mkramar/dizzyrobot/3D/3D - Motor 6.1 - presss fit/05.png

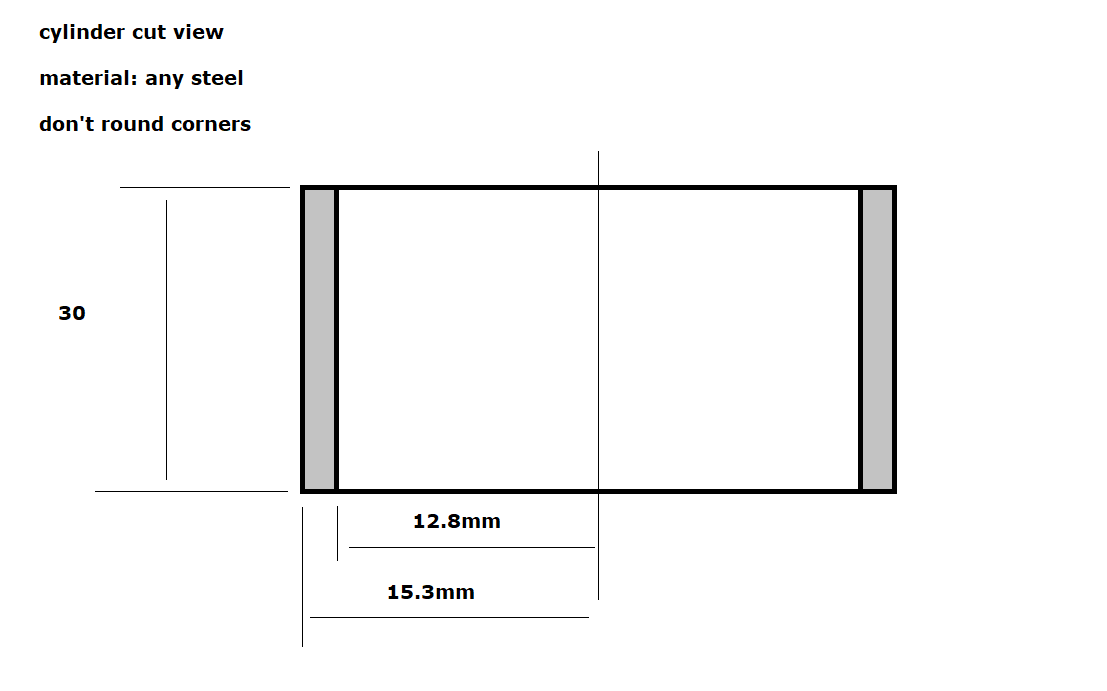
3D/3D - Motor 6.1 - presss fit/05.png
