mkramar/dizzyrobot/3D/3D - Press Fit/6-01.png

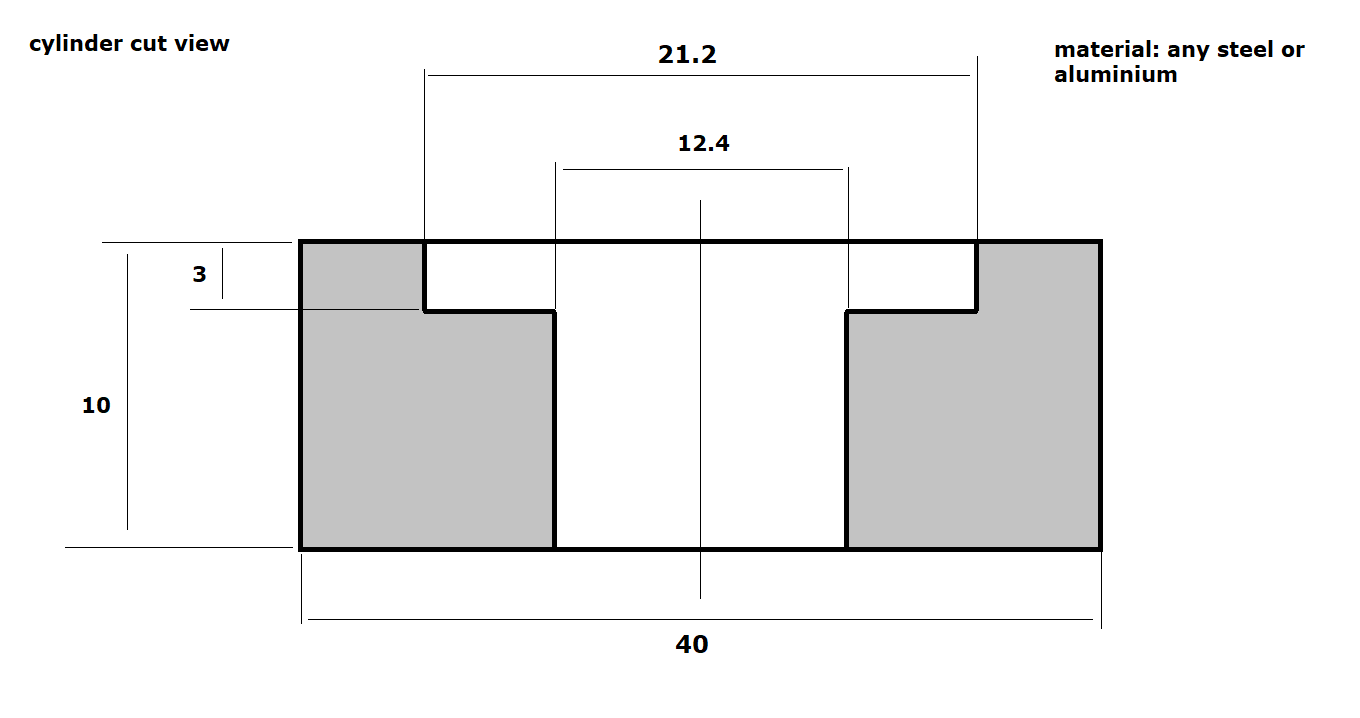
3D/3D - Press Fit/6-01.png
