mkramar/dizzyrobot/3D/3D - Press Fit/8-03.png

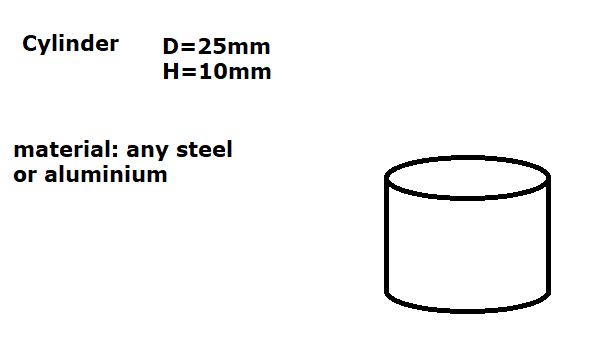
3D/3D - Press Fit/8-03.png
