mkramar/dizzyrobot/3D/3D - Press Fit/8-04.png

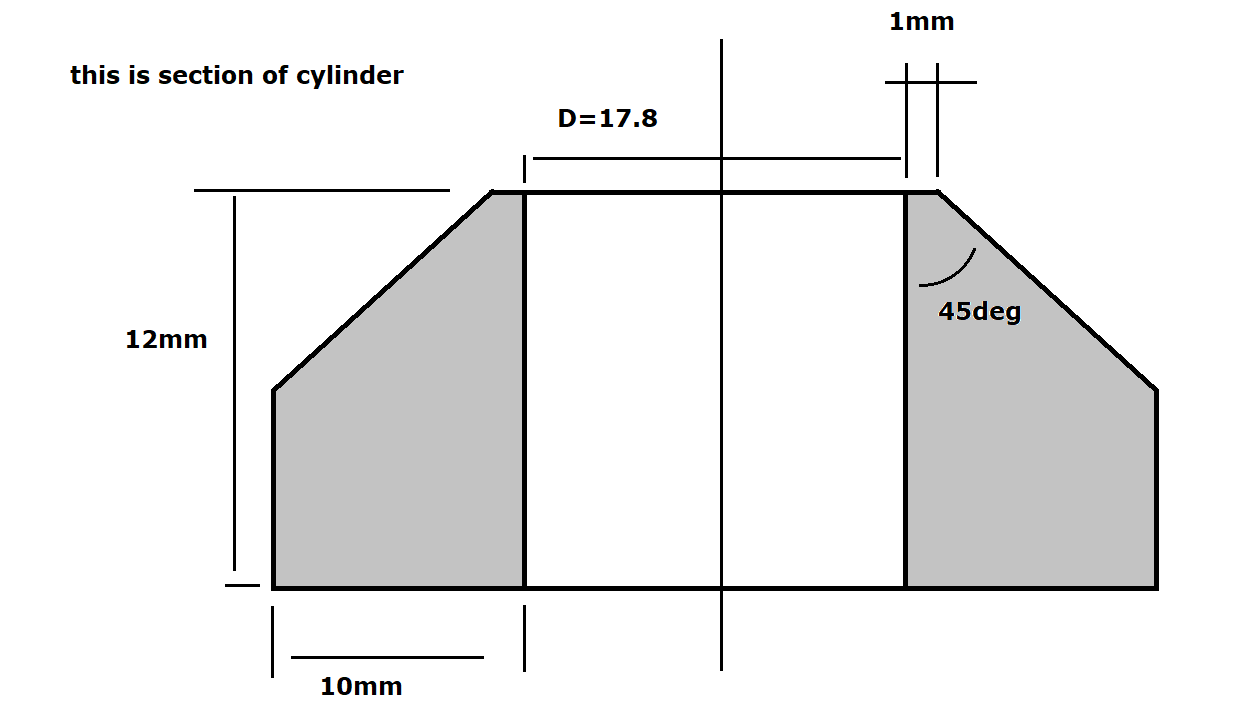
3D/3D - Press Fit/8-04.png
