mkramar/dizzyrobot/Schamatic/BOM.xlsx

Sheet: Motor
Description | Part | References | Value | Voltage | Footprint | Quantity Per PCB | Avail
 | C_Small | C10 | 0.01uF | 50V | C_0603 | 1 | 11 | 11
 | C_Small | C1 C6 C7 C12 C14 | 0.1uF | 6.3V | C_0603 | 5 | 5 | 1
 | C_Small | C2 C4 C5 C8 C9 | 1uF | 25V | C_0603 | 5 | 80 | 16
 | C_Small | C3 | 2.2uF | 100V | C_1206 | 2 | 2 | 1
 | C_Small | C11 | 4.7uF |  | C_1206 | 1 | 0 | 0
Diode 100V | D_Small | D3 D4 D5 D6 D8 | D |  | D_SOD-323F | 5 | 12 | 2.4
 | LED_Small | D1 D2 D7 | LED_Small |  | LED_0603 | 3 | 0 | 0
SWD | CONN_02X05 | J1 | CONN_02X05 |  | Pin_Header_Straight_2x05_Pitch1.27mm_SMD | 1 | 3 | 3
 | CONN_01X02 | J2 J3 | RS485 |  | Pin_Header_Straight_1x02_Pitch2.54mm | 2 |  | 0
 | L_Small | L2 | 220uH |  | L_1210 | 1 | 3 | 3
 | R_Small | R11 R13 | 10K | 1% | C_0603 | 2 | 17 | 8.5
 | R_Small | R14 | 1Ohm |  | C_0603 | 1 | 50 | 50
 | R_Small | R10 | 237K |  | R_0603 | 1 | 0 | 0
 | R_Small | R12 | 30k 1% |  | C_0603 | 1 | 16 | 16
 | R_Small | R1 R2 | 390 Ohm |  | R_0603 | 2 | 50 | 25
 | R_Small | R15 | 600 Ohm |  | R_0603 | 1 | 50 | 50
Button | B3U-1000P | SW1 SW2 | B3U-1000P |  | R_1206 | 2 | 0 | 0
Angle sensor | MA700 | U6 | MA700 |  |  | 1 | 4 | 4
half-bridge |  |  | IRSM005 |  |  | 3 | 0 | 0
100V buck | LM5019 | U4 | LM5019 |  | DFN-8-1EP_4x4mm_Pitch0.8mm | 1 | 0 | 0
RS485 | LTC2876 | U2 | LTC2876 |  | LTC2876 | 1 | 1 | 1
Microcontroller | STM32F031G6U6 | U5 | STM32F031K6U6 |  | UFQFPN32-small-pad | 1 | 1 | 1
3.3V linear regulator | TPS73433DRV | U1 | TPS73433DRV |  | DFN-6-1EP_2x2mm_Pitch0.65mm | 1 | 2 | 2
12V linear regulator | MCP1703A-1502/MB | U3 | ZXTR2012Z |  | SOT-89-3 | 1 | 2 | 2
 | Resonator | Y1 | 8MhZ |  | Oscillator | 1 | 8 | 8

Sheet: Mainboard
Description | Part | References | Value | Voltage | Footprint | Quantity Per PCB | Avail
 | C_Small | C7 C8 | 0.01uF | 50V | C_0603 | 2 |  | 0
Boost RC | C_Small | C6 | 0.022uF | 25V | C_0603 | 1 | 5 | 5
 | C_Small | C15 | 0.1uF | 25V | C_0805 | 1 | 8 | 8
 | C_Small | C19 C20 C21 C23 C24 C25 C26 | 0.1uF | 6.3V | C_0603 | 7 |  | 0
Bushbutton timer | C_Small | C27 | 0.33uF | 25V | C_0603 | 1 | 0 | 0
 | C | C4 C14 | 1uF | 25V | C_0603 | 2 |  | 0
 | C_Small | C12 C13 C28 C29 | 100uF | 6.3V | C_1210 | 4 | 7 | 1.75
 | C | C1 | 2.2uF | 25V | C_0603 | 1 | 0 | 0
 | C_Small | C2 C3 C9 C10 | 20uF |  | C_1210 | 4 | 6 | 1.5
 | C | C17 C18 | 3.3uF | 100V | C_1812 | 2 | 0 | 0
 | C_Small | C22 | 4.7uF | 25V | C_1812 | 1 | 0 | 0
 | D_Small | D8 | D_Small | 200V | D_SMA | 1 | 3 | 3
 | D_Small | D1 D2 D3 D4 D8 | D_Small | 50V | D_SMA | 4 | 10 | 2.5
 | D_Small | D5 | D_Small |  | D_SOD-323 | 1 |  | 0
 | LED_Small | D6 D7 | LED_Small |  | LED_0603 | 2 |  | 0
RS485 connector | CONN_01X02 | J1 J2 | CONN_01X02 |  | Pin_Header_Straight_1x02_Pitch2.54mm | 2 | 8 | 4
voltage connector |  | J8 J9 |  |  |  | 2 |  | 0
 | CONN_01X02 | J3 | CONN_01X02 |  | XT60 | 1 |  | 0
 | CONN_01X02 | J4 J5 | CONN_01X02 |  | xt30 | 2 |  | 0
Pushbutton connector | CONN_01X04 | J10 | CONN_01X04 |  | Pin_Header_Straight_1x04_Pitch2.54mm | 1 | 1 | 1
SWD | CONN_02X05 | J6 | CONN_02X05 |  | Pin_Header_Straight_2x05_Pitch1.27mm_SMD | 1 |  | 0
Rpi connector | CONN_02X20 | J7 | CONN_02X20 |  | Pin_Header_Straight_2x20_Pitch2.54mm | 1 | 1 | 1
 | L_Small | L1 | 15uH |  | L_10.4x10.4_H4.8 | 1 | 1 | 1
 | L_Small | L2 | 22uH |  | L_10.4x10.4_H4.8 | 1 |  | 0
 | L_Core_Ferrite | L3 | L_Core_Ferrite |  |  | 1 | 1 | 1
MOSFET 100V | PSMN014-40YS | Q1 Q2 Q3 Q4 | PSMN014-40YS |  | PSMN3R3-40YS | 4 | 15 | 3.75
Current sense resistor | R_Small | R7 | 1.5mOhm |  | R_2512 | 1 | 2 | 2
 | R_Small | R2 R3 | 10Ohm |  | R_0603 | 2 | 50 | 25
 | R_Small | R4 R15 R16 R21 | 10k |  | R_0603 | 4 |  | 0
Boost | R_Small | R6 | 18K |  | R_0603 | 1 | 12 | 12
 | R_Small | R11 R13 | 1k 1% |  | R_0603 | 2 | 90 | 45
 | R_Small | R1 | 3.3Ohm |  | R_0603 | 1 | 0 | 0
 | R_Small | R9 | 30k |  | R_0603 | 1 |  | 0
 | R_Small | R5 R19 R20 | 390Ohm |  | R_0603 | 3 |  | 0
I-ADC | R_Small | R17 | 4k | 1% | R_0603 | 1 | 7 | 7
V-ADC | R_Small | R14 | 62k | 1% | R_0603 | 1 | 7 | 7
 | R_Small | R8 | 68K |  | R_0603 | 1 | 7 | 7
I-ADC | R_Small | R18 | 6k | 1% | R_0603 | 1 | 15 | 15
 | R_Small | R10 | 75k (67, 58) |  | R_0603 | 1 | 7 | 7
Current sensor | ACS781 | U6 | ACS781 |  | ACS781 | 1 | 0 | 0
3.3V buck | LM2678 | U1 | LM2678-3.3V |  | 14-VSON | 1 | 1 | 1
 | LM2678 | U2 | LM2678-5V |  | 14-VSON | 1 |  | 0
100V boost | LM5121 | U4 | LM5121 |  | HTSSOP-20-1EP_4.4x6.5mm_Pitch0.65mm_ThermalPad | 1 | 2 | 2
Accelerometer | LSM6DS33 | U7 | LSM6DS33 |  | LGA16R50P3X5_300X300X100 | 1 | 2 | 2
 | LTC2876 | U9 | LTC2876 |  | LTC2876 | 1 |  | 0
Bushbutton | LTC2954 | U10 | LTC2954 |  | 8-DFN-DDB | 1 | 1 | 1
 | STM32F031G6U6 | U8 | STM32F031G6U6 |  | UFQFPN32-small-pad | 1 |  | 0
Three pin ceramic resonator | Resonator_Small | Y1 | Resonator_Small |  | Oscillator | 1 |  | 0
