mkramar/dizzyrobot/Electronics/Motor/Bom.xlsx

Part | References | Value | Voltage | Footprint | Per PCB | In Stock | Can Make | Order
Cap | C7 C8 | 0.1uF | 6.3V | 0603 | 2 | 60 | 30 | 0
Cap | C1 | 100uF | 4V | 0805 | 1 | 10 | 10 | 10
Cap | C3 C9 | 2uF | 50V | 1206 | 2 | 24 | 12 | 16
Cap | C4 C5 C6 | 1uF | 25V | 0603 | 3 | 40 | 13.33333333 | 20
Cap | C2 | 22uF | 25V | 0805 | 1 | 12 | 12 | 8
Diode | D1 D4 | CD0603-B0340R | 100V | D_SOD-323F | 1 | 80 | 80 | 0
LED | D5 |  |  | 0805 | 1 | 0 | 0 | 20
BUTTON | ID1 |  |  | 1206 | 1 | 0 | 0 | 20
CONN_02X05 | J5 | JTAG |  |  | 1 | 5 | 5 | 15
CONN_01X02 | J2 J3 | RS485 |  |  | 2 | 7 | 3.5 | 33
L | L1 | 22uH |  | 1210 | 1 | 10 | 10 | 10
MOSFET | Q1 Q2 Q3 Q4 Q5 Q6 | PSMN3R3-40YS |  | PSMN3R3-40YS | 6 | 58 | 9.666666667 | 62
R | R3 R4 R5 R6 R7 R8 | 10 Ohm |  | 0603 | 6 | 70 | 11.66666667 | 50
R | R10 | 10k |  | 0604 | 1 | 70 | 70 | 0
R | R2 | 390 Ohm |  | 0605 | 1 | 25 | 25 | 0
LTC2876 | U2 | LTC2876 |  |  | 1 | 4 | 4 | 16
MA700 | U3 | MA700 |  |  | 2 | 6 | 3 | 34
STSPIN32F0 | U1 | STSPIN32F0 |  |  | 1 | 8 | 8 | 12
Resonator | Y1 | 8Mhz |  |  | 1 | 7 | 7 | 13
 |  |  |  | Req | 20
