mkramar/dizzyrobot/Electronics/Mainboard/Schematic/BOM.xlsx

Description | Part | References | Value |  | Footprint | Quantity Per PCB | Stock | Order
Buck boost capacitor | C | C7 C8 | 0.01uF | 25V | 0603 | 2 | 7
Delimiting capacitors | C | C6 C19 C20 C21 C23 C24 C25 C26 | 0.1uF | 25V | 0603 | 8 | 100
Off timeout capacitor | C | C27 | 0.33uF |  | 0603 | 1 | 8
Buck output | C | C13 C29 | 100uF | 16V | 1210 | 2 | 0 | 6
Buck output | C | C12 C28 | 100uF | 4V | 1210 | 2 | 3 | 5
Buck input | C |  | MAX | 50V | 1210 | 4 | 0 | 10+
Battery input/output | C | C22 | MAX | 50V | 1812 | 2 | 0 | 10+
Diode | D | D1 D2 D3 D4 D8 | D_Small |  | D_SMA | 6 | 1 | 15
LED | LED | D6 D7 | LED_Small |  | LED_0603 | 2 | 30
JTAG | 10-pin | J6 | CONN_02X05 |  | Pin_Header_Straight_2x05_Pitch1.27mm_SMD | 1 | 10
SPI/POWER | 20-pin | J7 | CONN_02X10 |  | Pin_Header_Straight_2x10_Pitch2.54mm_SMD | 1 | 2
3.3V inductor | L | L1 | 15uH |  | L_10.4x10.4_H4.8 | 1 | 1 | 1
12V inductor | L | L2 | 33uH |  | L_10.4x10.4_H4.8 | 1 | 1 | 1
P-MOSFET |  | Q2 |  | 100V 60A |  | 1 | 2 | 2 | - higher current
N-MOSFET |  | Q1 |  | 100V |  | 1 | 8
R | R | R4 R15 R16 R21 | 10k |  | 0603 | 4 | 6 | 10+
R | R | R13, R11 | 1k 1% |  | 0603 | 1 | 100
R | R | R6 | 30K |  | 0603 | 1 | 100
R | R | R5 R19 R20 | 390 Ohm |  | 0603 | 3 | 100
R | R | R17 | 4k | 1% | 0603 | 1 | 10
R | R | R14 | 30K 1% |  | 0603 | 1 | 100
R | R | R18 | 6k | 1% | 0603 | 1 | 12
Current sensor | ACS781 | U6 |  |  |  | 1 | 1 | 2
 | LM2678 | U2 | LM2678-12V |  | 14-VSON | 1 | 11
 | LM2678 | U1 | LM2678-3.3V |  | 14-VSON | 1 | 1 | 2
Gyro | LSM6DS33 | U7 |  |  |  | 1 | 1 | 2
RS485 | LTC2876 | U9 | LTC2876 |  | LTC2876 | 1 | 11
Push button controller | LTC2954 | U10 | LTC2954 |  | 8-DFN-DDB | 1 | 2 | 1
MCU | STM32F031G6U6 | U8 | STM32F031G6U6 |  | UFQFPN32-small-pad | 1 | 1 | 2
Ceramic resonator | Resonator_Small | Y1 | Resonator_Small |  | Oscillator | 1 | 1 | 2
12 Linear Regulator |  |  | ZXTR2012Z |  |  | 1 | 1 | 2
 | To Make: | 3
