mkramar/dizzyrobot/3D/3D - Motor 5/ECG S assembly.SLDASM

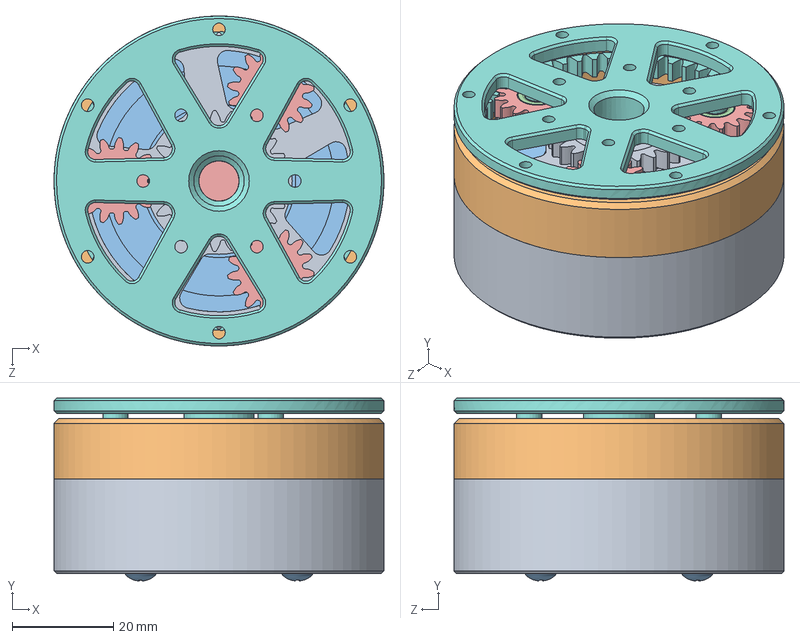
[picture p12: CAD file, 2018-11-04]
3D/3D - Motor 5/ECG S assembly.SLDASM
65.3 x 36.1 x 65.3 mm
Housing base
Housing top cover
Motor core S
Rotor magnet ring
M07900 slipring
PCB S
Magnetinc position ring
External rotor
Internal rotor
6701 - 12x18x4 mm x 3
92000A076_18-8 SS METRIC PAN HEAD PHIL MACHINE SCREW x 4
7804K126_STAINLESS STEEL BALL BEARING x 3
Planet gear M1 Z15 bore 8 x 3
M1408-0120 x 3
Positioning magnet x 14
Ring gear M1 Z56 OD62
Sun gear M1 Z25 bore 20 CD20.5
