mkramar/dizzyrobot/3D/3D - Motor 6.1/motor 6/Gearing assembly.SLDASM

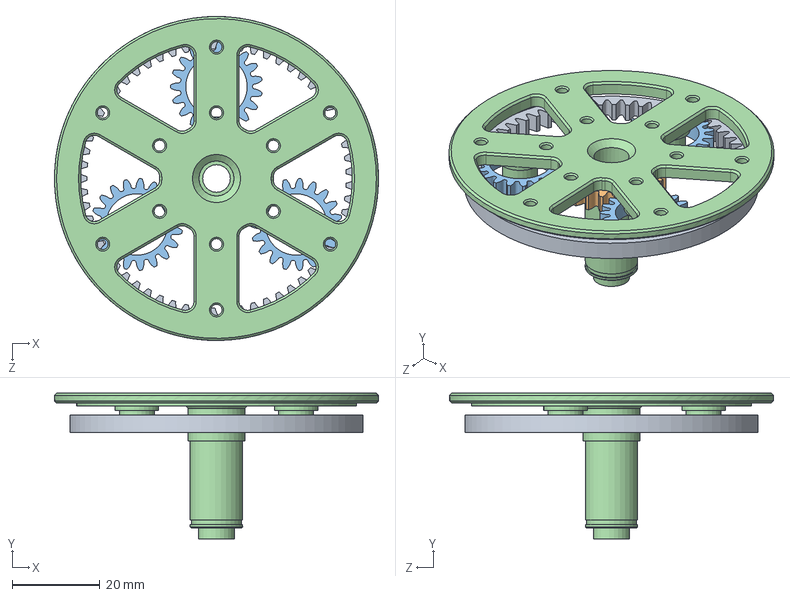
[picture p13: CAD file, 2019-03-31]
3D/3D - Motor 6.1/motor 6/Gearing assembly.SLDASM
74.0 x 33.3 x 74.0 mm
Ring gear Z61 M1
Sun gear Z23 H17 M1
Planet gear Z19 H13 M1 x 3
