mkramar/dizzyrobot/3D/3D - Motor 8/Drawings/Gearing.SLDASM

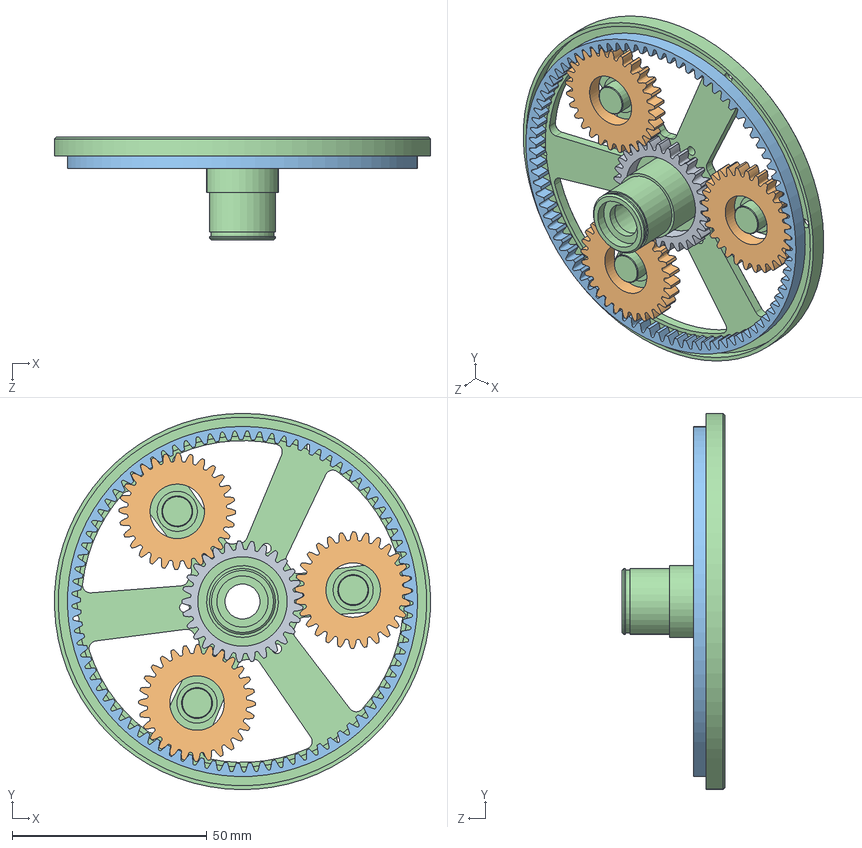
[picture p14: CAD file, 2018-12-22]
3D/3D - Motor 8/Drawings/Gearing.SLDASM
96.7 x 96.7 x 26.5 mm
Sun Gear M1 Z29 bore 23
Planet Gear M1 Z28 bore 14 x 3
Ring gear M1 Z85 OD90
