mkramar/dizzyrobot/3D/NEW MODEL/MODEL 6/ASSEMBLY/SMALL PART - MOTOR 6.SLDASM

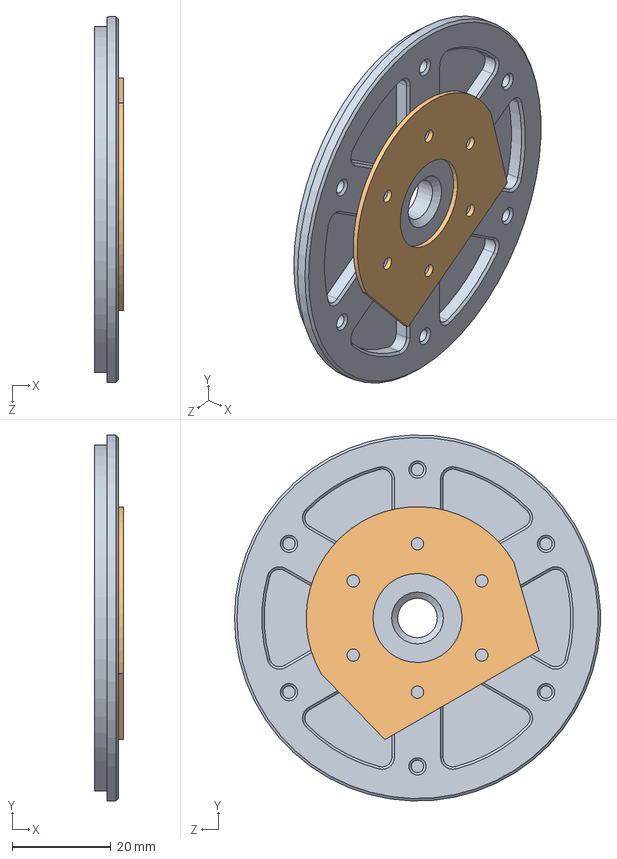
[picture p15: CAD file, 2020-03-14]
3D/NEW MODEL/MODEL 6/ASSEMBLY/SMALL PART - MOTOR 6.SLDASM
5.80 x 74.0 x 74.0 mm
PART 1 - MOTOR 6 - ROBOT DOG
SMALL CONTROLLER - ROBOT DOG
