mkramar/dizzyrobot/3D/NEW MODEL/MOTOR 8/ASSEMBLY/MOTOR 8 ASSEMBLY.SLDASM

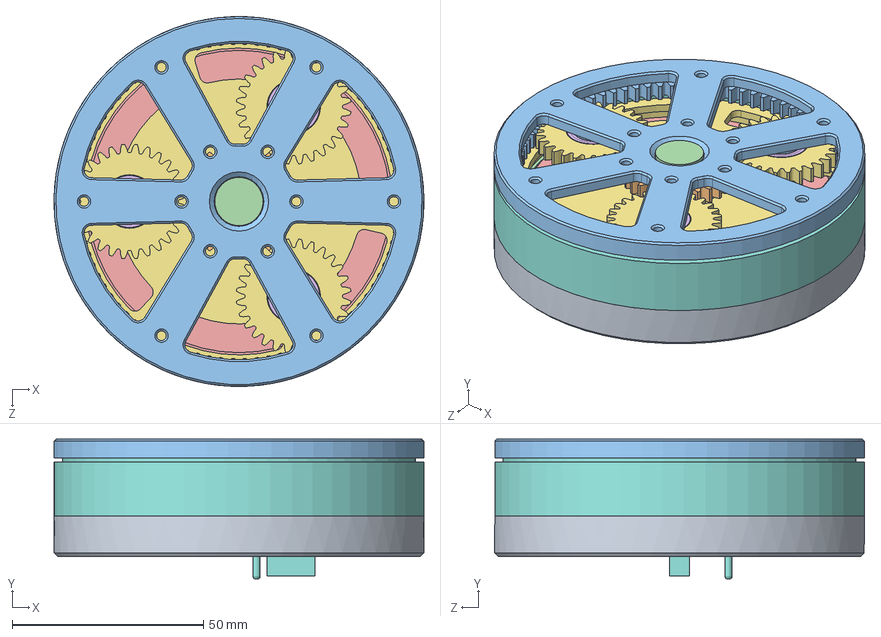
[picture p16: CAD file, 2020-03-14]
3D/NEW MODEL/MOTOR 8/ASSEMBLY/MOTOR 8 ASSEMBLY.SLDASM
96.7 x 36.5 x 96.7 mm
HOUSING BASE - MOTOR 8
6803 17x26x5 mm BEARING_5972K213 - MOTOR 8 x 2
CARRIER - MOTOR 8
SLIPRING - MOTOR 8
MAGNETING POSITION RING - MOTOR 8
6706 30x37x4 mm BEARING_5972K213 - MOTOR 8 x 2
ROTOR FRAME - MOTOR 8
HOUSING COVER - MOTOR 8
POSITIONING MAGNET . MOTOR 8 x 42
SUN GEAR M1 Z28 bore 23_GEAR TRAX - MOTOR 8
RING GEAR M1 Z84_GEAR TRAX - MOTOR 8
MAGNET RING - MOTOR 8
MOTOR CORE - MOTOR 8
148-2Z_7804K116 - MOTOR 8 x 3
PLANET GEAR M1 Z28 bore 14_GEAR TRAX - MOTOR 8 x 3
BIGGER CONTROLLER - ROBOT DOG
