mkramar/dizzyrobot/3D/ROBOT.SLDASM

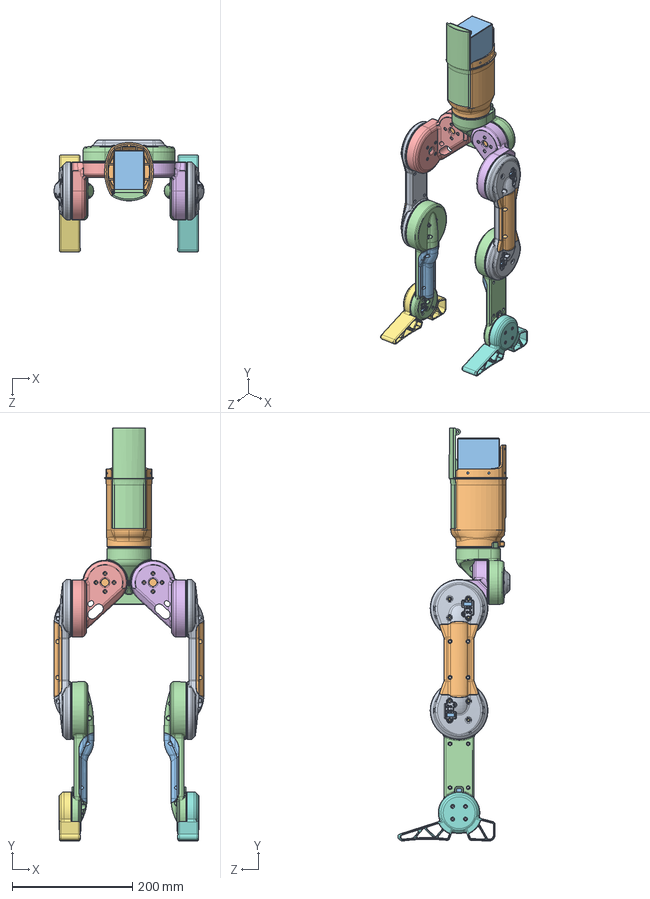
[picture p17: CAD file, 2018-05-21]
3D/ROBOT.SLDASM
249.4 x 687.0 x 187.1 mm
MOTOR 6 - BOTTOM x 3
MOTOR 6 - TOPPER x 3
BIGGER CONTROLLER x 9
ASS
ARTICULATION
MirrorARTICULATION
MOTOR 9 - BOTTOM x 4
MOTOR 9 - TOPPER x 4
THIGH x 2
COVER OF THE THIGH x 2
COVER OD THE SHIN x 2
SHIN x 2
MOTOR 5 - BOTTOM x 2
MOTOR 5 - TOPPER x 2
FOOT
MirrorFOOT
COVER OF THE ASS
TORSO
BATTERY
COVER OF THE BATTERY
