mkramar/dizzyrobot/3D/Wolf/V2/BIG PART MOTOR 8.SLDASM

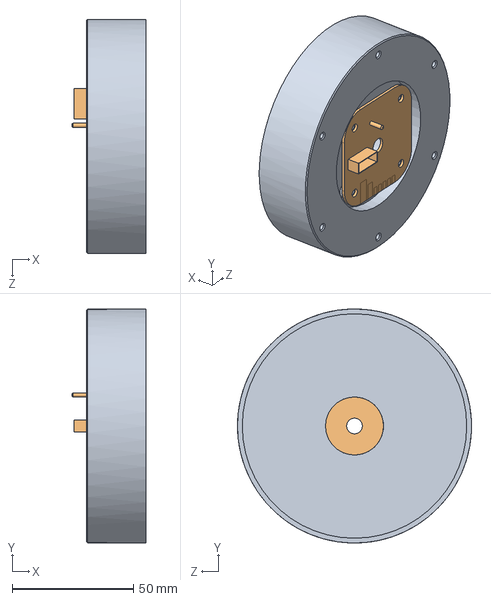
[picture p18: CAD file, 2019-07-20]
3D/Wolf/V2/BIG PART MOTOR 8.SLDASM
30.6 x 96.7 x 96.7 mm
PART 2 - MOTOR 8 - ROBOT DOG
BIGGER CONTROLLER - ROBOT DOG
