mkramar/dizzyrobot/3D/NEW MODEL/MODEL 6/ASSEMBLY/BIGGER MOTOR 6 ASSEMBLY.SLDASM

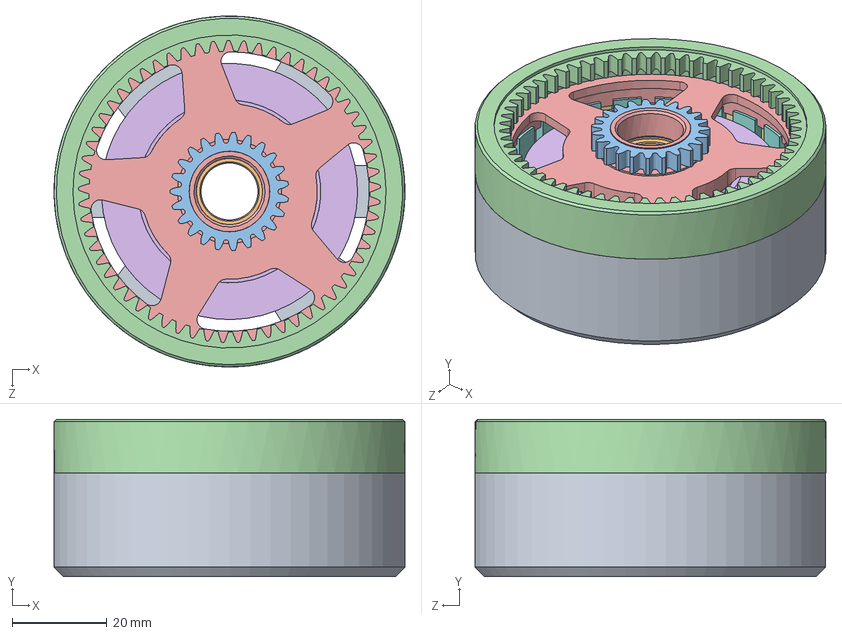
[picture p19: CAD file, 2020-03-14]
3D/NEW MODEL/MODEL 6/ASSEMBLY/BIGGER MOTOR 6 ASSEMBLY.SLDASM
74.0 x 33.2 x 74.0 mm
HOUSING BASE - MOTOR 6
6801 BEARING 12x21x5_5972K212 - MOTOR 6 x 3
12x1 mm SPACER RING - MOTOR 6 x 3
HOUSING COVER - MOTOR 6
ROTOR - MOTOR 6
STATOR - MOTOR 6
OUTER RING - MOTOR 6
ROTOR MAGNET 12x6x2 - MOTOR 6 x 22
POSITIONING MAGNET D4 - MOTOR 6 x 24
KLM-21 INTERNAL RETAINING RING FOR hID 21 mm
SUN GEAR Z23 H17 M1_GEAR TRAX - MOTOR 6
RING GEAR Z61 M1_GEAR TRAX - MOTOR 6
