mkramar/dizzyrobot/3D/NEW MODEL/MOTOR 8/ASSEMBLY/SMALL PART MOTOR 8.SLDASM

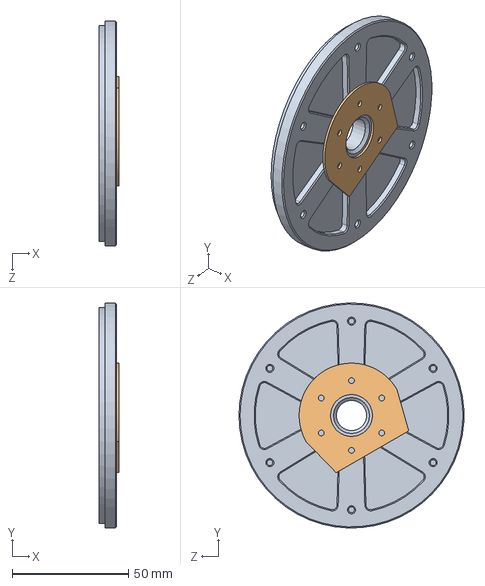
[picture p20: CAD file, 2020-03-14]
3D/NEW MODEL/MOTOR 8/ASSEMBLY/SMALL PART MOTOR 8.SLDASM
8.45 x 96.7 x 96.7 mm
PART 1 - MOTOR 8 - ROBOT DOG
SMALL CONTROLLER - ROBOT DOG
