mkramar/dizzyrobot/3D/Wolf/V2/PARTS/Controller assembly.SLDPRT

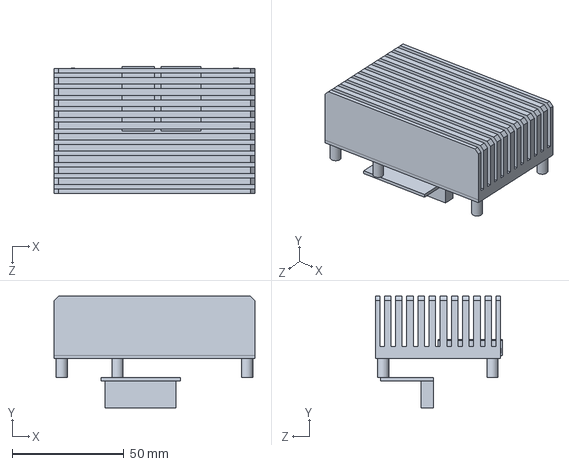
[picture p21: CAD file, 2019-07-20]
3D/Wolf/V2/PARTS/Controller assembly.SLDPRT
90.0 x 50.0 x 57.0 mm
