mkramar/dizzyrobot/3D/NEW MODEL/MODEL 6/ASSEMBLY/BIG PART - MOTOR 6.SLDASM

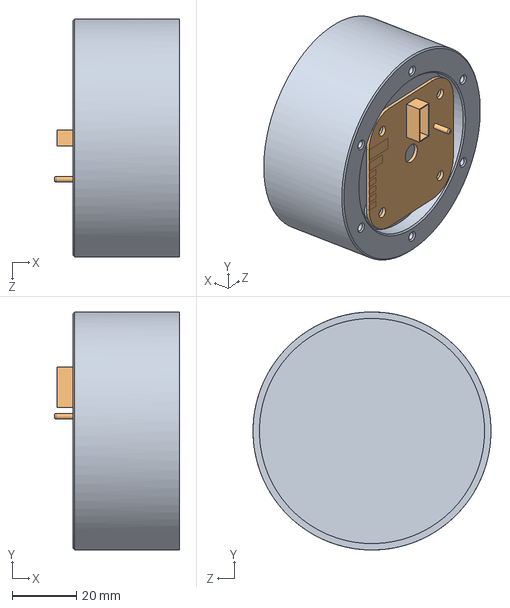
[picture p22: CAD file, 2020-03-14]
3D/NEW MODEL/MODEL 6/ASSEMBLY/BIG PART - MOTOR 6.SLDASM
39.0 x 74.0 x 74.0 mm
PART 2 - MOTOR 6 - ROBOT DOG
BIGGER CONTROLLER - ROBOT DOG
