mkramar/dizzyrobot/3D/NEW MODEL/MOTOR 8/ASSEMBLY/BIGGER MOTOR 8 ASSEMBLY.SLDASM

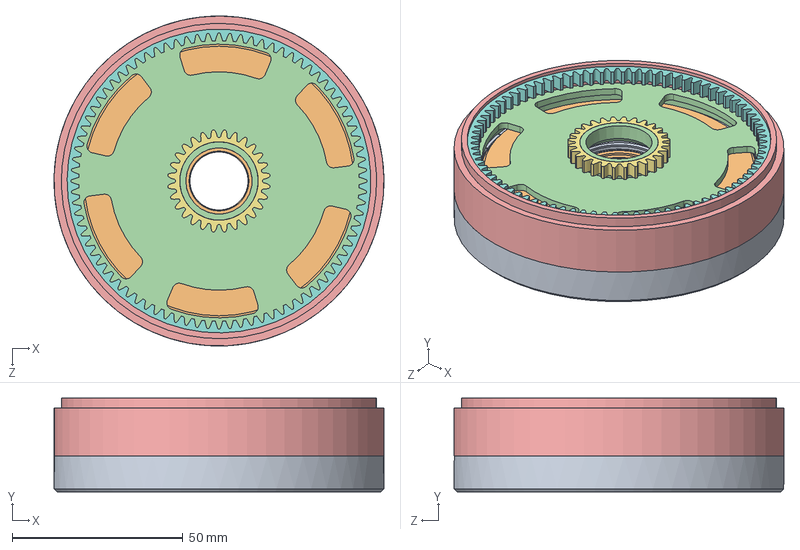
[picture p23: CAD file, 2020-03-14]
3D/NEW MODEL/MOTOR 8/ASSEMBLY/BIGGER MOTOR 8 ASSEMBLY.SLDASM
96.7 x 27.5 x 96.7 mm
HOUSING BASE - MOTOR 8
6803 17x26x5 mm BEARING_5972K213 - MOTOR 8 x 2
6706 30x37x4 mm BEARING_5972K213 - MOTOR 8 x 2
ROTOR FRAME - MOTOR 8
HOUSING COVER - MOTOR 8
POSITIONING MAGNET . MOTOR 8 x 42
SUN GEAR M1 Z28 bore 23_GEAR TRAX - MOTOR 8
RING GEAR M1 Z84_GEAR TRAX - MOTOR 8
MAGNET RING - MOTOR 8
MOTOR CORE - MOTOR 8
