mkramar/dizzyrobot/3D/3D - Motor 6/Motor 6.SLDASM

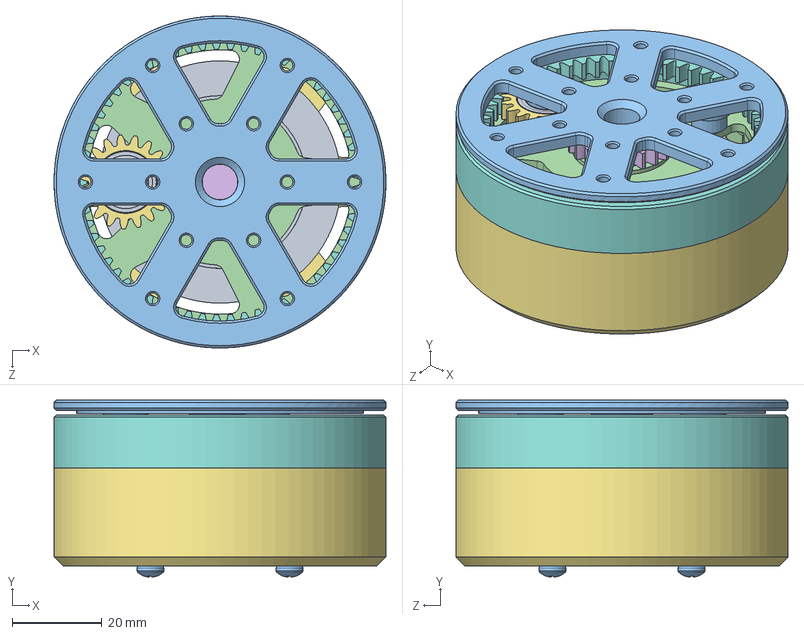
[picture p24: CAD file, 2018-12-22]
3D/3D - Motor 6/Motor 6.SLDASM
74.0 x 39.4 x 74.0 mm
Stator
Outer ring
Carrier
Rotor
PCB
M07900 slipring
Housing base
Housing cover
Positioning magnet D4 x 24
Magnetinc carrier position ring
M3 x 3 mm pan head phillips screw x 4
Rotor magnet 12x6x2 x 22
6801 bearing 12x21x5 x 3
Sun gear Z23 H17 M1
Planet gear Z19 H13 M1
Ring gear Z61 M1
148 8x14x4 mm bearing
12x1 mm spacer ring x 3
