mkramar/dizzyrobot/3D/NEW MODEL/MOTOR 8/ASSEMBLY/SMALL MOTOR 8 ASSEMBLY.SLDASM

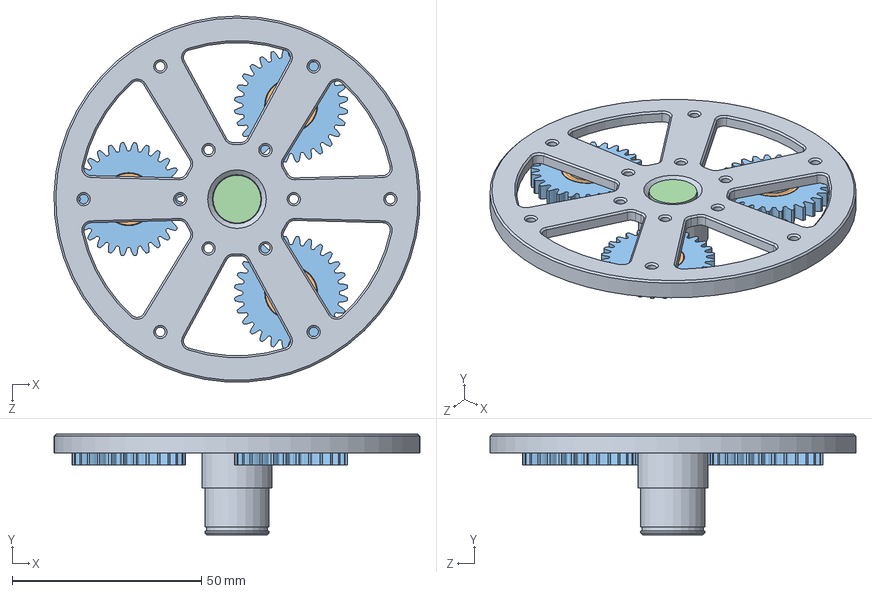
[picture p26: CAD file, 2020-03-14]
3D/NEW MODEL/MOTOR 8/ASSEMBLY/SMALL MOTOR 8 ASSEMBLY.SLDASM
96.7 x 26.5 x 96.6 mm
CARRIER - MOTOR 8
148-2Z_7804K116 - MOTOR 8 x 3
PLANET GEAR M1 Z28 bore 14_GEAR TRAX - MOTOR 8 x 3
SLIPRING - MOTOR 8
MAGNETING POSITION RING - MOTOR 8
