mkramar/dizzyrobot/Mold/Hip/Hip silicone mold assembly.SLDPRT

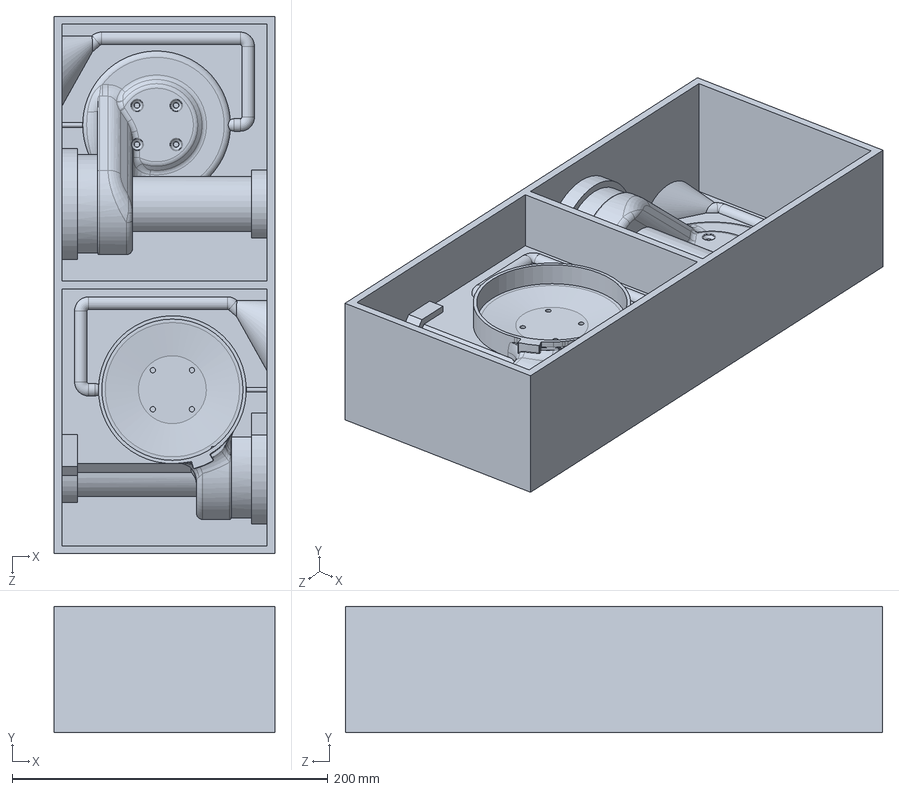
[picture p27: CAD file, 2018-03-08]
Mold/Hip/Hip silicone mold assembly.SLDPRT
140.0 x 80.0 x 340.4 mm
