mkramar/dizzyrobot/3D/3D - alternative/extra/6710 bearing 62x50x6 mm.SLDPRT

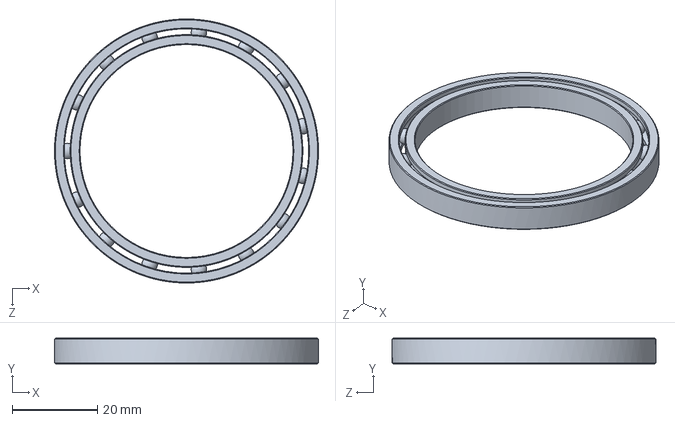
[picture p28: CAD file, 2018-10-16]
3D/3D - alternative/extra/6710 bearing 62x50x6 mm.SLDPRT
62.0 x 6.00 x 62.0 mm
