mkramar/dizzyrobot/3D/3D - alternative/Gearing/Ring gear M1 Z55.SLDPRT

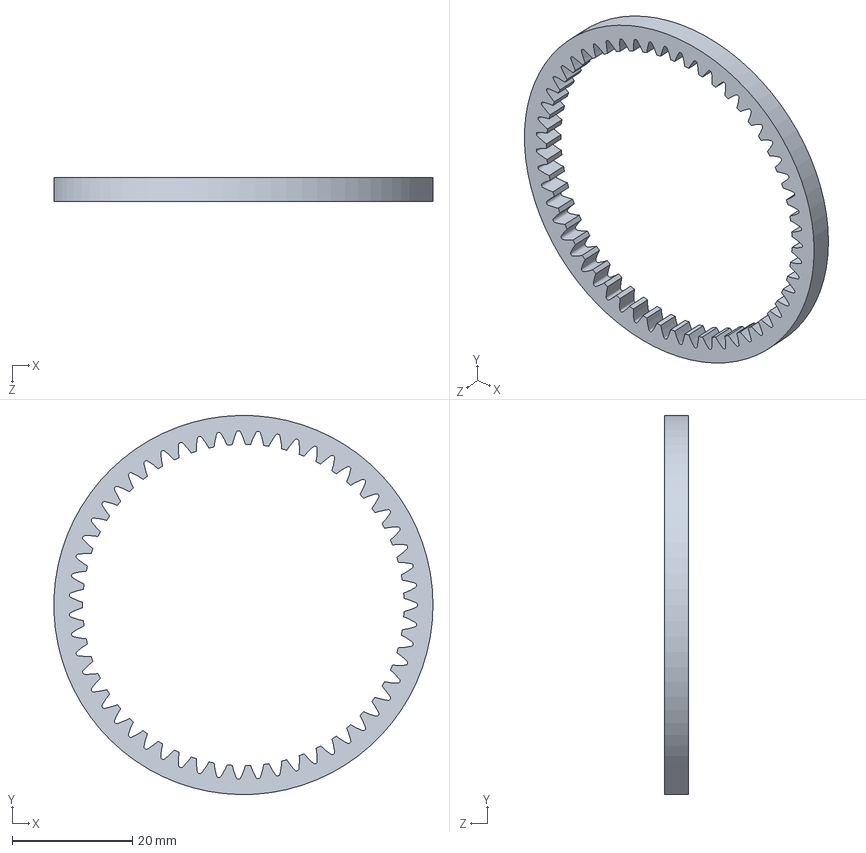
[picture p29: CAD file, 2018-10-16]
3D/3D - alternative/Gearing/Ring gear M1 Z55.SLDPRT
63.0 x 63.0 x 4.00 mm
