mkramar/dizzyrobot/3D/3D - alternative/Housing base.SLDPRT

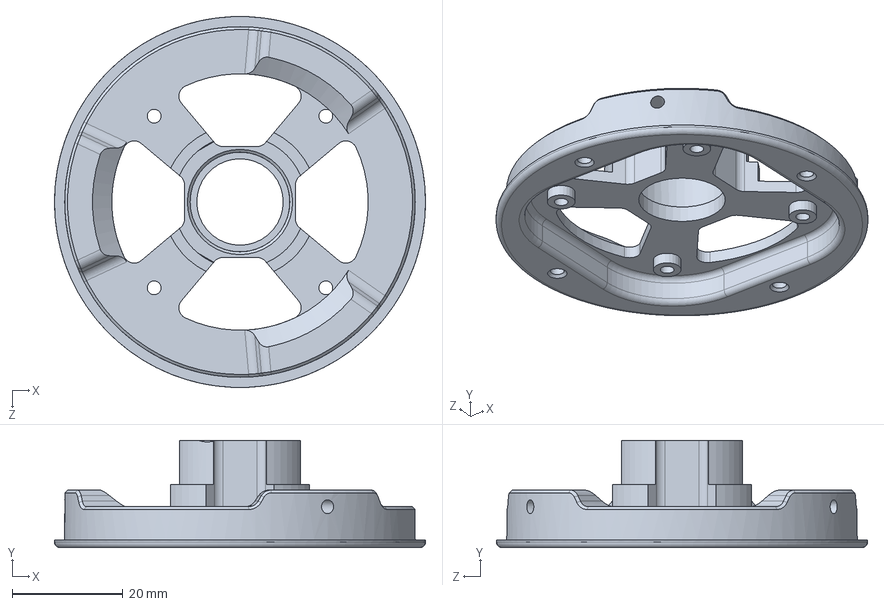
[picture p30: CAD file, 2018-10-16]
3D/3D - alternative/Housing base.SLDPRT
67.0 x 19.4 x 67.0 mm
