mkramar/dizzyrobot/3D/3D - Motor 5/extra/6701 - 12x18x4 mm.SLDPRT

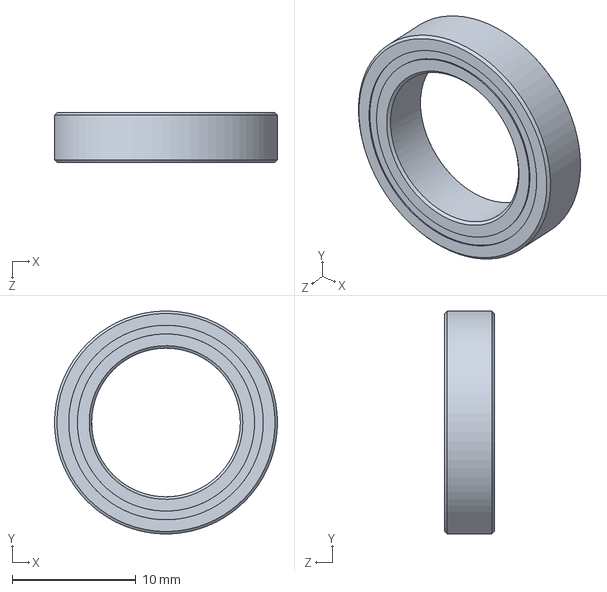
[picture p31: CAD file, 2018-10-10]
3D/3D - Motor 5/extra/6701 - 12x18x4 mm.SLDPRT
18.0 x 18.0 x 4.00 mm
