mkramar/dizzyrobot/3D/3D - Motor 5/Gearing/Ring gear M1 Z56 OD62.SLDPRT

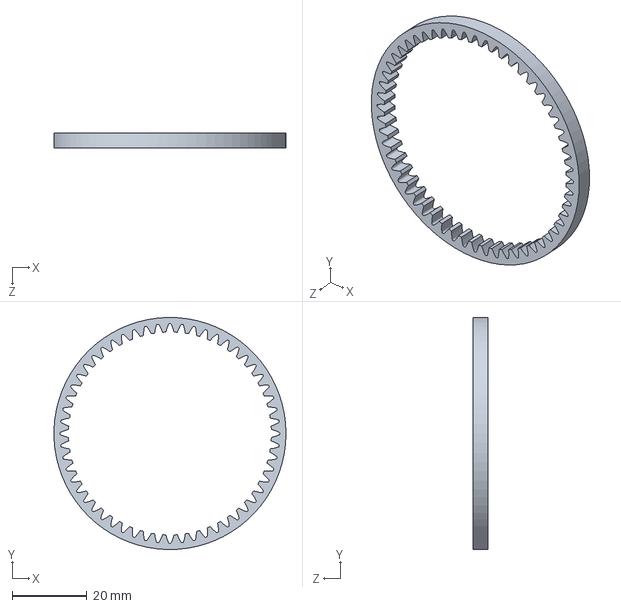
[picture p32: CAD file, 2018-12-15]
3D/3D - Motor 5/Gearing/Ring gear M1 Z56 OD62.SLDPRT
62.0 x 62.0 x 4.00 mm
