mkramar/dizzyrobot/3D/3D - Motor 6.1/Carrier.SLDPRT

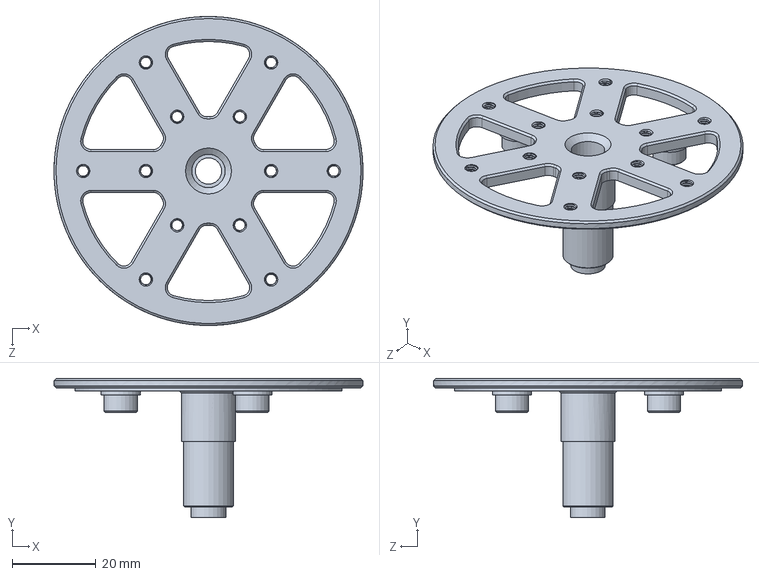
[picture p33: CAD file, 2019-03-31]
3D/3D - Motor 6.1/Carrier.SLDPRT
74.0 x 33.3 x 74.0 mm
