mkramar/dizzyrobot/3D/3D - Motor 6.1/Gearing/Planet gear Z19 H13 M1.SLDPRT

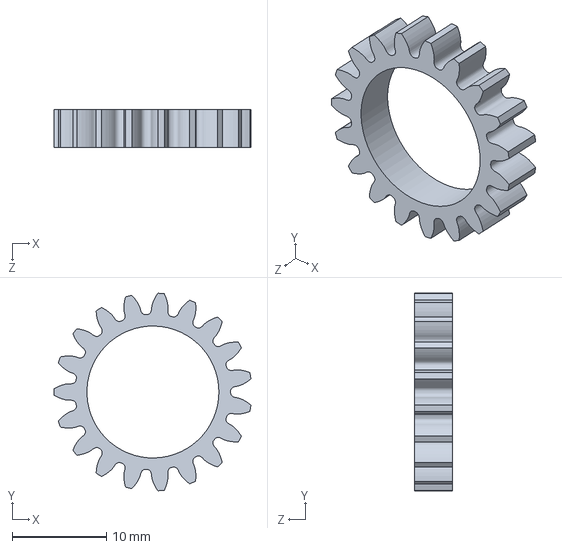
[picture p34: CAD file, 2019-02-16]
3D/3D - Motor 6.1/Gearing/Planet gear Z19 H13 M1.SLDPRT
20.9 x 21.0 x 4.00 mm
