mkramar/dizzyrobot/3D/3D - Motor 6/extra/6705 bearing 25x32x4.SLDPRT

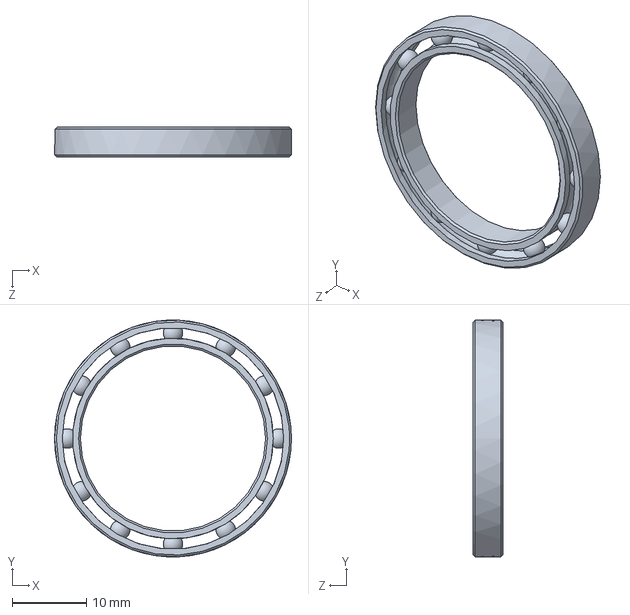
[picture p35: CAD file, 2019-02-16]
3D/3D - Motor 6/extra/6705 bearing 25x32x4.SLDPRT
32.0 x 32.0 x 4.00 mm
