mkramar/dizzyrobot/3D/3D - Motor 6/Gearing/Ring gear Z61 M1.SLDPRT

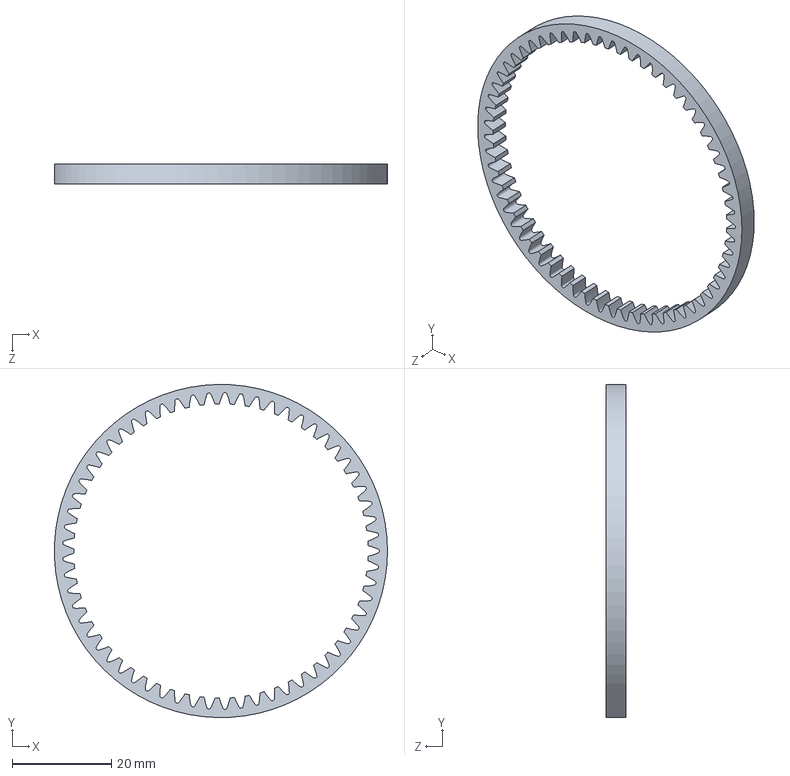
[picture p36: CAD file, 2018-12-15]
3D/3D - Motor 6/Gearing/Ring gear Z61 M1.SLDPRT
67.0 x 67.0 x 4.00 mm
