mkramar/dizzyrobot/3D/3D - Motor 6/Rotor tool.SLDPRT

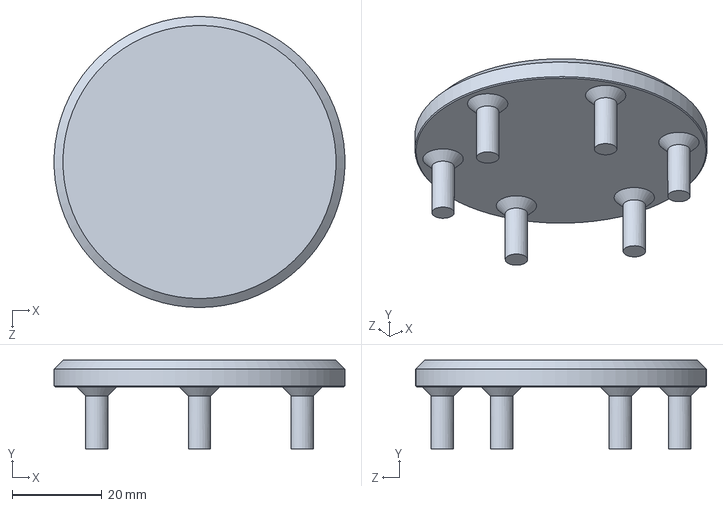
[picture p37: CAD file, 2019-03-31]
3D/3D - Motor 6/Rotor tool.SLDPRT
64.9 x 19.8 x 65.0 mm
