mkramar/dizzyrobot/3D/3D - Motor 8/Carrier.SLDPRT

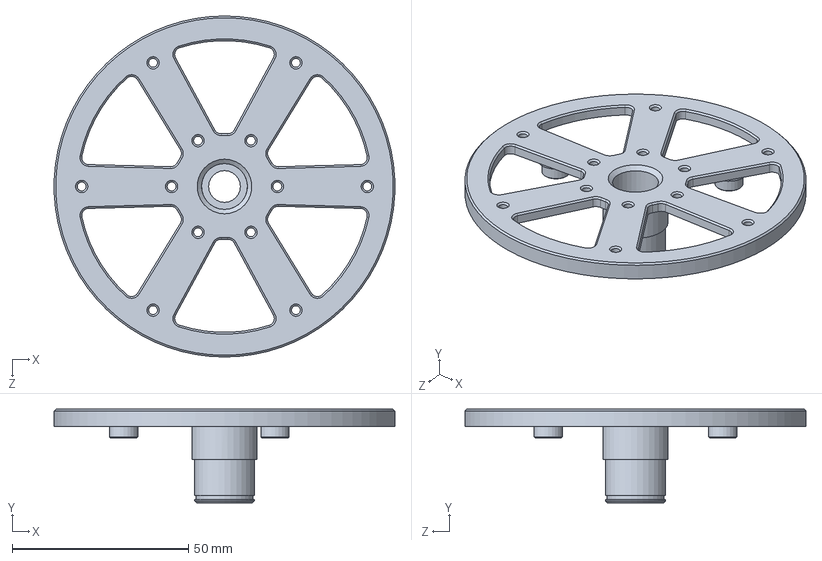
[picture p38: CAD file, 2018-12-22]
3D/3D - Motor 8/Carrier.SLDPRT
96.6 x 26.5 x 96.7 mm
