mkramar/dizzyrobot/3D/3D - Motor 8/extra/6706 30x37x4 mm bearing.SLDPRT

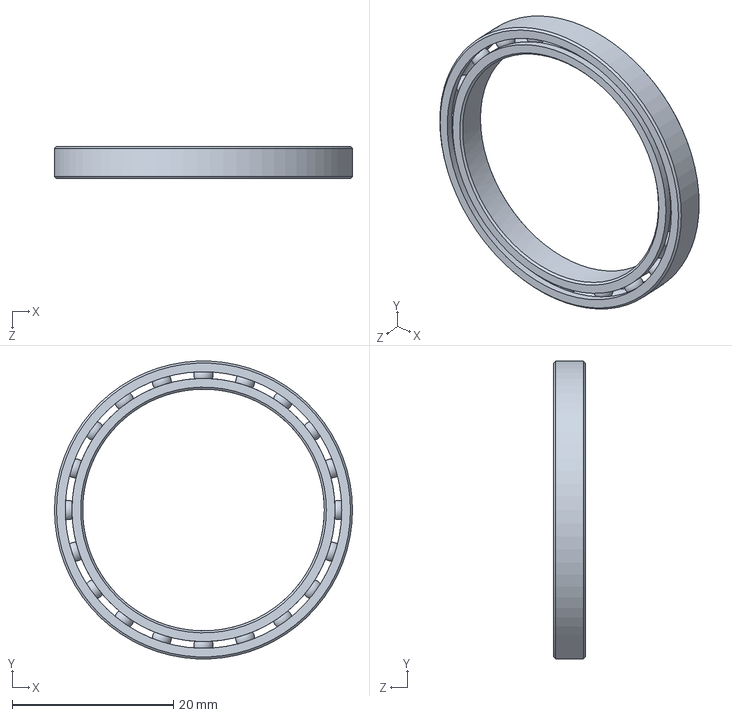
[picture p39: CAD file, 2018-12-09]
3D/3D - Motor 8/extra/6706 30x37x4 mm bearing.SLDPRT
37.0 x 37.0 x 4.00 mm
