mkramar/dizzyrobot/3D/3D - Motor 8/Gearing/Sun Gear M1 Z29 bore 23.SLDPRT

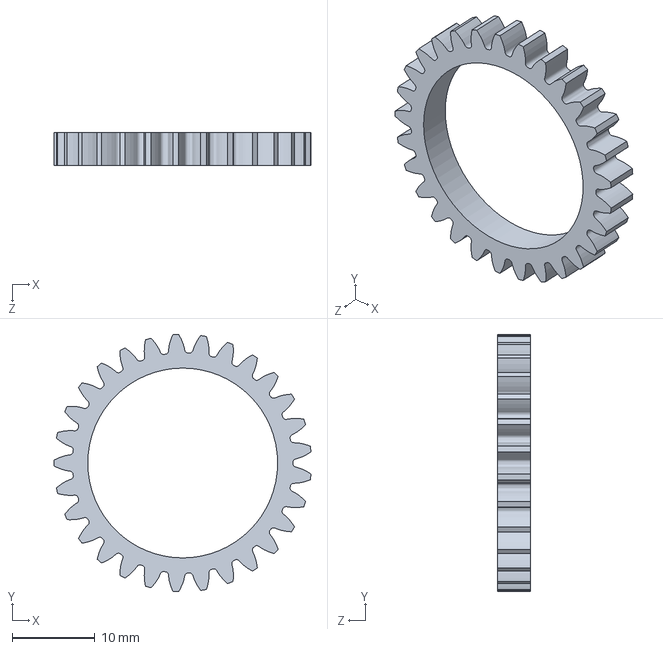
[picture p40: CAD file, 2018-12-15]
3D/3D - Motor 8/Gearing/Sun Gear M1 Z29 bore 23.SLDPRT
31.1 x 31.2 x 4.00 mm
