mkramar/dizzyrobot/3D/3D - Motor 8/motor 8/Housing base.SLDPRT

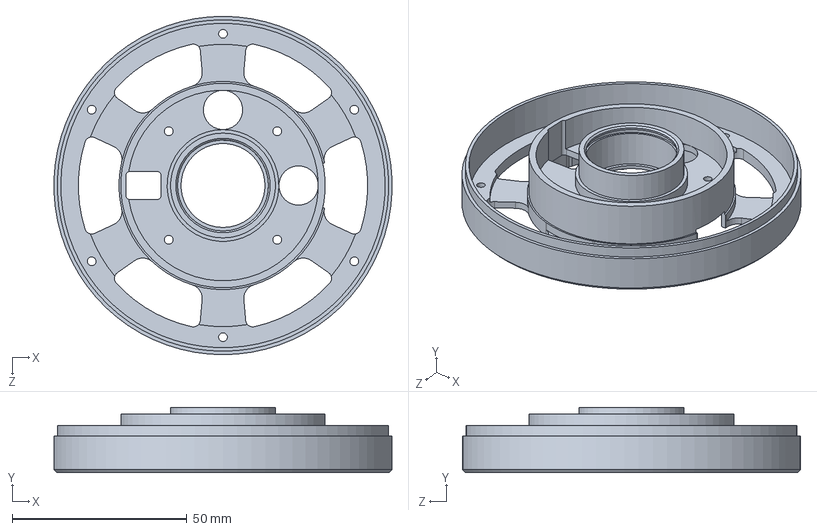
[picture p41: CAD file, 2018-12-22]
3D/3D - Motor 8/motor 8/Housing base.SLDPRT
96.6 x 18.6 x 96.7 mm
