mkramar/dizzyrobot/3D/NEW MODEL/ITEM/CONTROLLER BEHIND OF THE BATTERY - ROBOT DOG 38MM WITDH.SLDPRT

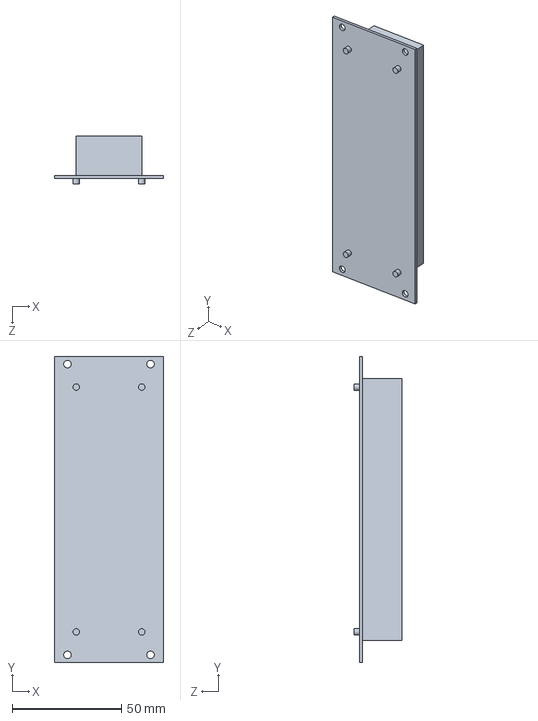
[picture p42: CAD file, 2020-03-14]
3D/NEW MODEL/ITEM/CONTROLLER BEHIND OF THE BATTERY - ROBOT DOG 38MM WITDH.SLDPRT
50.0 x 140.0 x 21.9 mm
