mkramar/dizzyrobot/3D/NEW MODEL/MODEL 6/PART/PART 2 - MOTOR 6 - ROBOT DOG.SLDPRT

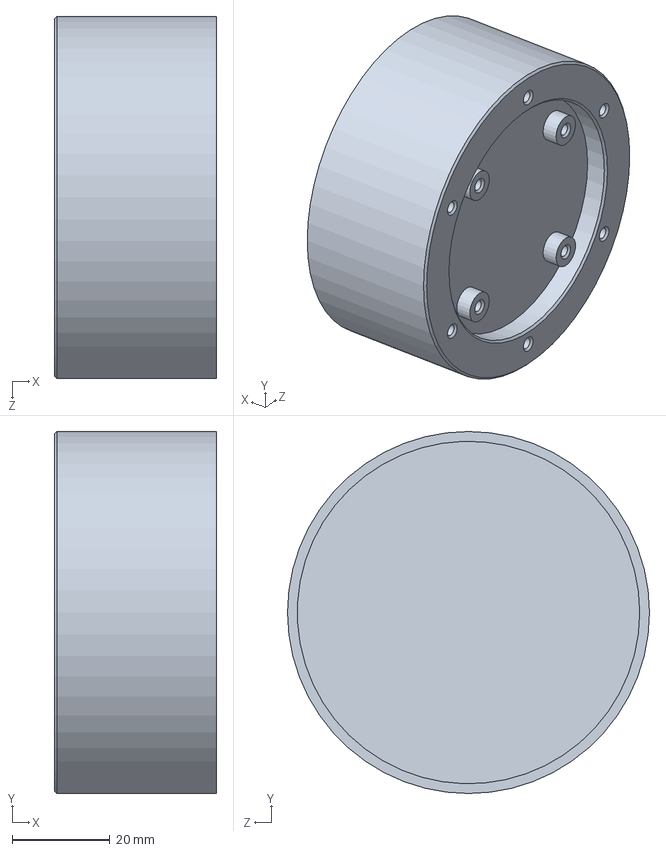
[picture p43: CAD file, 2020-03-14]
3D/NEW MODEL/MODEL 6/PART/PART 2 - MOTOR 6 - ROBOT DOG.SLDPRT
33.2 x 74.0 x 74.0 mm
