mkramar/dizzyrobot/3D/NEW MODEL/MOTOR 8/PARTS/PART 2 - MOTOR 8 - ROBOT DOG.SLDPRT

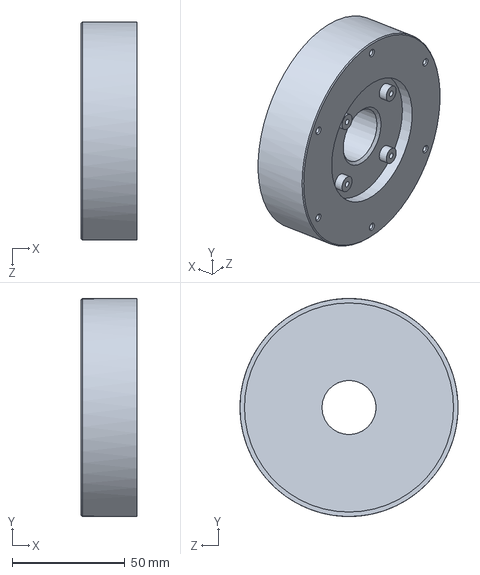
[picture p44: CAD file, 2020-03-14]
3D/NEW MODEL/MOTOR 8/PARTS/PART 2 - MOTOR 8 - ROBOT DOG.SLDPRT
24.6 x 96.7 x 96.7 mm
