mkramar/dizzyrobot/3D/NEW MODEL/MOTOR 8/SUN GEAR M1 Z28 bore 23_GEAR TRAX - MOTOR 8.SLDPRT

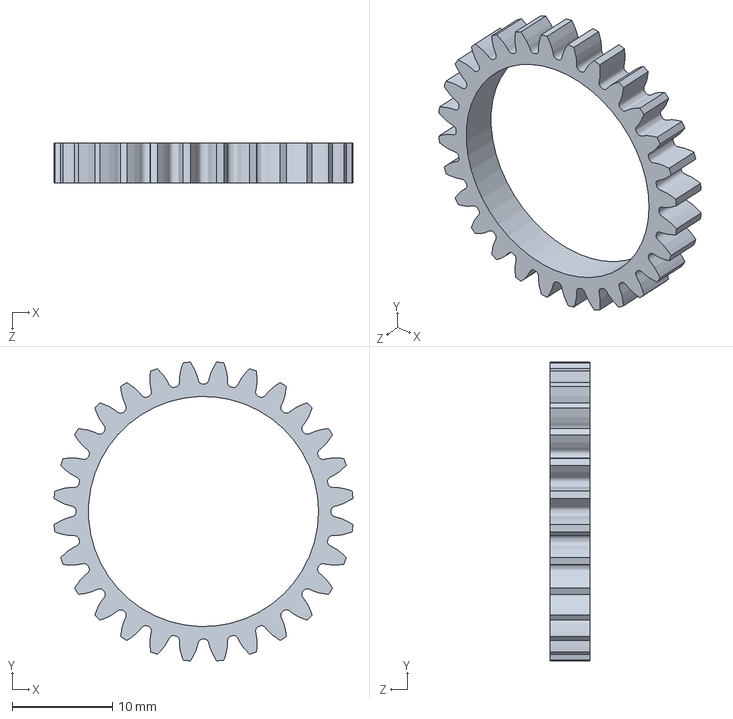
[picture p45: CAD file, 2020-03-14]
3D/NEW MODEL/MOTOR 8/SUN GEAR M1 Z28 bore 23_GEAR TRAX - MOTOR 8.SLDPRT
29.9 x 29.9 x 4.00 mm
