mkramar/dizzyrobot/3D/NEW MODEL/SHOULDER - ROBOT WOLF.SLDPRT

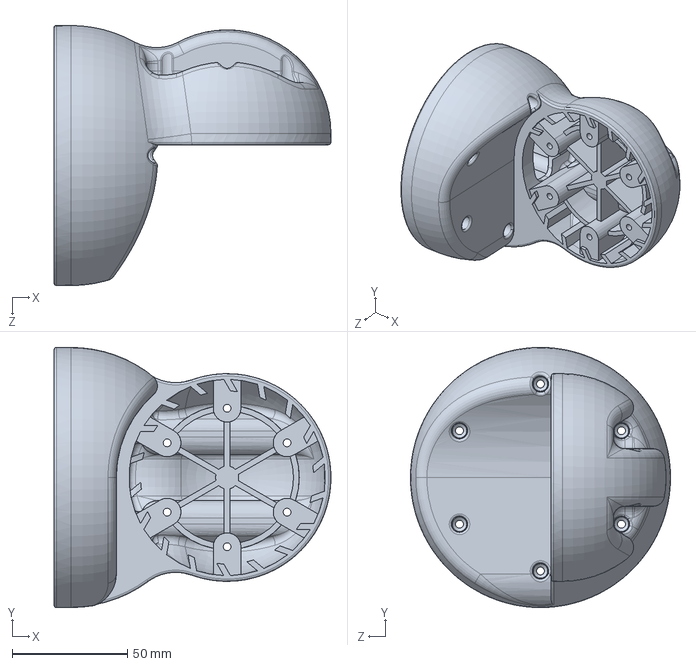
[picture p46: CAD file, 2020-03-14]
3D/NEW MODEL/SHOULDER - ROBOT WOLF.SLDPRT
120.0 x 112.7 x 112.7 mm
