mkramar/dizzyrobot/3D/Wolf/ROBOT DOG 10/PARTS/THIGN - ROBOT DOG.SLDPRT

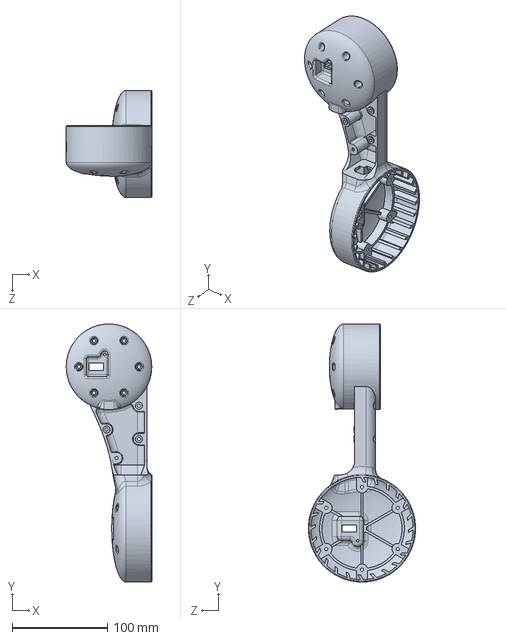
[picture p47: CAD file, 2019-05-31]
3D/Wolf/ROBOT DOG 10/PARTS/THIGN - ROBOT DOG.SLDPRT
90.0 x 271.3 x 112.7 mm
