mkramar/dizzyrobot/3D/Wolf/V2/ITEM/BATTERY - ROBOT DOG.SLDPRT

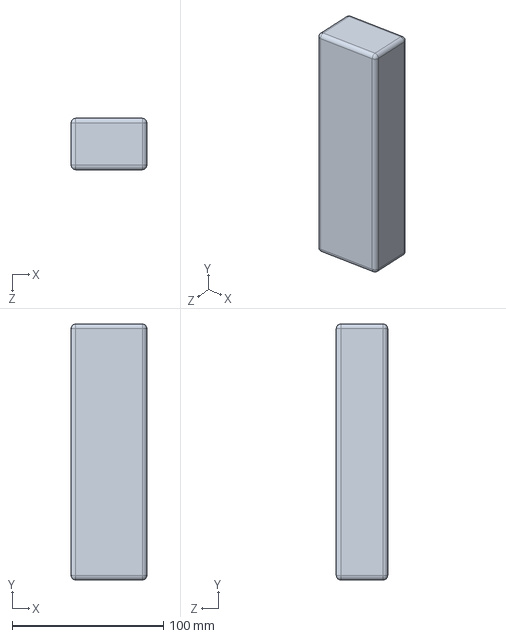
[picture p48: CAD file, 2019-07-20]
3D/Wolf/V2/ITEM/BATTERY - ROBOT DOG.SLDPRT
50.0 x 169.0 x 34.0 mm
