mkramar/dizzyrobot/3D/Wolf/V2/PART/PART 1 - MOTOR 6 - ROBOT DOG.SLDPRT

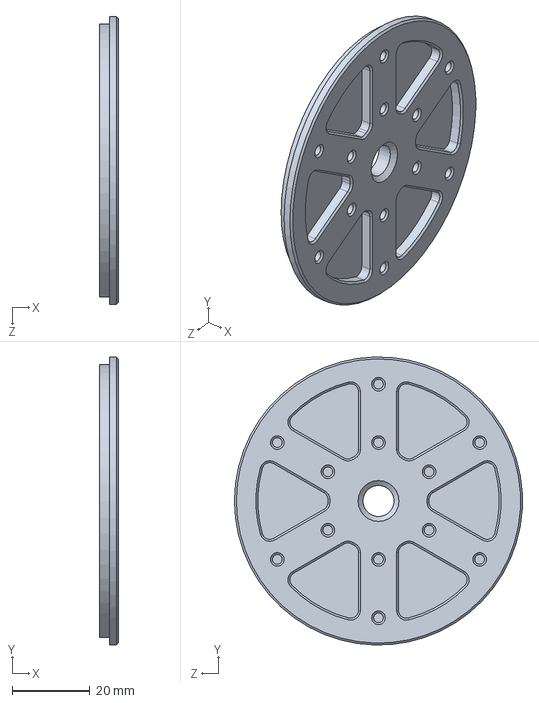
[picture p49: CAD file, 2019-07-13]
3D/Wolf/V2/PART/PART 1 - MOTOR 6 - ROBOT DOG.SLDPRT
4.80 x 74.0 x 74.0 mm
