mkramar/dizzyrobot/3D/Wolf/V2/PARTS/Connector 2.SLDPRT

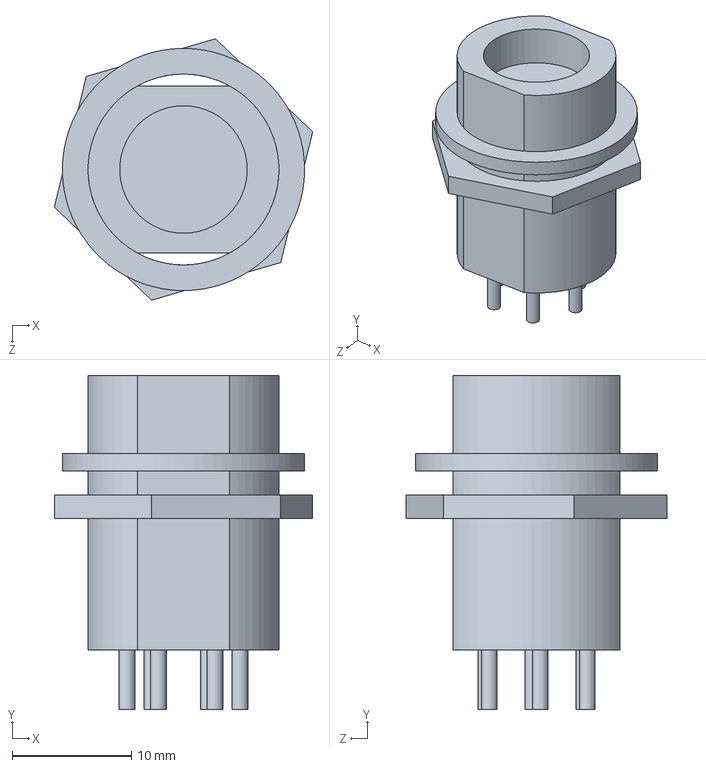
[picture p50: CAD file, 2019-07-20]
3D/Wolf/V2/PARTS/Connector 2.SLDPRT
21.7 x 28.0 x 21.9 mm
