mkramar/dizzyrobot/Mold/Hip/Mold bottom.sldprt

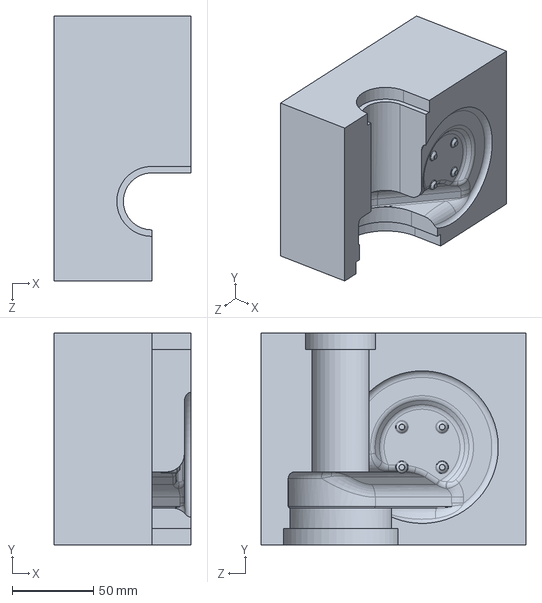
[picture p51: CAD file, 2018-03-08]
Mold/Hip/Mold bottom.sldprt
84.0 x 130.0 x 162.7 mm
