mkramar/dizzyrobot/Mold/motor cores/PLastic mold for silicone motor cores  part1.sldprt

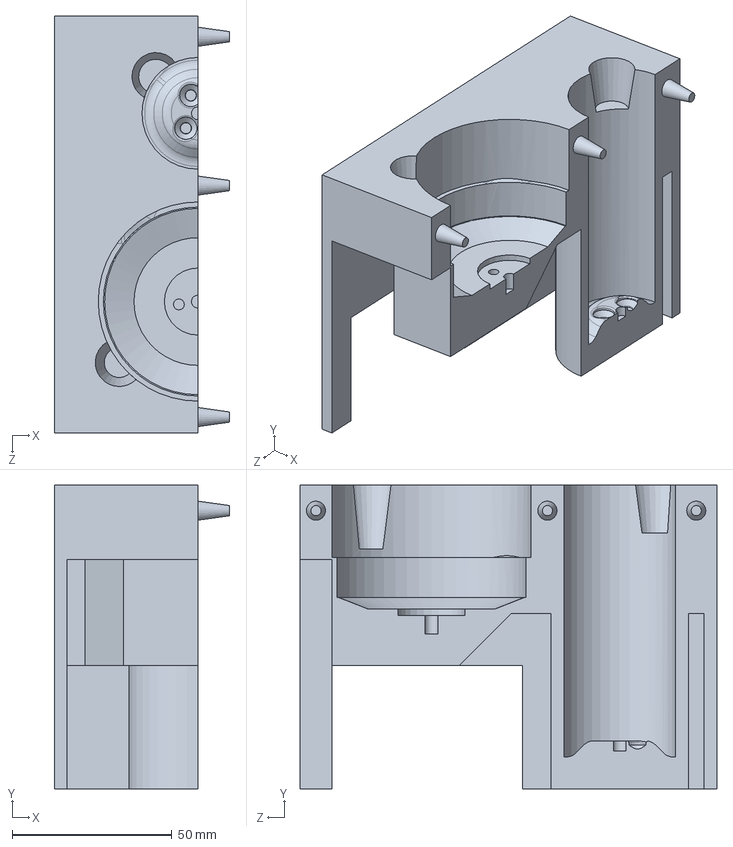
[picture p52: CAD file, 2018-03-08]
Mold/motor cores/PLastic mold for silicone motor cores part1.sldprt
55.0 x 95.2 x 130.7 mm
