mkramar/dizzyrobot/3D/3D - alternative/Gearing/Planet gear M1 Z15 bore 8.SLDPRT

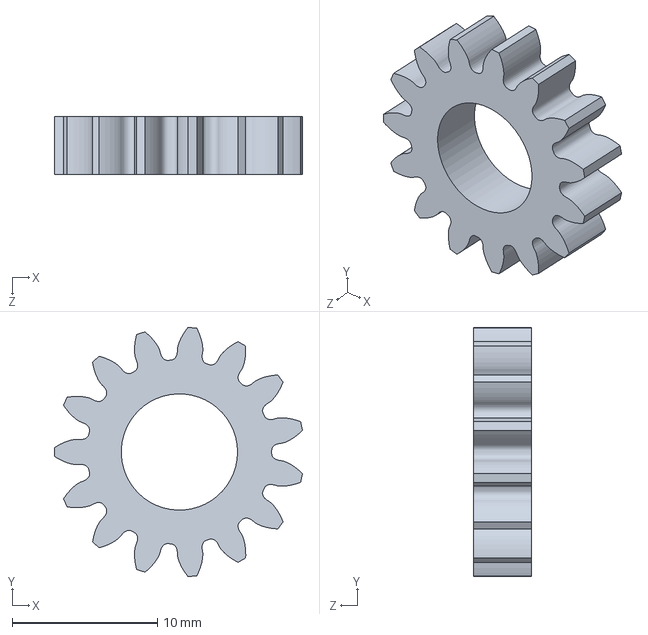
[picture p53: CAD file, 2018-10-10]
3D/3D - alternative/Gearing/Planet gear M1 Z15 bore 8.SLDPRT
17.1 x 17.2 x 4.00 mm
