mkramar/dizzyrobot/3D/3D - alternative/Internal rotor.SLDPRT

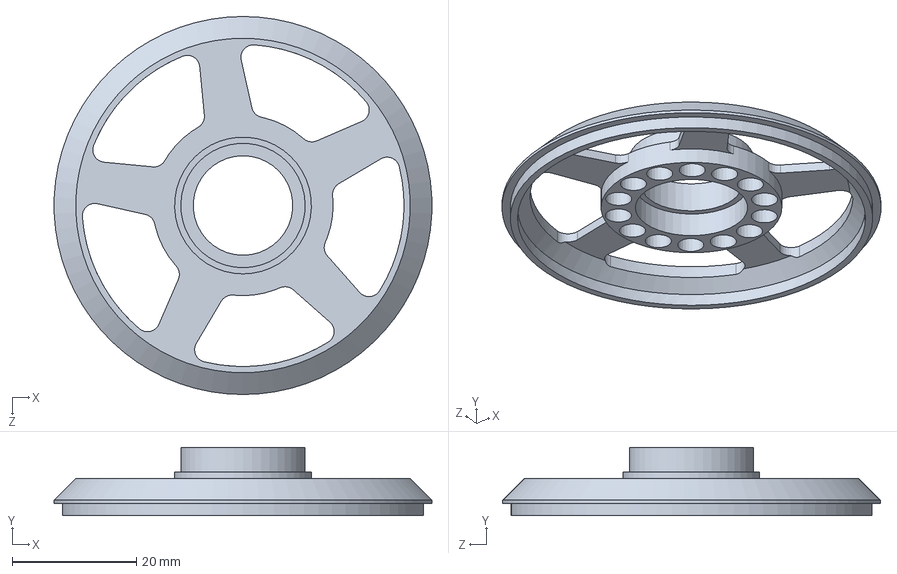
[picture p54: CAD file, 2018-10-16]
3D/3D - alternative/Internal rotor.SLDPRT
60.7 x 11.0 x 60.8 mm
