mkramar/dizzyrobot/3D/3D - Motor 5/External rotor.SLDPRT

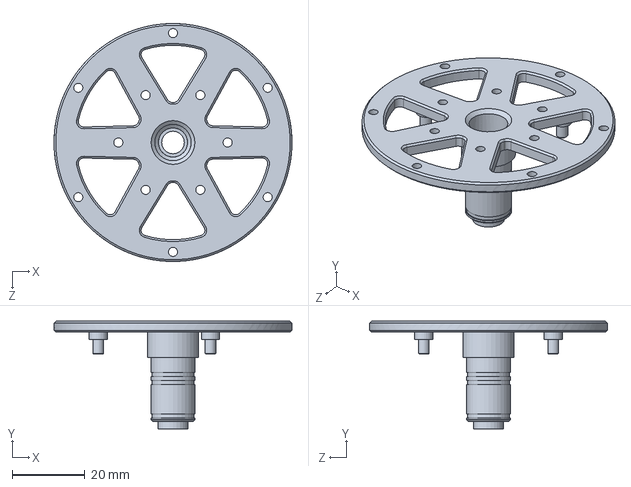
[picture p55: CAD file, 2018-11-04]
3D/3D - Motor 5/External rotor.SLDPRT
65.3 x 29.5 x 65.3 mm
