mkramar/dizzyrobot/3D/3D - Motor 5/Gearing/Sun gear M1 Z25 bore 20 CD20.5.SLDPRT

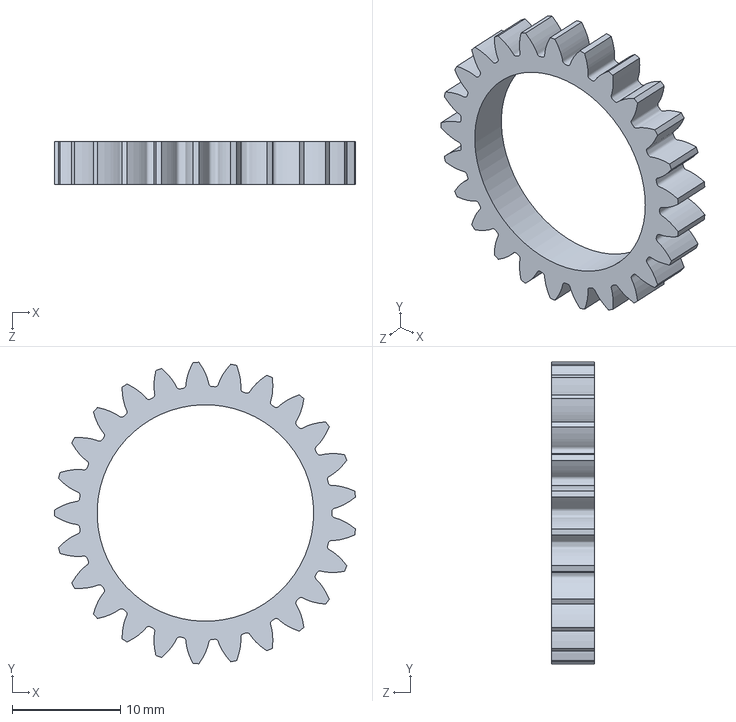
[picture p56: CAD file, 2018-12-15]
3D/3D - Motor 5/Gearing/Sun gear M1 Z25 bore 20 CD20.5.SLDPRT
27.8 x 27.9 x 4.00 mm
