mkramar/dizzyrobot/3D/3D - Motor 6.1/extra/148 8x14x4 mm bearing.SLDPRT

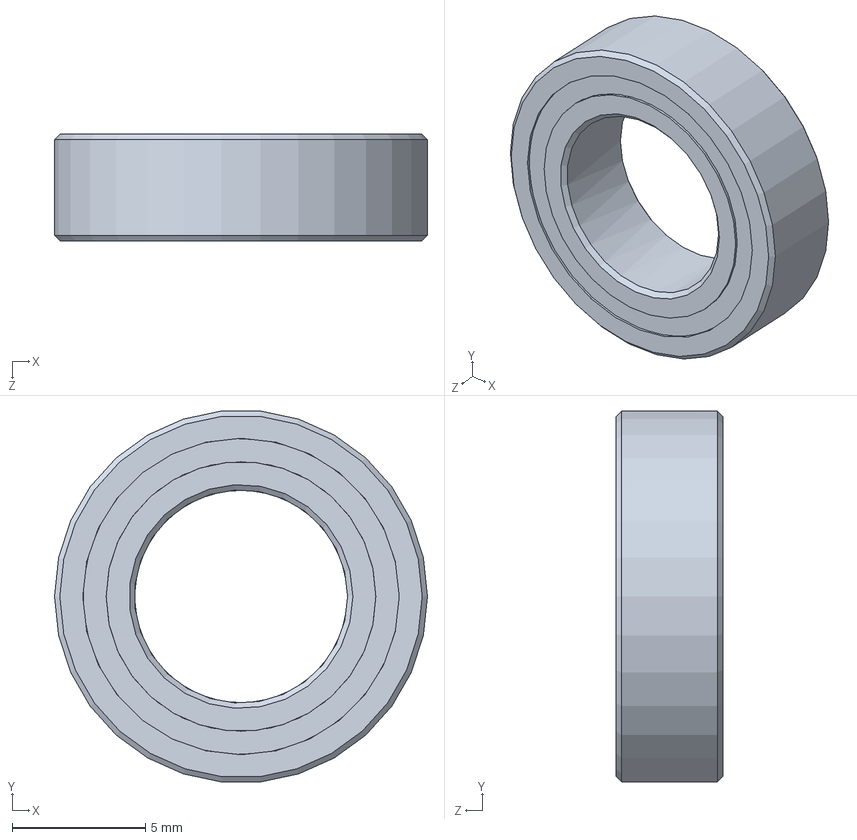
[picture p57: CAD file, 2019-02-16]
3D/3D - Motor 6.1/extra/148 8x14x4 mm bearing.SLDPRT
14.0 x 13.9 x 4.00 mm
