mkramar/dizzyrobot/3D/3D - Motor 6.1/Housing cover.SLDPRT

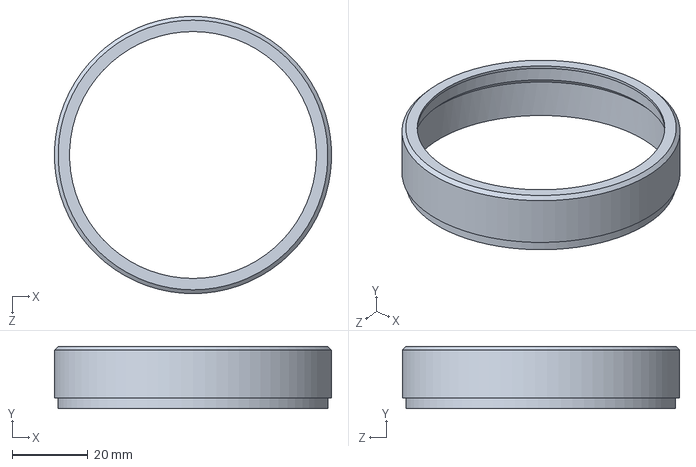
[picture p58: CAD file, 2019-03-31]
3D/3D - Motor 6.1/Housing cover.SLDPRT
72.9 x 16.4 x 73.0 mm
