mkramar/dizzyrobot/3D/3D - Motor 6/12x1 mm spacer ring.SLDPRT

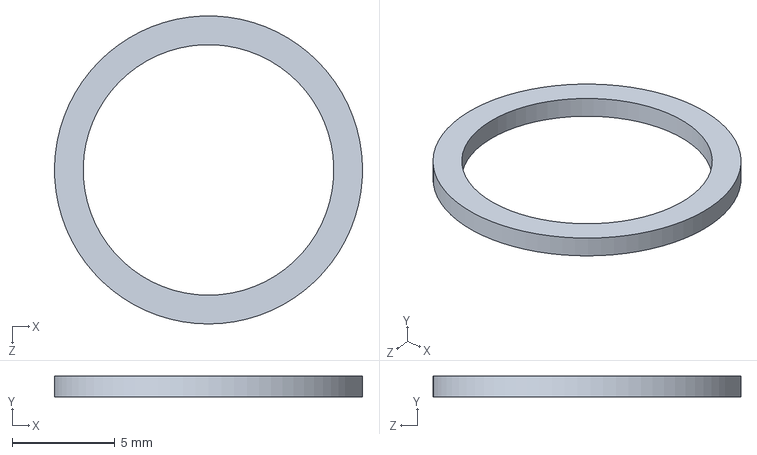
[picture p59: CAD file, 2018-12-25]
3D/3D - Motor 6/12x1 mm spacer ring.SLDPRT
15.0 x 1.00 x 15.0 mm
