mkramar/dizzyrobot/3D/3D - Motor 6/extra/6701 bearing 12x18x4.SLDPRT

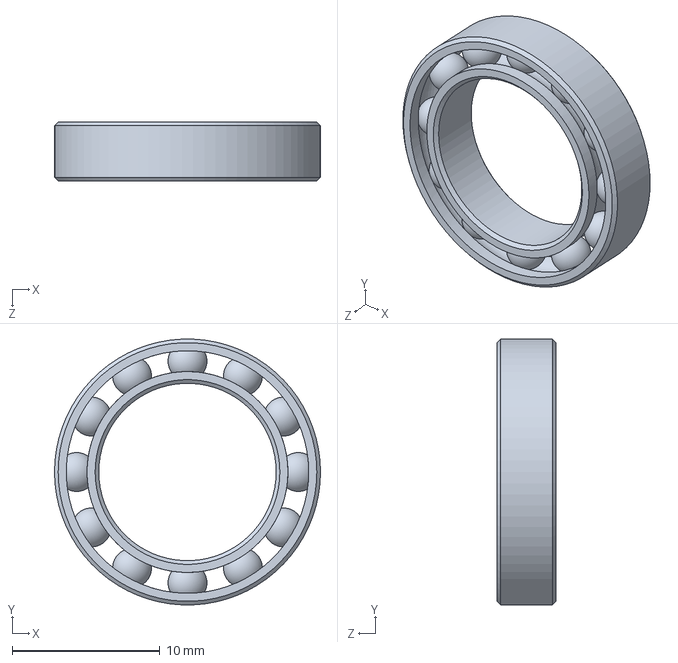
[picture p60: CAD file, 2019-02-16]
3D/3D - Motor 6/extra/6701 bearing 12x18x4.SLDPRT
18.0 x 18.0 x 4.00 mm
