mkramar/dizzyrobot/3D/3D - Motor 8/extra/6803 17x26x5 mm bearing.SLDPRT

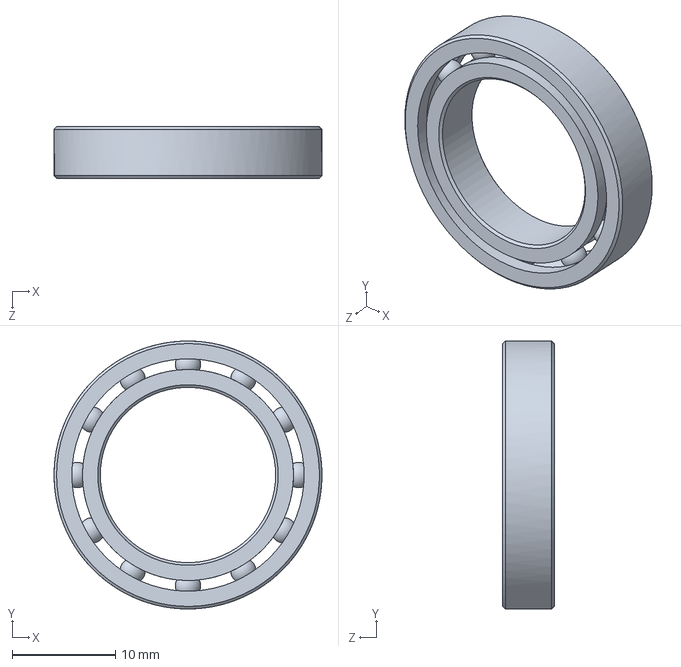
[picture p61: CAD file, 2018-12-09]
3D/3D - Motor 8/extra/6803 17x26x5 mm bearing.SLDPRT
26.0 x 26.0 x 5.00 mm
