mkramar/dizzyrobot/3D/3D - Motor 8/Gearing/Ring gear M1 Z85 OD90.SLDPRT

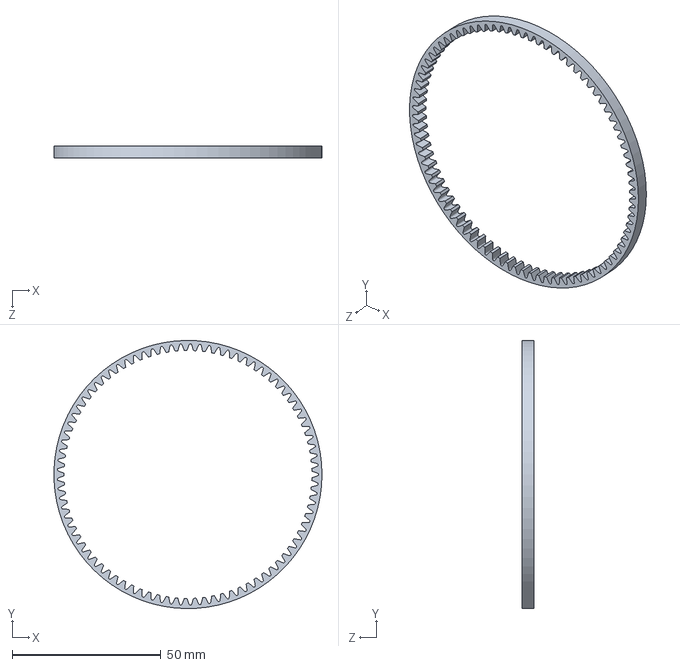
[picture p62: CAD file, 2018-12-15]
3D/3D - Motor 8/Gearing/Ring gear M1 Z85 OD90.SLDPRT
90.0 x 90.0 x 4.00 mm
