mkramar/dizzyrobot/3D/3D - Motor 8/motor 8/Rotor frame.SLDPRT

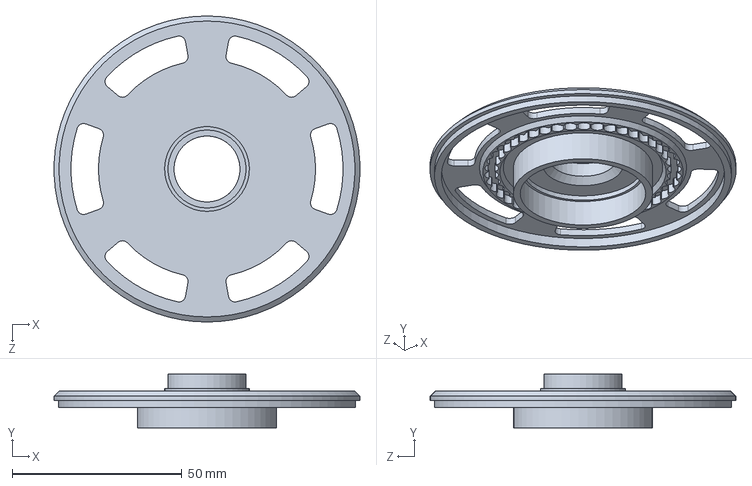
[picture p63: CAD file, 2018-12-22]
3D/3D - Motor 8/motor 8/Rotor frame.SLDPRT
90.1 x 15.9 x 90.2 mm
