mkramar/dizzyrobot/3D/NEW MODEL/MODEL 6/CARRIER - MOTOR 6.SLDPRT

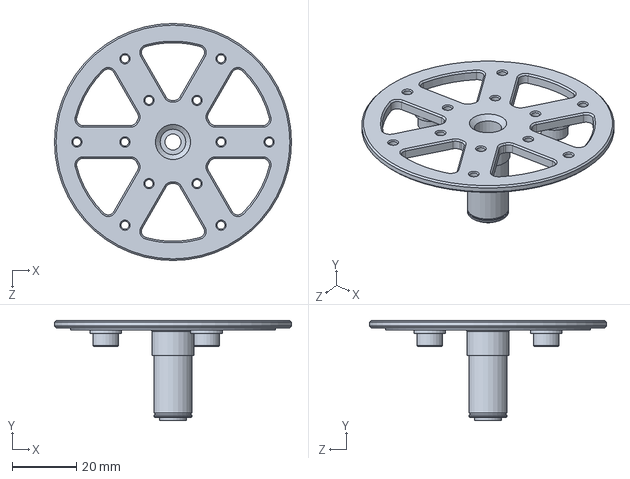
[picture p64: CAD file, 2019-02-25]
3D/NEW MODEL/MODEL 6/CARRIER - MOTOR 6.SLDPRT
74.0 x 31.3 x 74.0 mm
