mkramar/dizzyrobot/3D/NEW MODEL/MOTOR 8/HOUSING COVER - MOTOR 8.SLDPRT

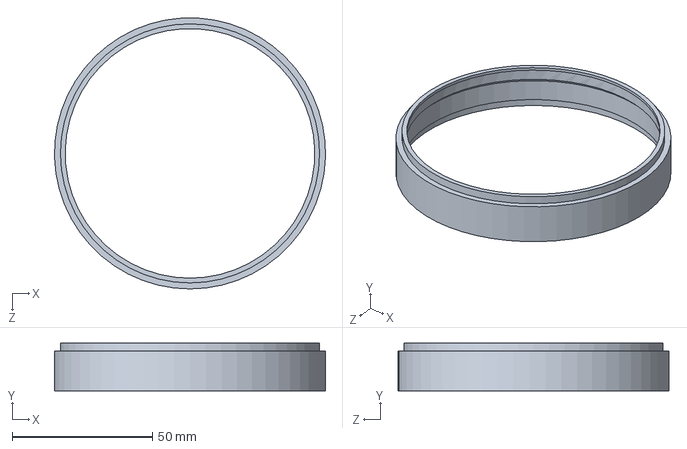
[picture p65: CAD file, 2020-03-14]
3D/NEW MODEL/MOTOR 8/HOUSING COVER - MOTOR 8.SLDPRT
96.7 x 17.0 x 96.6 mm
