mkramar/dizzyrobot/3D/NEW MODEL/MOTOR 8/PARTS/PART 1 - MOTOR 8 - ROBOT DOG.SLDPRT

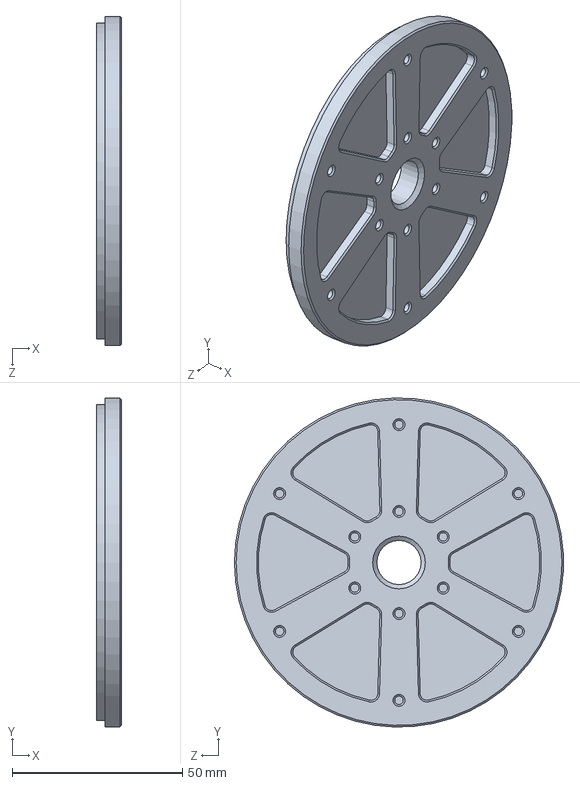
[picture p66: CAD file, 2020-03-14]
3D/NEW MODEL/MOTOR 8/PARTS/PART 1 - MOTOR 8 - ROBOT DOG.SLDPRT
7.45 x 96.7 x 96.7 mm
