mkramar/dizzyrobot/Mold/Hip/Box.sldprt

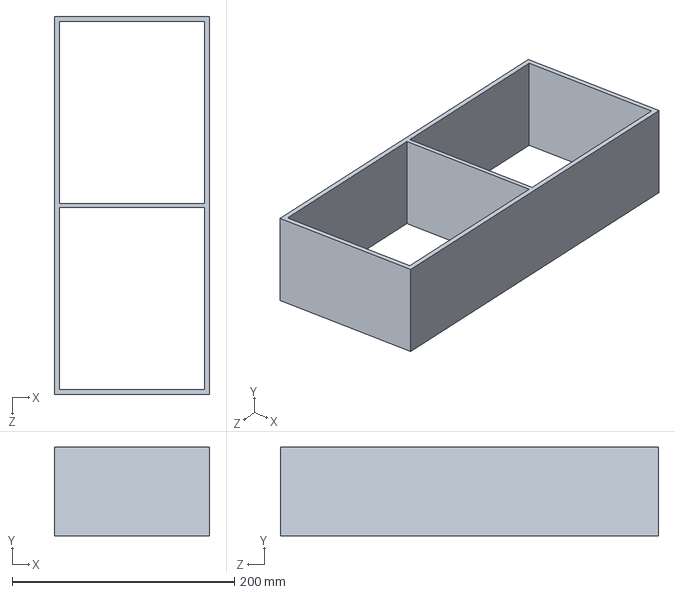
[picture p67: CAD file, 2018-03-08]
Mold/Hip/Box.sldprt
140.0 x 80.0 x 340.4 mm
