mkramar/dizzyrobot/Mold/motor cores/Motor cores silicone mold assemvly.SLDPRT

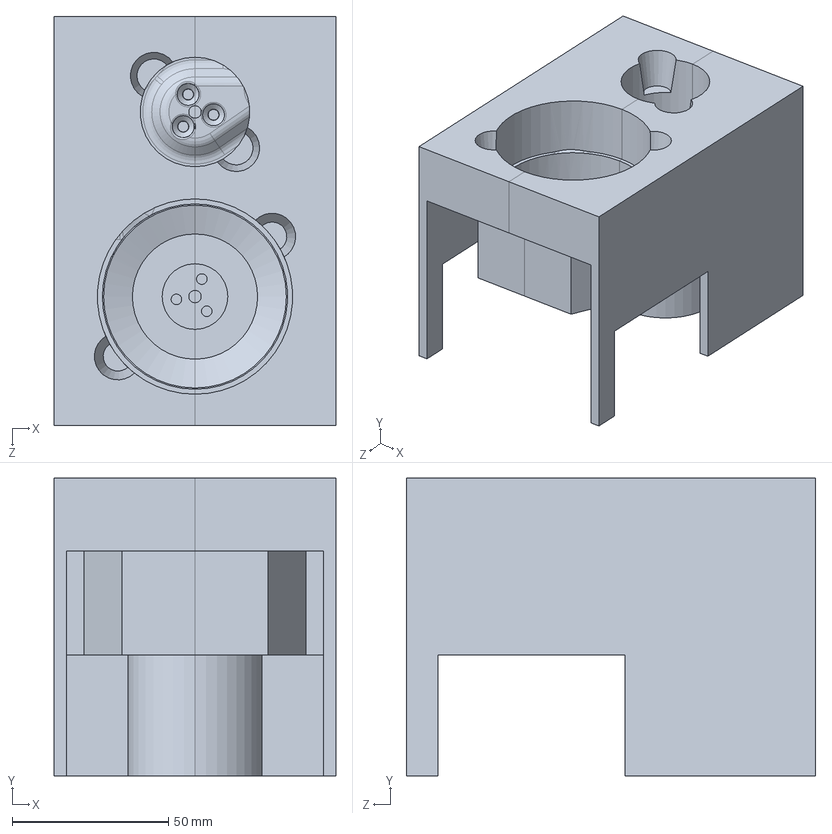
[picture p68: CAD file, 2018-03-08]
Mold/motor cores/Motor cores silicone mold assemvly.SLDPRT
90.0 x 95.2 x 130.7 mm
