mkramar/dizzyrobot/3D/3D - alternative/External rotor.SLDPRT

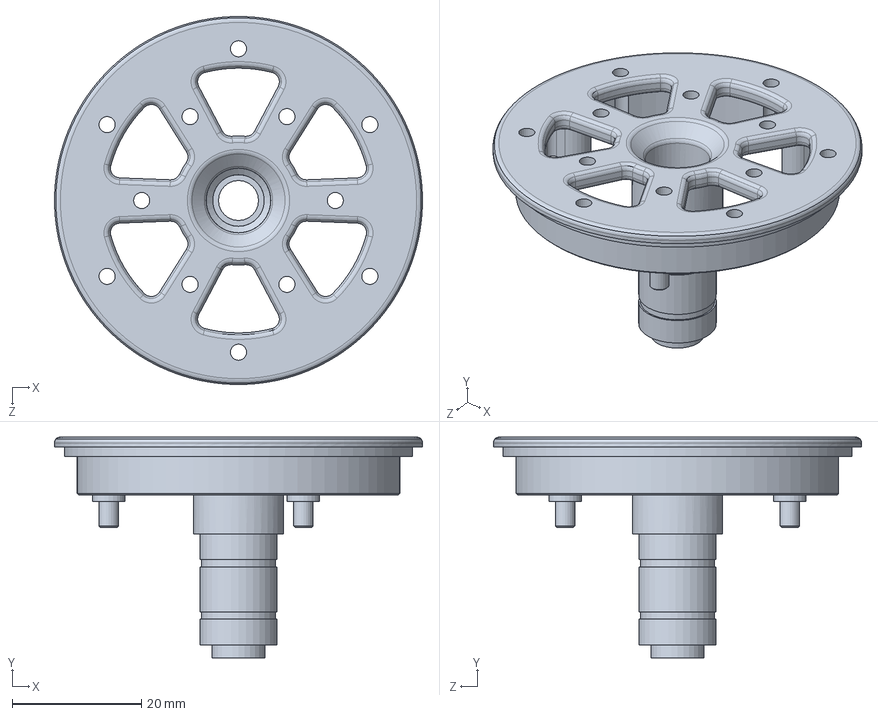
[picture p69: CAD file, 2018-10-16]
3D/3D - alternative/External rotor.SLDPRT
57.0 x 34.2 x 57.0 mm
