mkramar/dizzyrobot/3D/3D - alternative/Gearing/Sun gear M1 Z25 bore 20.SLDPRT

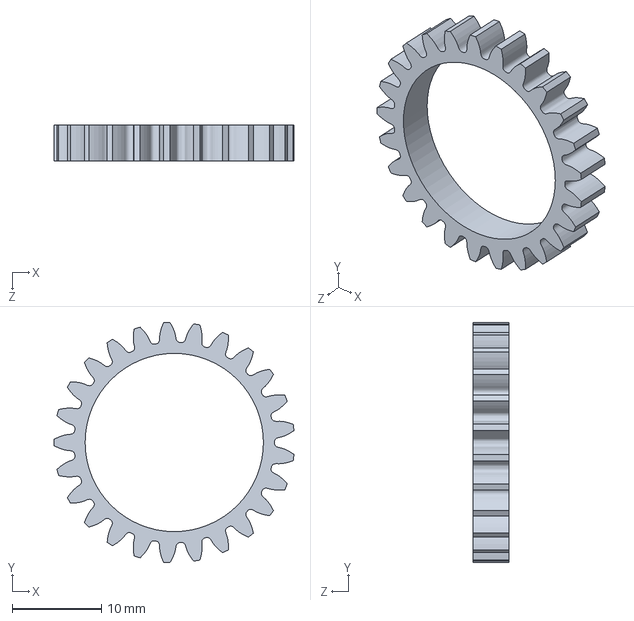
[picture p70: CAD file, 2018-10-10]
3D/3D - alternative/Gearing/Sun gear M1 Z25 bore 20.SLDPRT
26.9 x 27.0 x 4.00 mm
