mkramar/dizzyrobot/3D/3D - Motor 5/Housing base.SLDPRT

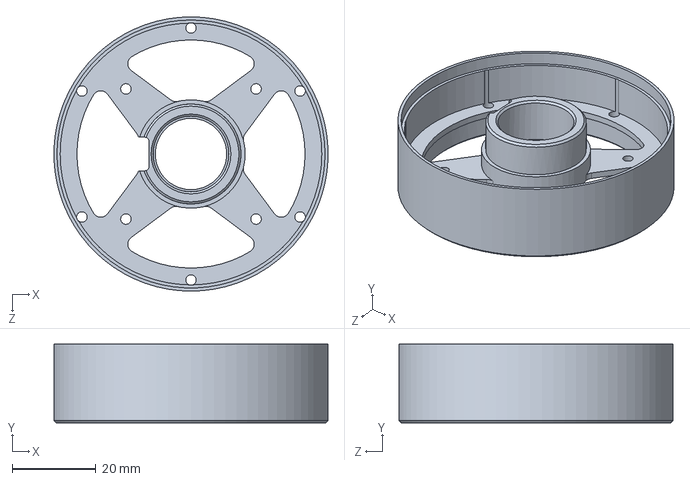
[picture p71: CAD file, 2018-11-04]
3D/3D - Motor 5/Housing base.SLDPRT
65.2 x 18.7 x 65.3 mm
