mkramar/dizzyrobot/3D/3D - Motor 6.1/extra/CLM-12 external retaining ring for sID 12 mm.SLDPRT

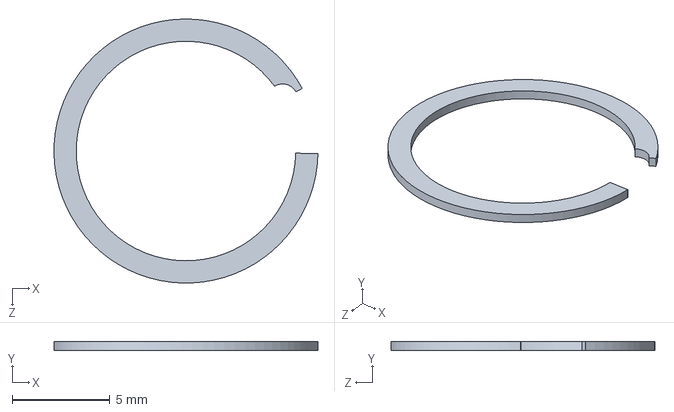
[picture p72: CAD file, 2018-12-25]
3D/3D - Motor 6.1/extra/CLM-12 external retaining ring for sID 12 mm.SLDPRT
13.5 x 0.46 x 13.5 mm
