mkramar/dizzyrobot/3D/3D - Motor 6.1/Gearing/Sun gear Z23 H17 M1.SLDPRT

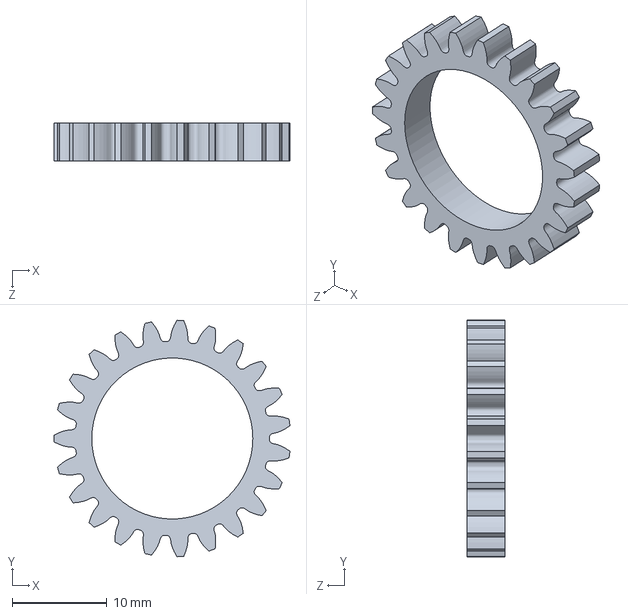
[picture p73: CAD file, 2019-02-16]
3D/3D - Motor 6.1/Gearing/Sun gear Z23 H17 M1.SLDPRT
24.9 x 25.0 x 4.00 mm
