mkramar/dizzyrobot/3D/3D - Motor 6.1/Rotor.SLDPRT

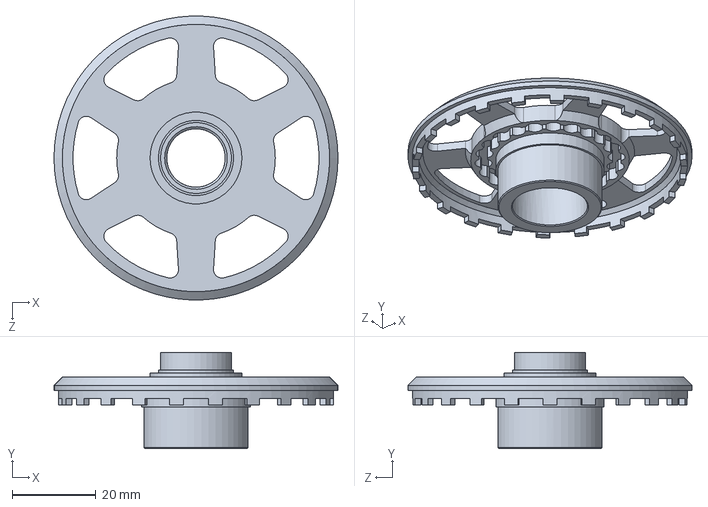
[picture p74: CAD file, 2019-03-31]
3D/3D - Motor 6.1/Rotor.SLDPRT
68.0 x 23.1 x 67.9 mm
