mkramar/dizzyrobot/3D/3D - Motor 6/Housing base.SLDPRT

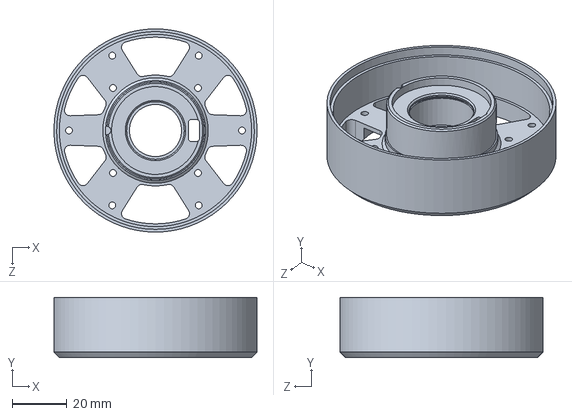
[picture p75: CAD file, 2018-12-22]
3D/3D - Motor 6/Housing base.SLDPRT
73.9 x 21.9 x 74.0 mm
