mkramar/dizzyrobot/3D/3D - Motor 8/Gearing/Planet Gear M1 Z28 bore 14.SLDPRT

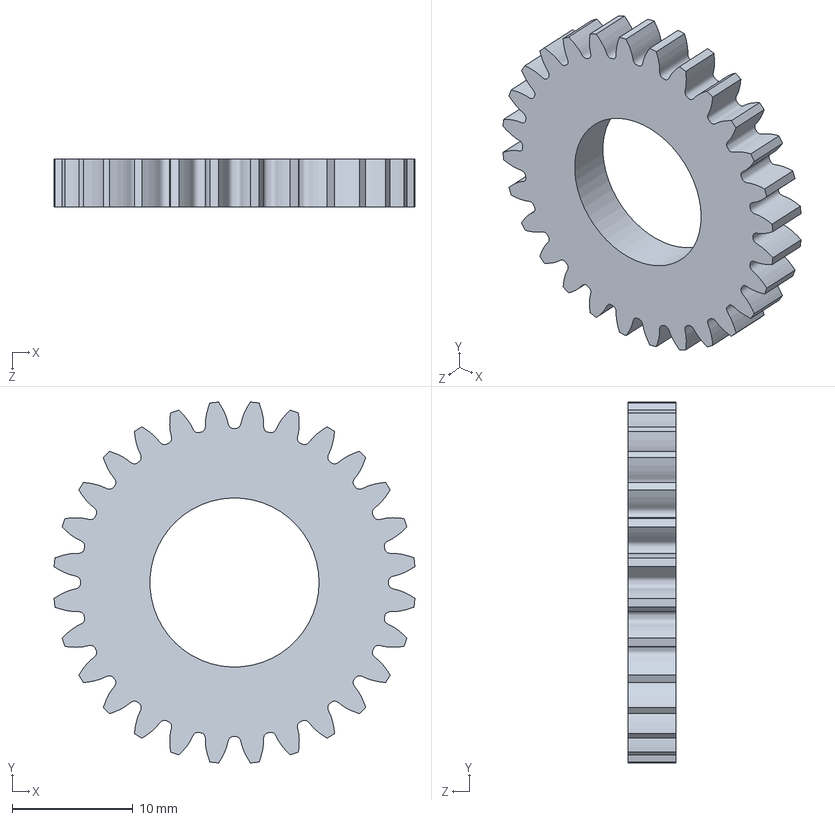
[picture p76: CAD file, 2018-12-09]
3D/3D - Motor 8/Gearing/Planet Gear M1 Z28 bore 14.SLDPRT
29.9 x 29.9 x 4.00 mm
