mkramar/dizzyrobot/3D/3D - Motor 8/motor 8/Slipring.SLDPRT

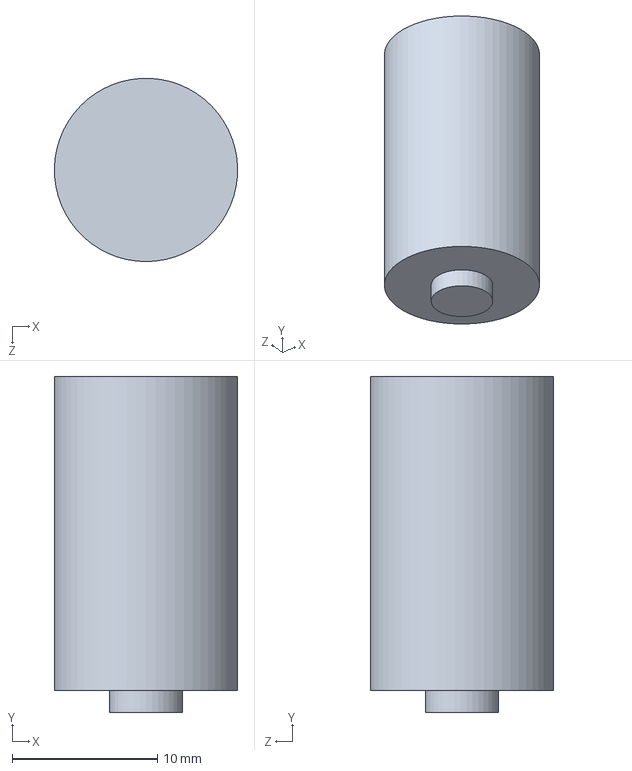
[picture p77: CAD file, 2018-12-09]
3D/3D - Motor 8/motor 8/Slipring.SLDPRT
12.6 x 23.1 x 12.6 mm
