mkramar/dizzyrobot/3D/NEW MODEL/LEG - ROBOT WOLF.SLDPRT

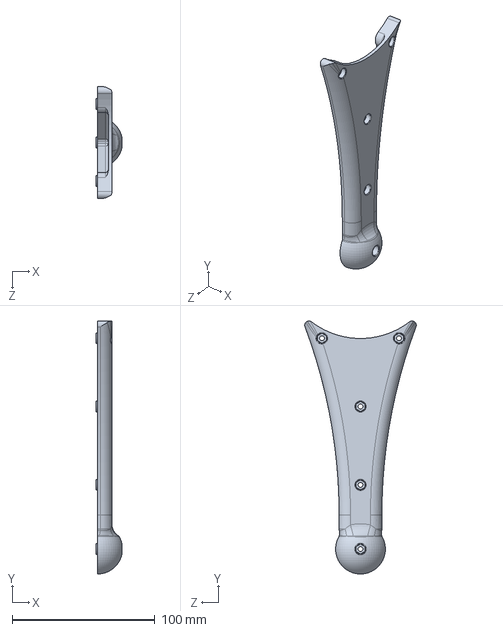
[picture p78: CAD file, 2020-03-14]
3D/NEW MODEL/LEG - ROBOT WOLF.SLDPRT
18.0 x 177.4 x 78.3 mm
