mkramar/dizzyrobot/3D/NEW MODEL/MODEL 6/KLM-21 INTERNAL RETAINING RING FOR hID 21 mm.SLDPRT

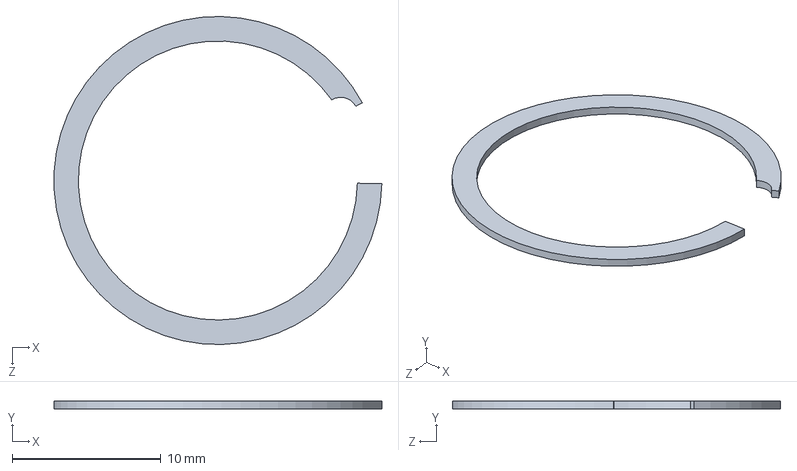
[picture p79: CAD file, 2019-02-25]
3D/NEW MODEL/MODEL 6/KLM-21 INTERNAL RETAINING RING FOR hID 21 mm.SLDPRT
22.0 x 0.53 x 22.1 mm
