mkramar/dizzyrobot/3D/Wolf/V2/PARTS/MirrorCOVER OF THE THIGN - ROBOT DOG.SLDPRT

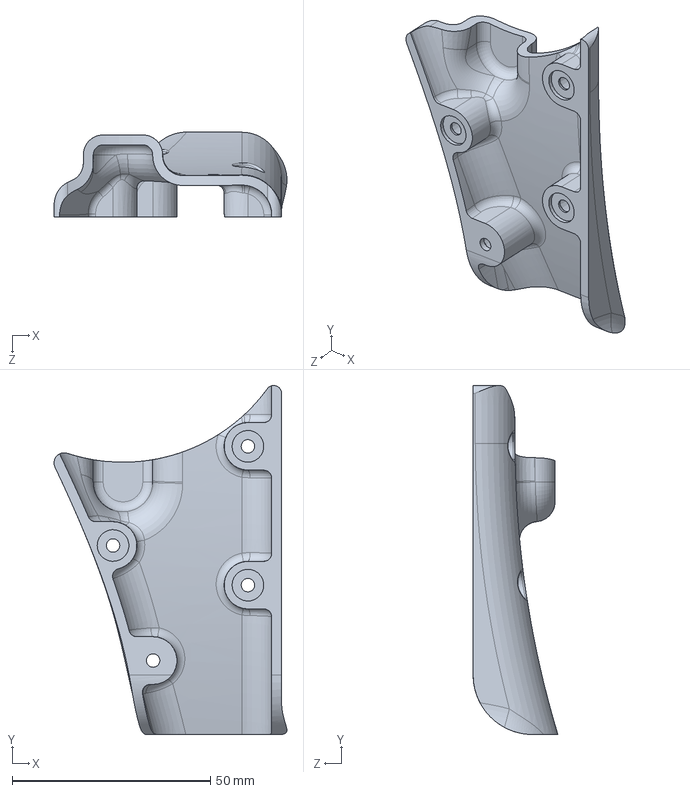
[picture p80: CAD file, 2019-07-20]
3D/Wolf/V2/PARTS/MirrorCOVER OF THE THIGN - ROBOT DOG.SLDPRT
58.7 x 88.0 x 21.4 mm
