mkramar/dizzyrobot/Mold/Hip/M6 motor core.sldprt

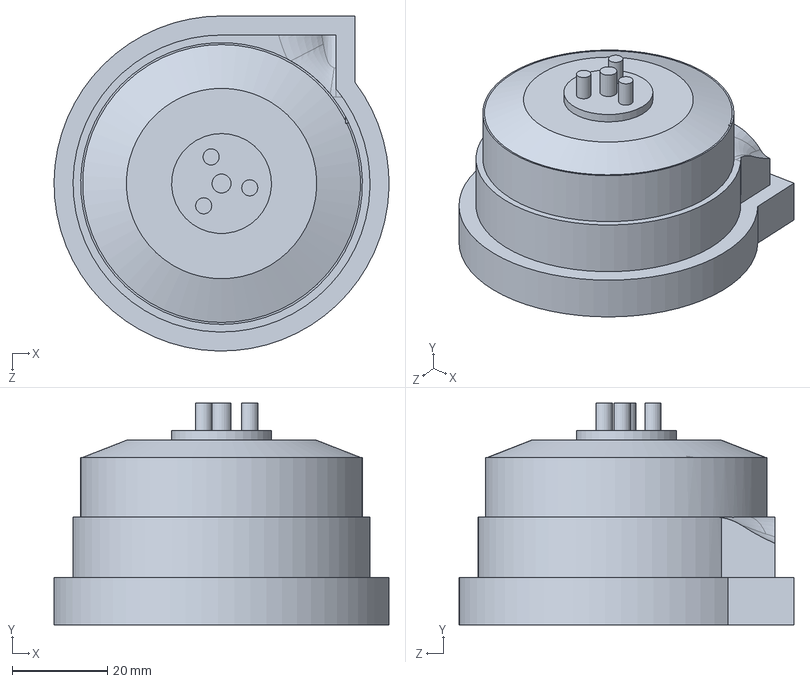
[picture p81: CAD file, 2018-03-08]
Mold/Hip/M6 motor core.sldprt
70.4 x 46.6 x 70.4 mm
