mkramar/dizzyrobot/Mold/motor cores/PLastic mold for silicone motor cores  part2.sldprt

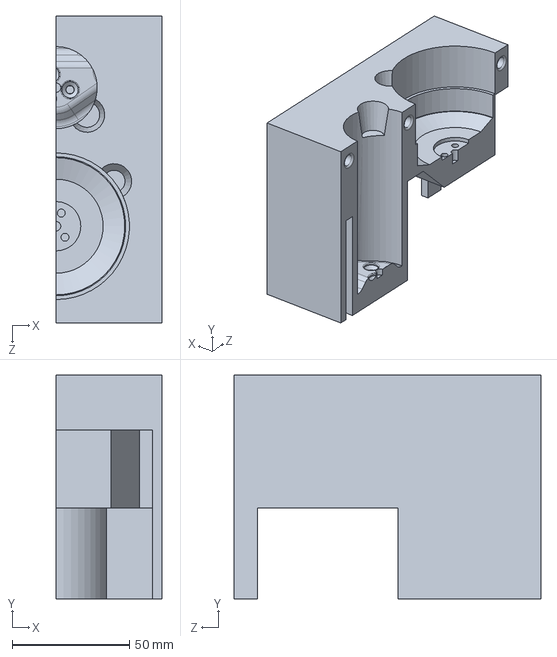
[picture p82: CAD file, 2018-03-08]
Mold/motor cores/PLastic mold for silicone motor cores part2.sldprt
45.0 x 95.2 x 130.7 mm
