mkramar/dizzyrobot/3D/3D - alternative/Housing top.SLDPRT

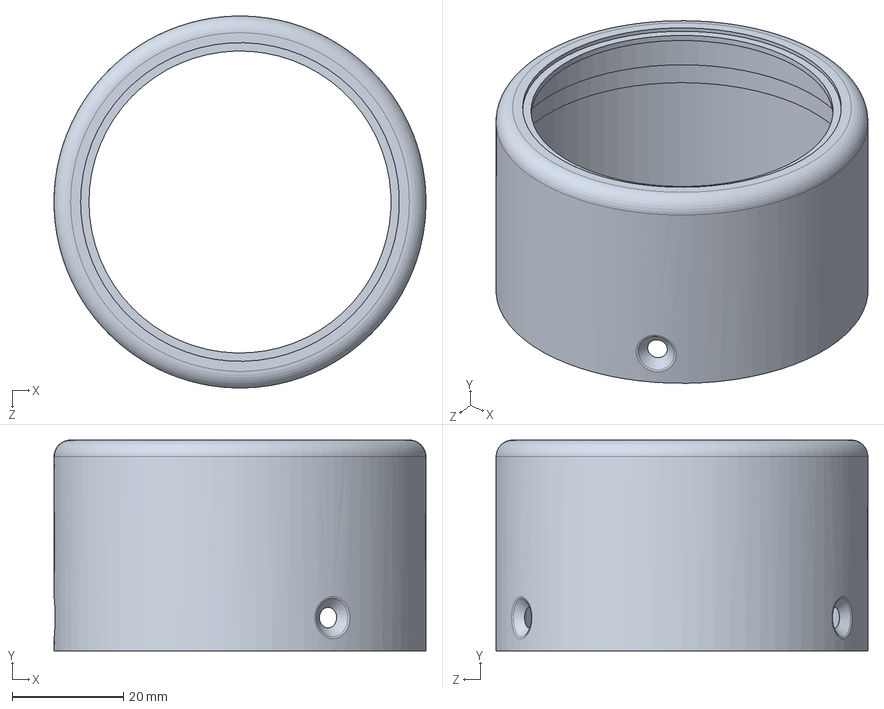
[picture p83: CAD file, 2018-10-16]
3D/3D - alternative/Housing top.SLDPRT
67.0 x 38.0 x 67.0 mm
