mkramar/dizzyrobot/3D/3D - Motor 5/Gearing/Ring gear M1 Z55.SLDPRT

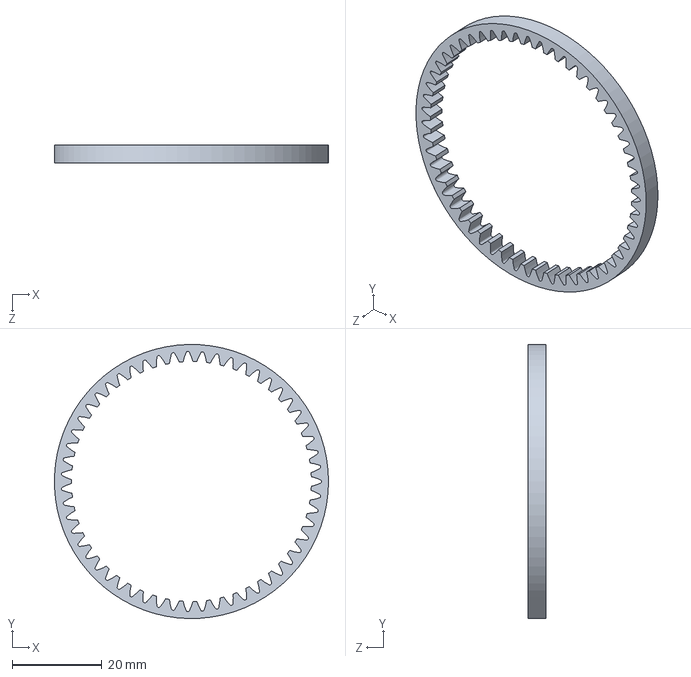
[picture p84: CAD file, 2018-10-13]
3D/3D - Motor 5/Gearing/Ring gear M1 Z55.SLDPRT
61.0 x 61.0 x 4.00 mm
