mkramar/dizzyrobot/3D/3D - Motor 6.1/Housing base.SLDPRT

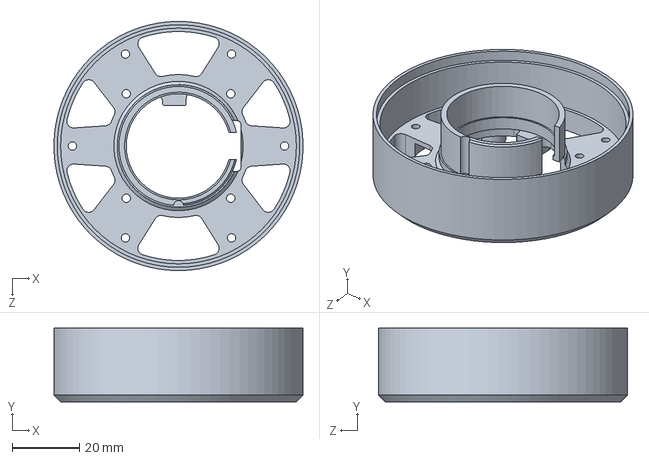
[picture p85: CAD file, 2019-03-31]
3D/3D - Motor 6.1/Housing base.SLDPRT
73.9 x 21.9 x 74.0 mm
