mkramar/dizzyrobot/3D/3D - Motor 6/Rotor.SLDPRT

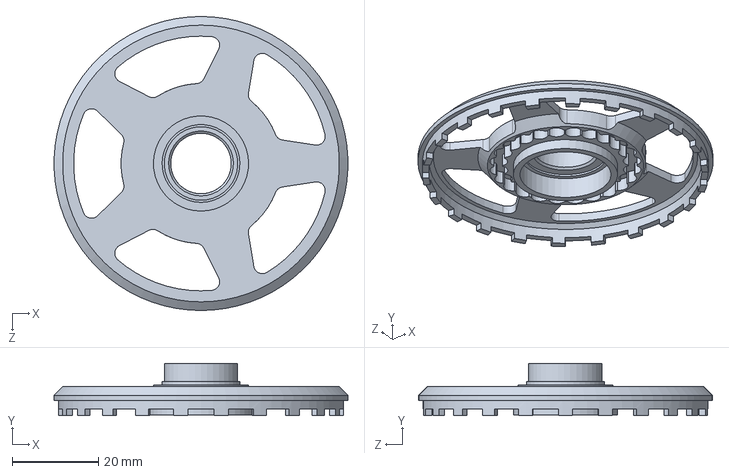
[picture p86: CAD file, 2018-12-22]
3D/3D - Motor 6/Rotor.SLDPRT
67.9 x 12.1 x 68.0 mm
