mkramar/dizzyrobot/3D/3D - Motor 8/Gearing/Ring gear M1 Z84.SLDPRT

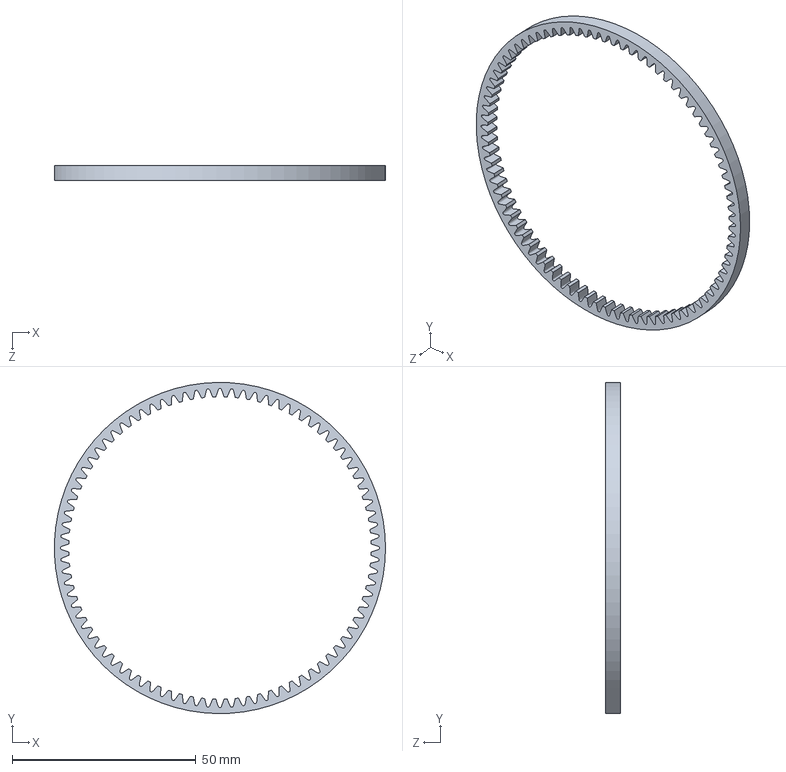
[picture p87: CAD file, 2018-10-10]
3D/3D - Motor 8/Gearing/Ring gear M1 Z84.SLDPRT
90.0 x 90.0 x 4.00 mm
