mkramar/dizzyrobot/3D/3D - Motor 8/motor 8/Housing cover.SLDPRT

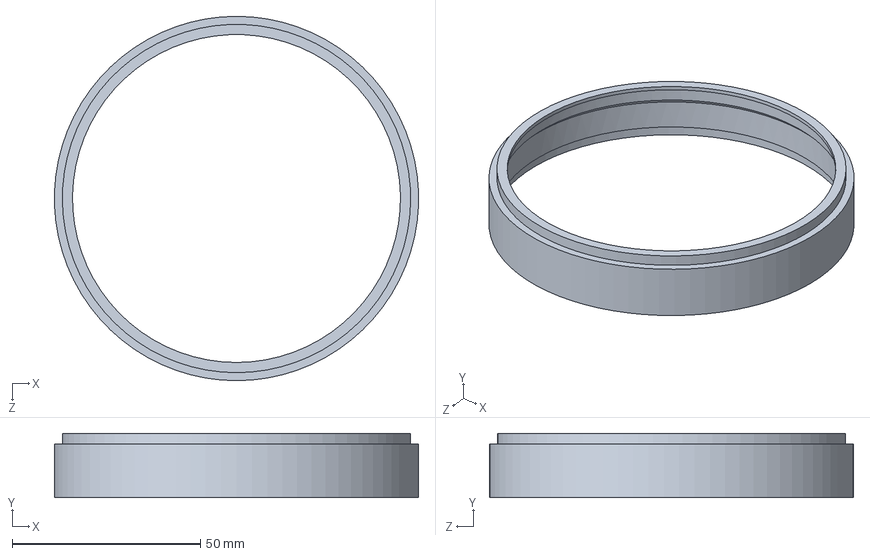
[picture p88: CAD file, 2018-12-09]
3D/3D - Motor 8/motor 8/Housing cover.SLDPRT
96.6 x 17.0 x 96.7 mm
