mkramar/dizzyrobot/3D/Wolf/V2/PARTS/MirrorSHOULDER.SLDPRT

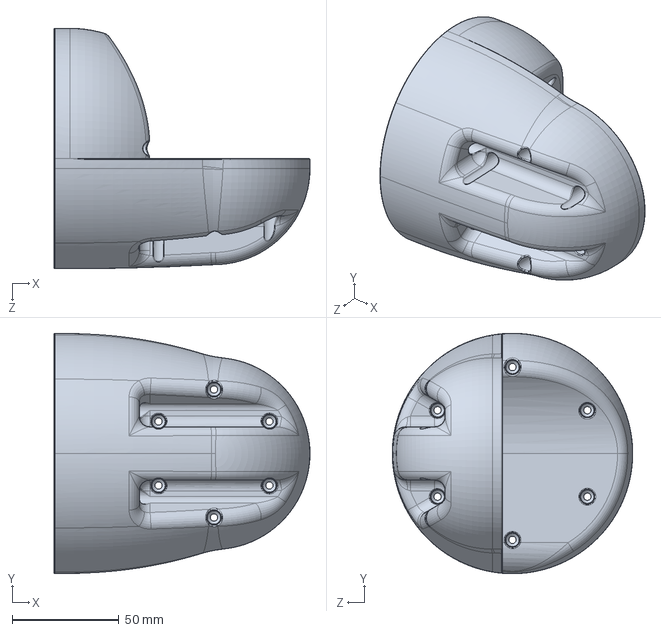
[picture p89: CAD file, 2019-07-20]
3D/Wolf/V2/PARTS/MirrorSHOULDER.SLDPRT
120.0 x 112.7 x 112.7 mm
