mkramar/dizzyrobot/Mold/Hip/PLastic mold for silicone motor cores  part1.sldprt

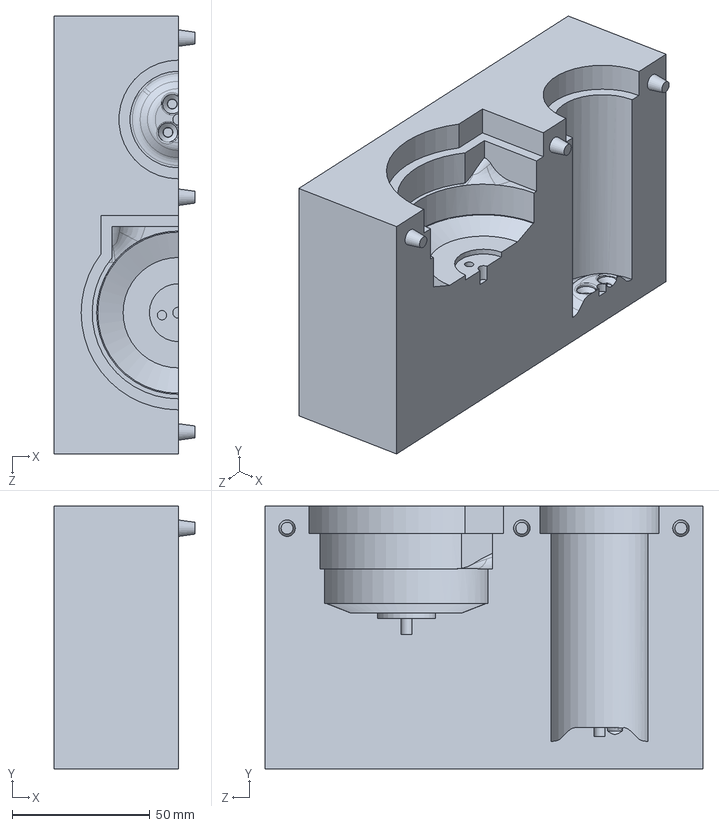
[picture p90: CAD file, 2018-03-08]
Mold/Hip/PLastic mold for silicone motor cores part1.sldprt
51.0 x 95.2 x 158.7 mm
