mkramar/dizzyrobot/3D/3D - alternative/Rotor magnet ring.SLDPRT

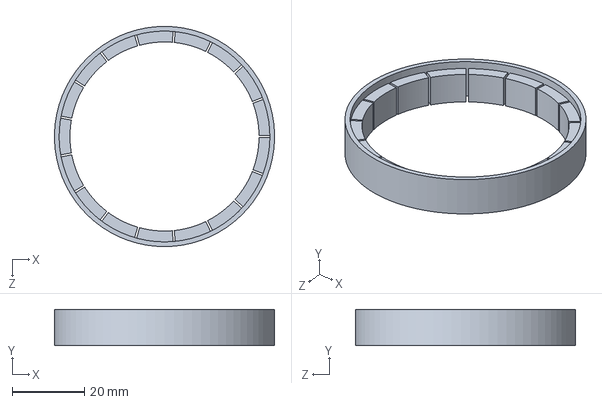
[picture p91: CAD file, 2018-10-16]
3D/3D - alternative/Rotor magnet ring.SLDPRT
60.7 x 10.0 x 60.8 mm
