mkramar/dizzyrobot/3D/3D - Motor 6.1/Stator.SLDPRT

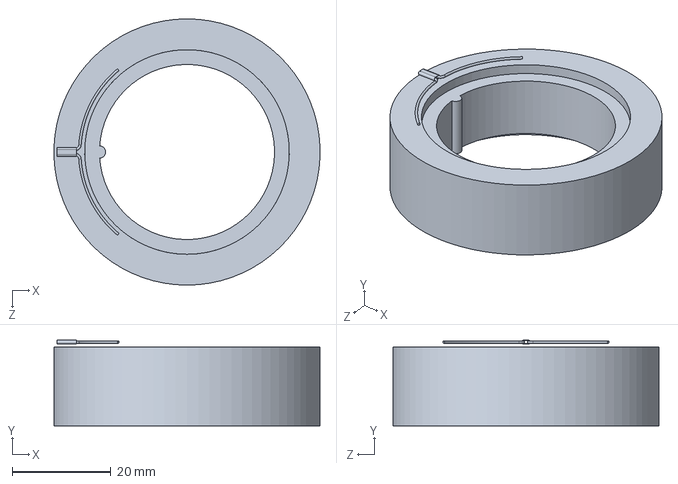
[picture p92: CAD file, 2019-02-25]
3D/3D - Motor 6.1/Stator.SLDPRT
54.0 x 17.4 x 54.0 mm
