mkramar/dizzyrobot/3D/3D - Motor 6/extra/6801 bearing 12x21x5.SLDPRT

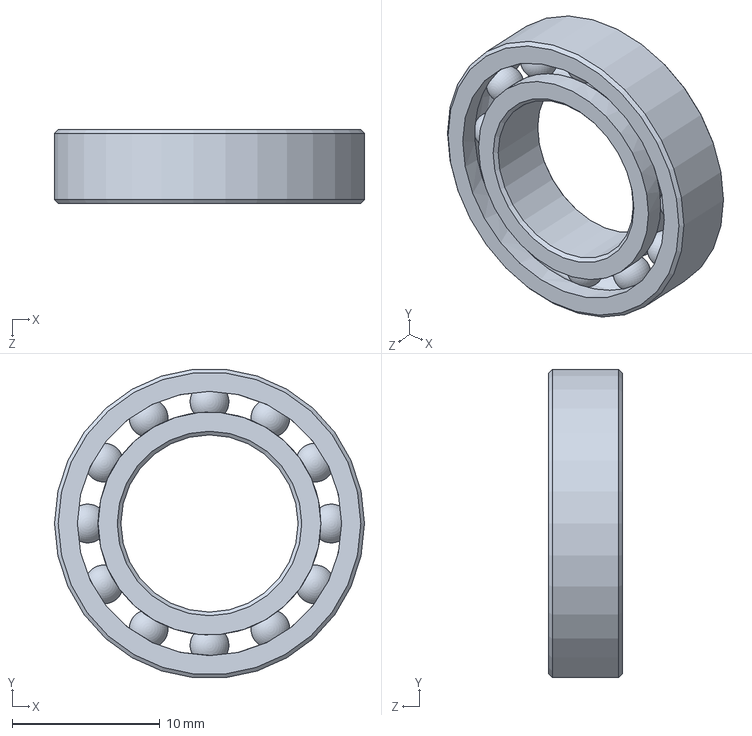
[picture p93: CAD file, 2018-12-15]
3D/3D - Motor 6/extra/6801 bearing 12x21x5.SLDPRT
21.0 x 20.9 x 5.00 mm
