mkramar/dizzyrobot/3D/3D - Motor 8/motor 8/Positioning magnet.SLDPRT

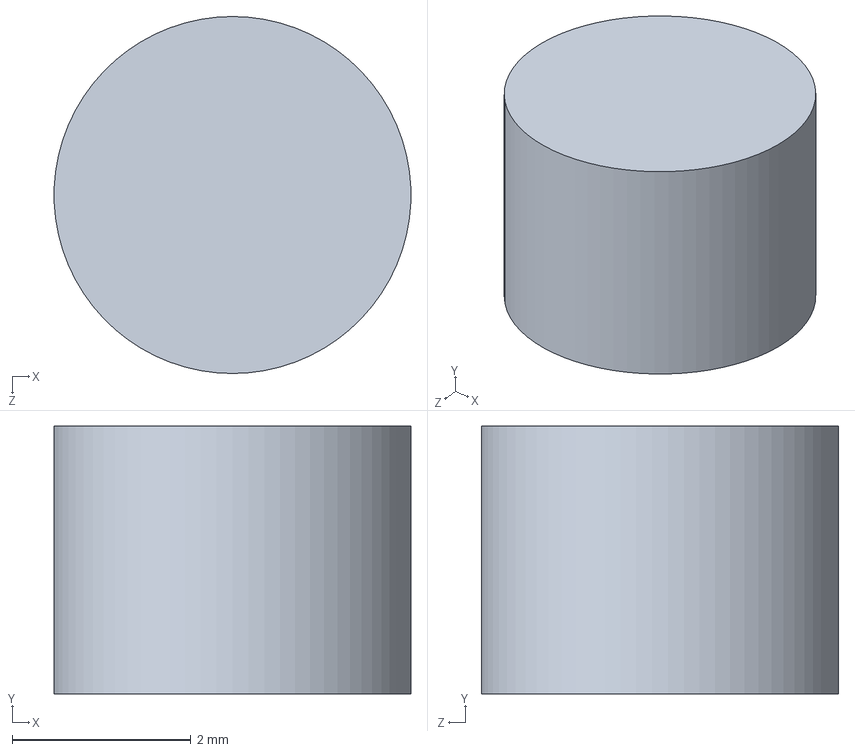
[picture p94: CAD file, 2018-12-09]
3D/3D - Motor 8/motor 8/Positioning magnet.SLDPRT
4.00 x 3.00 x 4.00 mm
