mkramar/dizzyrobot/3D/NEW MODEL/ITEM/CONNECTOR 1.SLDPRT

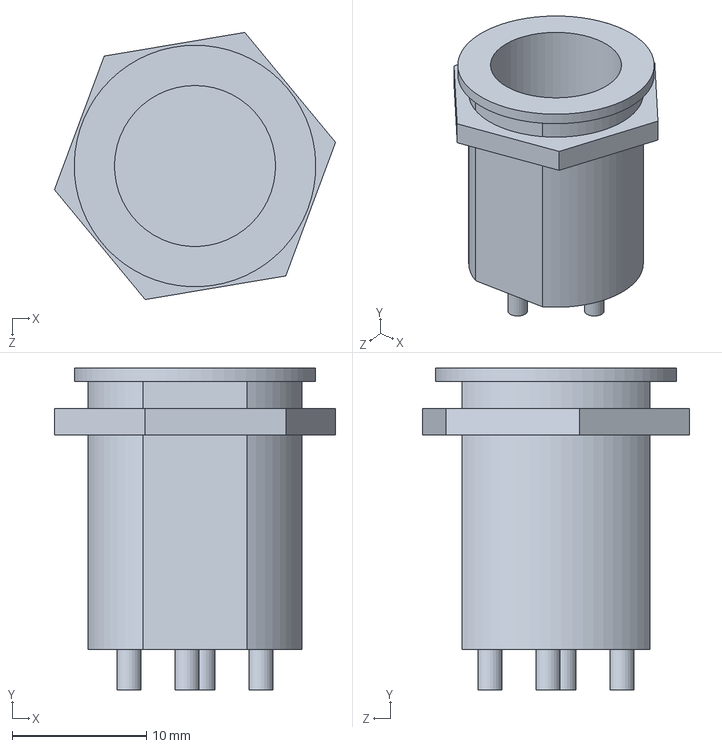
[picture p95: CAD file, 2020-03-14]
3D/NEW MODEL/ITEM/CONNECTOR 1.SLDPRT
21.0 x 24.0 x 19.9 mm
