mkramar/dizzyrobot/3D/Wolf/V2/PARTS/COVER OF THE BATTERY - ROBOT DOG.SLDPRT

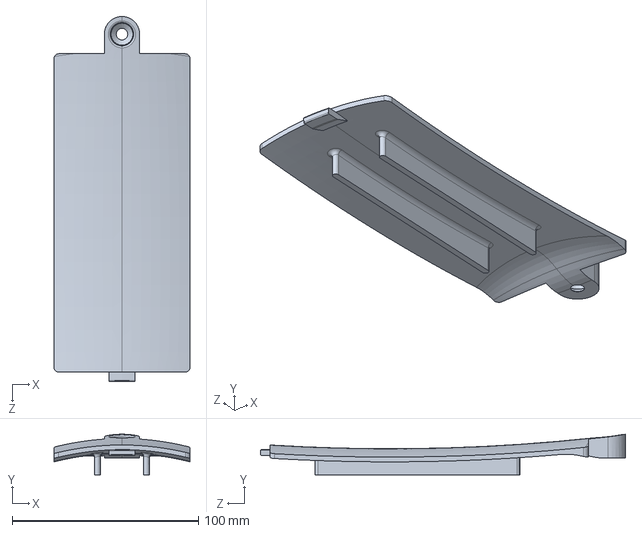
[picture p96: CAD file, 2019-07-20]
3D/Wolf/V2/PARTS/COVER OF THE BATTERY - ROBOT DOG.SLDPRT
73.0 x 21.8 x 196.0 mm
