mkramar/dizzyrobot/3D/3D - Motor 5/Housing top cover.SLDPRT

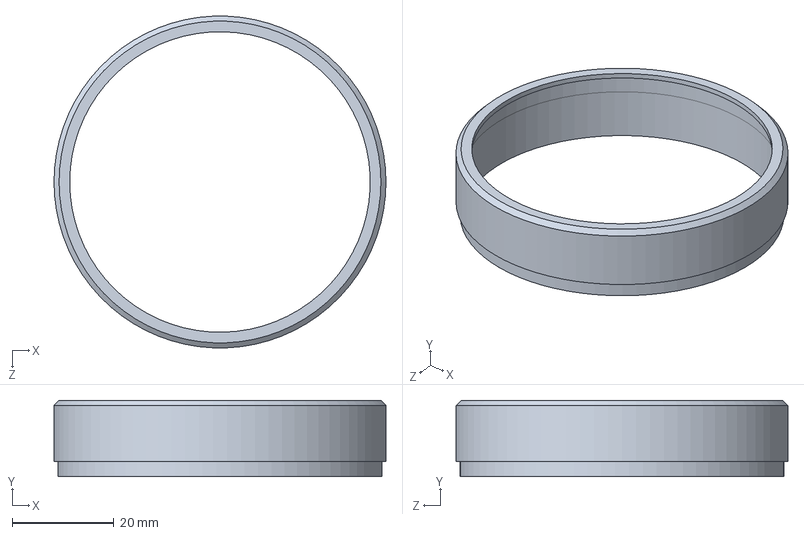
[picture p97: CAD file, 2018-11-04]
3D/3D - Motor 5/Housing top cover.SLDPRT
65.3 x 15.0 x 65.2 mm
