mkramar/dizzyrobot/3D/3D - Motor 6/Carrier.SLDPRT

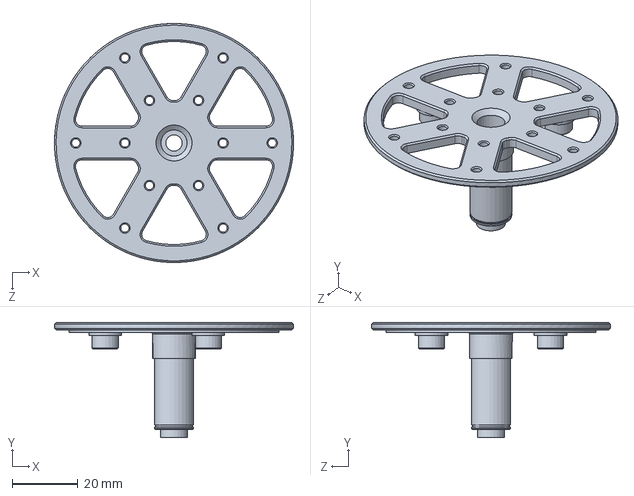
[picture p98: CAD file, 2018-12-22]
3D/3D - Motor 6/Carrier.SLDPRT
73.0 x 35.1 x 73.0 mm
