mkramar/dizzyrobot/3D/3D - Motor 8/motor 8/Magnet ring.SLDPRT

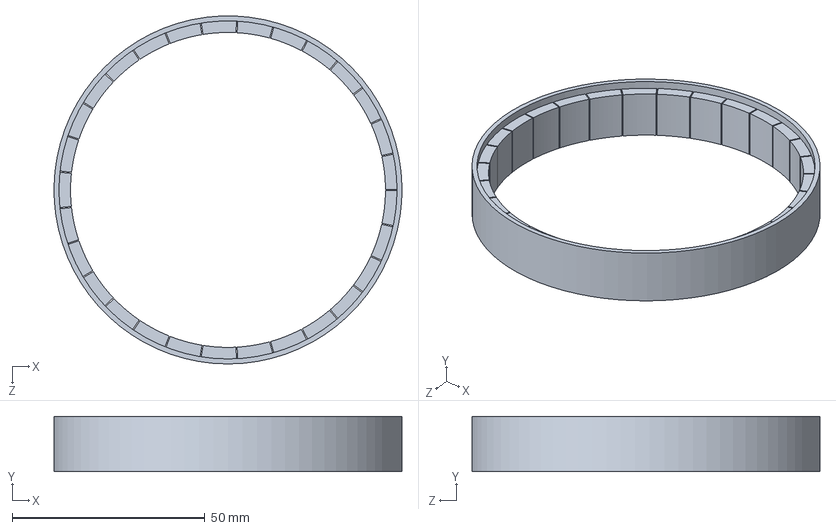
[picture p99: CAD file, 2018-12-09]
3D/3D - Motor 8/motor 8/Magnet ring.SLDPRT
90.2 x 14.3 x 90.2 mm
