mkramar/dizzyrobot/3D/NEW MODEL/ITEM/SMALL CONTROLLER - ROBOT DOG.SLDPRT

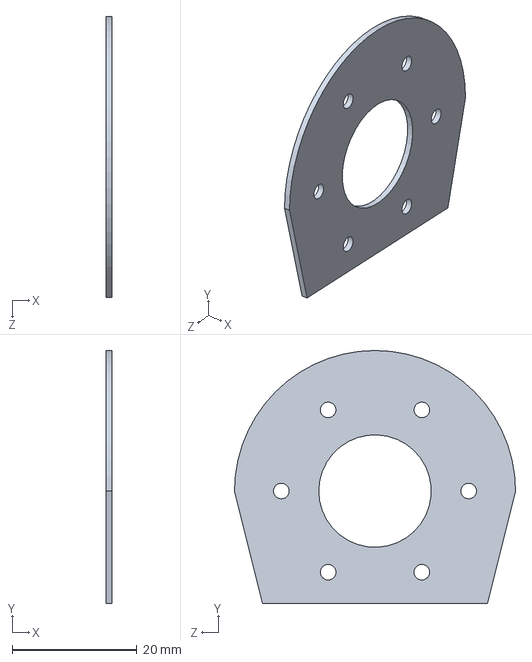
[picture p100: CAD file, 2020-03-14]
3D/NEW MODEL/ITEM/SMALL CONTROLLER - ROBOT DOG.SLDPRT
1.00 x 40.5 x 45.0 mm
