mkramar/dizzyrobot/3D/NEW MODEL/MODEL 6/MAGNETINC CARRIER POSITION RING - MOTOR 6.SLDPRT

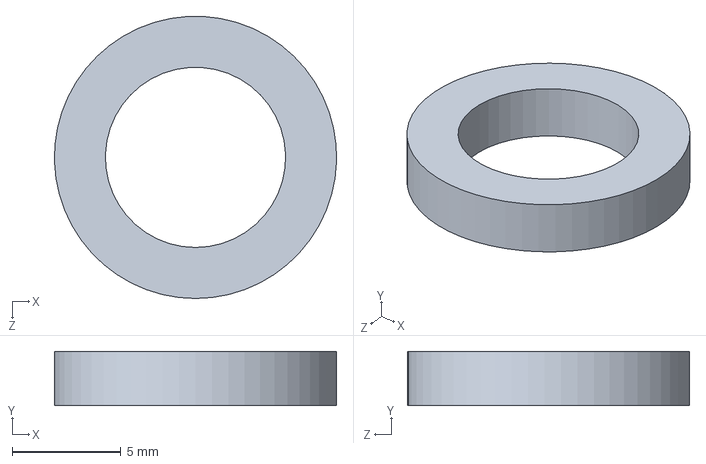
[picture p101: CAD file, 2019-02-25]
3D/NEW MODEL/MODEL 6/MAGNETINC CARRIER POSITION RING - MOTOR 6.SLDPRT
13.0 x 2.50 x 13.0 mm
