mkramar/dizzyrobot/3D/NEW MODEL/MOTOR 8/MOTOR CORE - MOTOR 8.SLDPRT

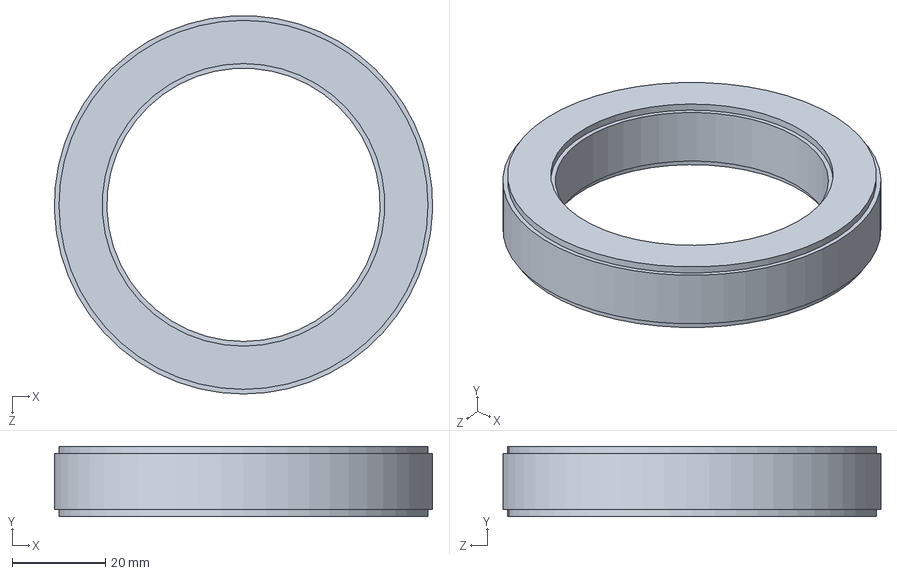
[picture p102: CAD file, 2020-03-14]
3D/NEW MODEL/MOTOR 8/MOTOR CORE - MOTOR 8.SLDPRT
81.0 x 15.0 x 80.9 mm
