mkramar/dizzyrobot/Mold/Hip/Mold top.sldprt

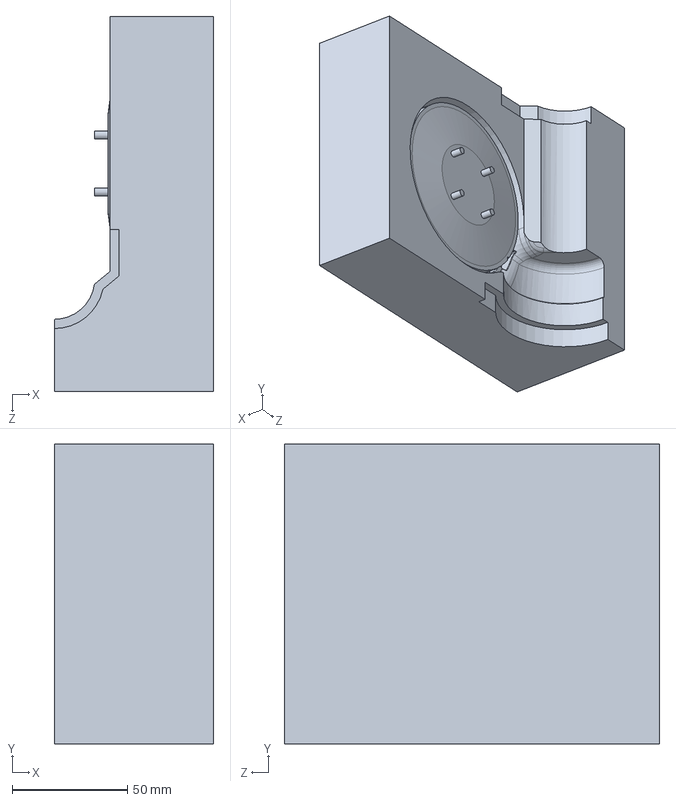
[picture p103: CAD file, 2018-03-08]
Mold/Hip/Mold top.sldprt
69.0 x 130.0 x 162.7 mm
