mkramar/dizzyrobot/3D/3D - Motor 5/PCB S.SLDPRT

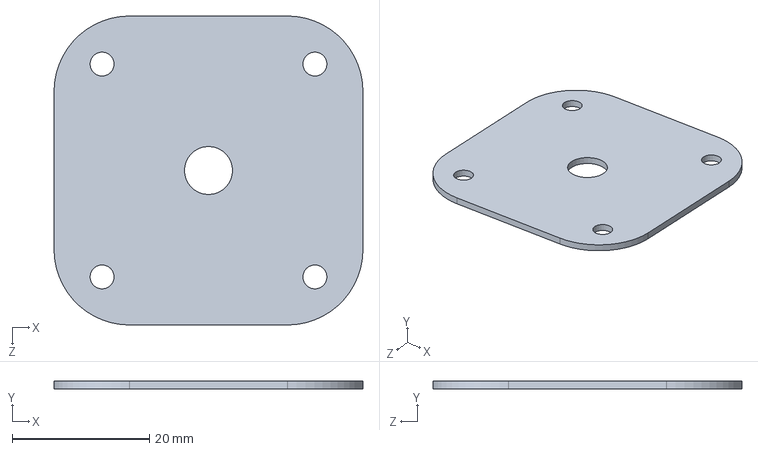
[picture p104: CAD file, 2018-11-04]
3D/3D - Motor 5/PCB S.SLDPRT
45.0 x 1.20 x 45.0 mm
