mkramar/dizzyrobot/3D/3D - Motor 6.1/Outer ring.SLDPRT

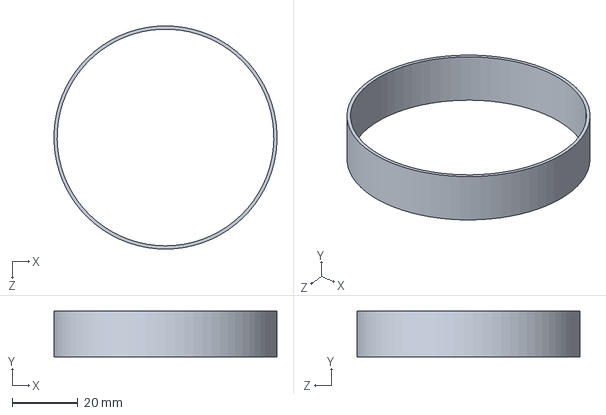
[picture p105: CAD file, 2019-02-16]
3D/3D - Motor 6.1/Outer ring.SLDPRT
67.9 x 14.0 x 68.0 mm
