mkramar/dizzyrobot/3D/NEW MODEL/ITEM/BIGGER CONTROLLER - ROBOT DOG.SLDPRT

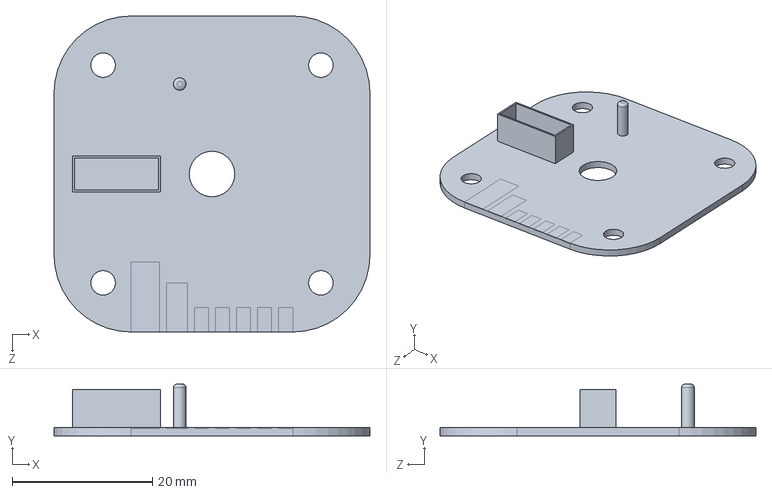
[picture p106: CAD file, 2020-03-14]
3D/NEW MODEL/ITEM/BIGGER CONTROLLER - ROBOT DOG.SLDPRT
45.0 x 7.40 x 45.0 mm
