mkramar/dizzyrobot/3D/NEW MODEL/MOTOR 8/RING GEAR M1 Z84_GEAR TRAX - MOTOR 8.SLDPRT

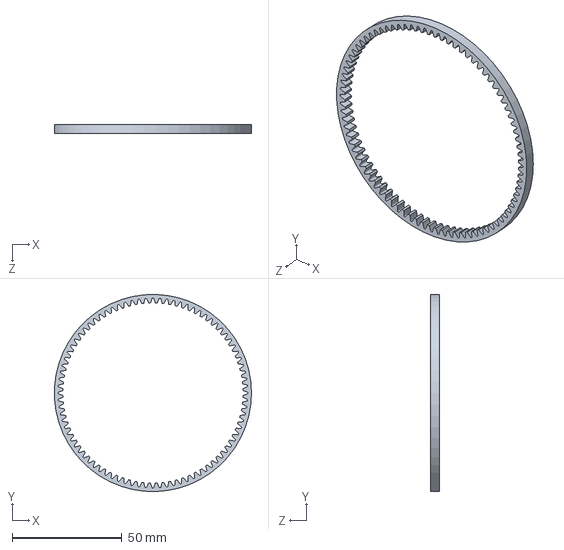
[picture p107: CAD file, 2020-03-14]
3D/NEW MODEL/MOTOR 8/RING GEAR M1 Z84_GEAR TRAX - MOTOR 8.SLDPRT
89.9 x 90.0 x 4.00 mm
