mkramar/dizzyrobot/3D/3D - Motor 5/Motor core S.SLDPRT

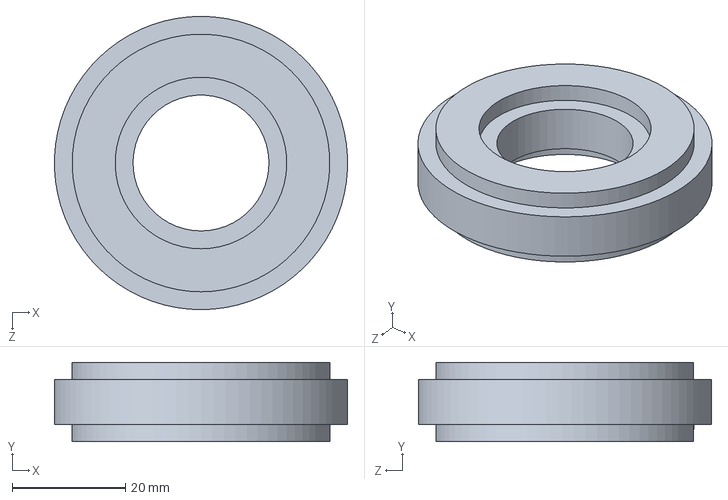
[picture p108: CAD file, 2018-10-10]
3D/3D - Motor 5/Motor core S.SLDPRT
51.8 x 14.0 x 51.8 mm
