mkramar/dizzyrobot/3D/3D - Motor 6.1/Rotor magnet 12x6x2.SLDPRT

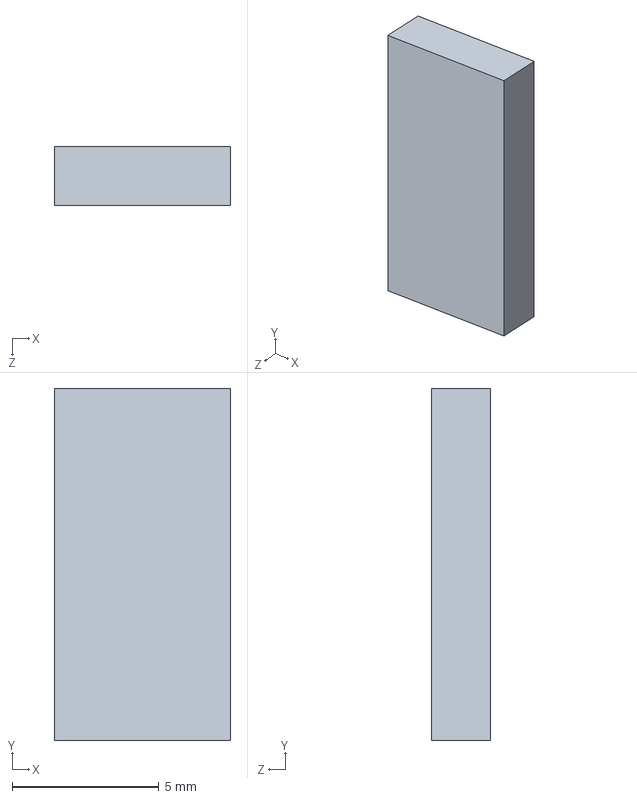
[picture p109: CAD file, 2019-02-16]
3D/3D - Motor 6.1/Rotor magnet 12x6x2.SLDPRT
6.00 x 12.0 x 2.00 mm
