mkramar/dizzyrobot/Mold/Hip/Motor cores silicone mold assemvly.SLDPRT

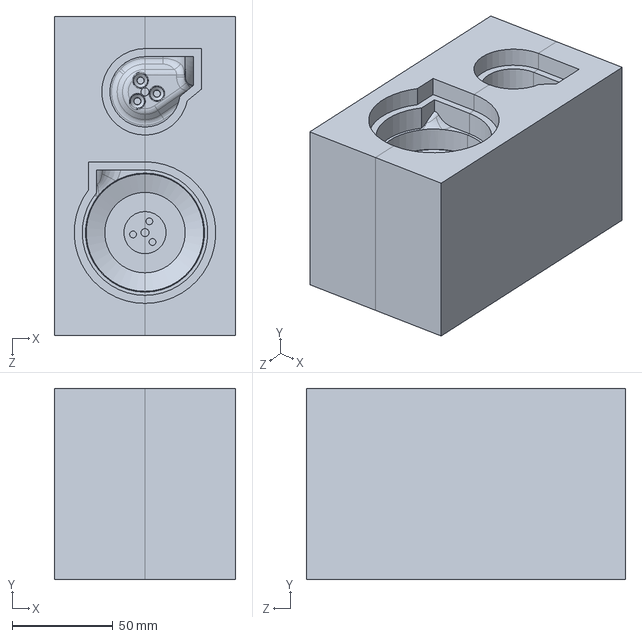
[picture p110: CAD file, 2018-03-08]
Mold/Hip/Motor cores silicone mold assemvly.SLDPRT
90.0 x 95.2 x 158.7 mm
