mkramar/dizzyrobot/_temp/axis-print-2.scad

include <axis.scad>

$fn = 100;

rotate([90, 0, 0])
axis2Gear();
