mkramar/dizzyrobot/_temp/axis-print-4.scad

include <axis-print.scad>

$fn = 100;

rotate([90, 0, 0])
difference() {
	union()
	{
		difference()
		{
			part1();
			cutA();

		}
		
		intersection()
		{
			partBase();
			boltsBplus();
		}
	}
	boltsBminus();
}
