mkramar/dizzyrobot/_temp/axis-print-5.scad

include <axis.scad>

$fn = 100;

rotate([0, 90, 0])
	axis1Ring();
