mkramar/dizzyrobot/print/part 2/part2.print-1.scad

use <part2.print.scad>

rotate([0, 90, 0])
difference()
{
	union()
	{
		intersection() 
		{
			part2();
			cutA();
		}
		boltsAplus();
	}
	
	boltsAminus();
}
