mkramar/dizzyrobot/brushless/print/part1/part1-print2.scad

include <../../parts/part1.scad>
use <part1-print.scad>


difference() {
	union()
	{
		difference()
		{
			part1();
			cutA();
		}
		boltsBplus();
	}
	boltsBminus();
}
