mkramar/dizzyrobot/(list of files, cad)

Other CAD files:
3D/Wolf/V2/SMALL PART - MOTOR 6.SLDASM
3D/Wolf/V2/BIG PART - MOTOR 6.SLDASM
3D/NEW MODEL/MODEL 6/ASSEMBLY/SMALL MOTOR 6 ASSEMBLY.SLDASM
3D/NEW MODEL/MOTOR 8/ASSEMBLY/BIG PART MOTOR 8.SLDASM
3D/Wolf/V2/SMALL PART MOTOR 8.SLDASM
3D/3D - Motor 6.1/Gearing/Ring gear Z61 M1.SLDPRT
3D/3D - Motor 6/Gearing/Planet gear Z19 H13 M1.SLDPRT
3D/NEW MODEL/ITEM/CONTROLLER ROBOT WOLF.SLDPRT
3D/NEW MODEL/MirrorSHOULDER - ROBOT WOLF.SLDPRT
3D/NEW MODEL/MODEL 6/PART/PART 1 - MOTOR 6 - ROBOT DOG.SLDPRT
3D/Wolf/ROBOT DOG 10/PARTS/SHOULDER.SLDPRT
3D/Wolf/V2/PART/PART 2 - MOTOR 6 - ROBOT DOG.SLDPRT
3D/3D - Motor 5/Gearing/Sun gear M1 Z25 bore 20.SLDPRT
3D/3D - Motor 6/Gearing/Sun gear Z23 H17 M1.SLDPRT
3D/3D - Motor 8/extra/148-2Z.SLDPRT
3D/NEW MODEL/ITEM/BATTERY ROBOT WOLF.SLDPRT
3D/NEW MODEL/MOTOR 8/148-2Z_7804K116 - MOTOR 8.SLDPRT
3D/Wolf/V2/PART/PART 2 - MOTOR 8 - ROBOT DOG.SLDPRT
3D/3D - Motor 5/Internal rotor.SLDPRT
3D/3D - Motor 6.1/extra/KLM-21 internal retaining ring for hID 21 mm.SLDPRT
3D/NEW MODEL/ITEM/CONNECTOR 2.SLDPRT
3D/NEW MODEL/MODEL 6/148 8x14x4 mm BEARING_7804K116 - MOTOR 6.SLDPRT
3D/NEW MODEL/MOTOR 8/ROTOR FRAME - MOTOR 8.SLDPRT
3D/Wolf/V2/PART/PART 1 - MOTOR 8 - ROBOT DOG.SLDPRT
3D/3D - Motor 5/Rotor magnet ring.SLDPRT
3D/3D - Motor 8/Gearing/Sun Gear M1 Z28 bore 23.SLDPRT
3D/NEW MODEL/MODEL 6/ROTOR - MOTOR 6.SLDPRT
3D/NEW MODEL/MOTOR 8/POSITIONING MAGNET . MOTOR 8.SLDPRT
Mold/Hip/PART body.sldprt
3D/3D - Motor 6.1/Positioning magnet D4.SLDPRT
3D/3D - Motor 6/extra/148 8x14x4 mm bearing.SLDPRT
3D/Wolf/V2/PARTS/MirrorANOTHER THIGN - ROBOT DOG.SLDPRT
3D/3D - alternative/Magnetinc position ring.SLDPRT
3D/3D - Motor 6/Housing cover.SLDPRT
3D/3D - Motor 8/motor 8/Motor core.SLDPRT
3D/NEW MODEL/MODEL 6/6801 BEARING 12x21x5_5972K212 - MOTOR 6.SLDPRT
3D/Wolf/V2/PARTS/Connector 1.SLDPRT
3D/3D - alternative/Positioning magnet.SLDPRT
3D/3D - Motor 6/extra/KLM-21 internal retaining ring for hID 21 mm.SLDPRT
3D/3D - Motor 8/motor 8/Magnetinc position ring.SLDPRT
3D/NEW MODEL/MODEL 6/CLM-12 EXTERNAL RETAINING RING FOR sID 12 mm - MOTOR 6.SLDPRT
3D/NEW MODEL/MOTOR 8/6706 30x37x4 mm BEARING_5972K213 - MOTOR 8.SLDPRT
3D/Wolf/V2/PARTS/COVER OF THE THIGN - ROBOT DOG.SLDPRT
3D/3D - Motor 6.1/PCB.SLDPRT
3D/3D - Motor 6/PCB.SLDPRT
3D/3D - Motor 8/motor 8/PCB.SLDPRT
3D/NEW MODEL/MODEL 6/PLANET GEAR Z19 H13 M1_GEAR TRAX - MOTOR 6.SLDPRT
3D/3D - Motor 5/M07900 slipring.SLDPRT
3D/3D - Motor 5/Magnetinc position ring.SLDPRT
3D/3D - Motor 5/Positioning magnet.SLDPRT
3D/3D - Motor 5/extra/7804K126_STAINLESS STEEL BALL BEARING.SLDPRT
3D/3D - Motor 5/extra/92000A076_18-8 SS METRIC PAN HEAD PHIL MACHINE SCREW.SLDPRT
3D/3D - Motor 5/extra/M1408-0120.SLDPRT
3D/3D - Motor 6.1/Drawings/Motor 6 - Assembly and GD&T.SLDDRW
3D/3D - Motor 6.1/M07900 slipring.SLDPRT
3D/3D - Motor 6.1/Magnetinc carrier position ring.SLDPRT
3D/3D - Motor 6.1/extra/M3 x 3 mm pan head phillips screw.SLDPRT
3D/3D - Motor 6/Drawings/Motor 6 - Assembly and GD&T.SLDDRW
3D/3D - Motor 6/M07900 slipring.SLDPRT
3D/3D - Motor 6/Magnetinc carrier position ring.SLDPRT
3D/3D - Motor 6/Outer ring.SLDPRT
3D/3D - Motor 6/Positioning magnet D4.SLDPRT
3D/3D - Motor 6/Rotor magnet 12x6x2.SLDPRT
3D/3D - Motor 6/Stator.SLDPRT
3D/3D - Motor 6/extra/92000A076_18-8 SS METRIC PAN HEAD PHIL MACHINE SCREW.SLDPRT
3D/3D - Motor 6/extra/M3 x 3 mm pan head phillips screw.SLDPRT
3D/3D - Motor 8/Drawings/ECG C1 - enclosure.SLDDRW
3D/3D - Motor 8/Drawings/Gearing GD&T.SLDDRW
3D/3D - alternative/M07900 slipring.SLDPRT
3D/3D - alternative/PCB S.SLDPRT
3D/3D - alternative/extra/7804K126_STAINLESS STEEL BALL BEARING.SLDPRT
3D/3D - alternative/extra/92000A076_18-8 SS METRIC PAN HEAD PHIL MACHINE SCREW.SLDPRT
3D/3D - alternative/extra/M1408-0120.SLDPRT
3D/3D - alternative/extra/M3x4 18-8 SS FLAT-HEAD SOCKET CAP SCREW.SLDPRT
3D/NEW MODEL/MODEL 6/12x1 mm SPACER RING - MOTOR 6.sldprt
3D/NEW MODEL/MODEL 6/92000A076_18-8 SS METRIC PAN HEAD PHIL MACHINE SCREW_92000A076 - MOTOR 6.SLDPRT
3D/NEW MODEL/MODEL 6/HOUSING BASE - MOTOR 6.SLDPRT
3D/NEW MODEL/MODEL 6/HOUSING COVER - MOTOR 6.SLDPRT
3D/NEW MODEL/MODEL 6/M07900 SLIPRING - MOTOR 6.SLDPRT
3D/NEW MODEL/MODEL 6/OUTER RING - MOTOR 6.SLDPRT
3D/NEW MODEL/MODEL 6/PCB - MOTOR 6.SLDPRT
3D/NEW MODEL/MODEL 6/POSITIONING MAGNET D4 - MOTOR 6.SLDPRT
3D/NEW MODEL/MODEL 6/RING GEAR Z61 M1_GEAR TRAX - MOTOR 6.sldprt
3D/NEW MODEL/MODEL 6/ROTOR MAGNET 12x6x2 - MOTOR 6.SLDPRT
3D/NEW MODEL/MODEL 6/STATOR - MOTOR 6.SLDPRT
3D/NEW MODEL/MODEL 6/SUN GEAR Z23 H17 M1_GEAR TRAX - MOTOR 6.SLDPRT
3D/NEW MODEL/MOTOR 8/6803 17x26x5 mm BEARING_5972K213 - MOTOR 8.SLDPRT
3D/NEW MODEL/MOTOR 8/CARRIER - MOTOR 8.SLDPRT
3D/NEW MODEL/MOTOR 8/HOUSING BASE - MOTOR 8.SLDPRT
3D/NEW MODEL/MOTOR 8/MAGNET RING - MOTOR 8.SLDPRT
3D/NEW MODEL/MOTOR 8/MAGNETING POSITION RING - MOTOR 8.SLDPRT
3D/NEW MODEL/MOTOR 8/PCB - MOTOR 8.SLDPRT
3D/NEW MODEL/MOTOR 8/PLANET GEAR M1 Z28 bore 14_GEAR TRAX - MOTOR 8.SLDPRT
3D/NEW MODEL/MOTOR 8/RING GEAR M1 Z85 OD90_GEAR TRAX - MOTOR 8.SLDPRT
3D/NEW MODEL/MOTOR 8/SLIPRING - MOTOR 8.SLDPRT
3D/NEW MODEL/MOTOR 8/SUN GEAR M1 Z29 bore 23_GEAR TRAX - MOTOR 8.SLDPRT
3D/Wolf/V1/ITEM/ACRYLIC - ROBOT DOG.SLDPRT
3D/Wolf/V1/ITEM/BATTERY - ROBOT DOG.SLDPRT
3D/Wolf/V1/ITEM/BATTERY CONTROLER.SLDASM
3D/Wolf/V1/ITEM/BIGGER CONTROLLER - ROBOT DOG.SLDPRT
3D/Wolf/V1/ITEM/COMPUTER BOARD.SLDPRT
3D/Wolf/V1/ITEM/CONTROLLER BEHIND OF THE BATTERY - ROBOT DOG 38MM WITDH.SLDPRT
3D/Wolf/V1/ITEM/CONTROLLER BEHIND OF THE BATTERY - ROBOT DOG.SLDPRT
3D/Wolf/V1/ITEM/SMALL CONTROLLER - ROBOT DOG.SLDPRT
3D/Wolf/V1/MOTOR 8/148-2Z_7804K116 - MOTOR 8.SLDPRT
3D/Wolf/V1/MOTOR 8/6706 30x37x4 mm BEARING_5972K213 - MOTOR 8.SLDPRT
3D/Wolf/V1/MOTOR 8/6803 17x26x5 mm BEARING_5972K213 - MOTOR 8.SLDPRT
3D/Wolf/V1/MOTOR 8/ASSEMBLY/BIG PART MOTOR 8.SLDASM
3D/Wolf/V1/MOTOR 8/ASSEMBLY/MOTOR 8 ASSEMBLY.SLDASM
3D/Wolf/V1/MOTOR 8/ASSEMBLY/SMALL PART MOTOR 8.SLDASM
3D/Wolf/V1/MOTOR 8/CARRIER - MOTOR 8.SLDPRT
3D/Wolf/V1/MOTOR 8/HOUSING BASE - MOTOR 8.SLDPRT
3D/Wolf/V1/MOTOR 8/HOUSING COVER - MOTOR 8.SLDPRT
3D/Wolf/V1/MOTOR 8/MAGNET RING - MOTOR 8.SLDPRT
3D/Wolf/V1/MOTOR 8/MAGNETING POSITION RING - MOTOR 8.SLDPRT
3D/Wolf/V1/MOTOR 8/MOTOR CORE - MOTOR 8.SLDPRT
3D/Wolf/V1/MOTOR 8/PART/PART 1 - MOTOR 8 - ROBOT DOG.SLDPRT
3D/Wolf/V1/MOTOR 8/PART/PART 2 - MOTOR 8 - ROBOT DOG.SLDPRT
3D/Wolf/V1/MOTOR 8/PLANET GEAR M1 Z28 bore 14_GEAR TRAX - MOTOR 8.SLDPRT
3D/Wolf/V1/MOTOR 8/POSITIONING MAGNET . MOTOR 8.SLDPRT
3D/Wolf/V1/MOTOR 8/RING GEAR M1 Z84_GEAR TRAX - MOTOR 8.SLDPRT
3D/Wolf/V1/MOTOR 8/ROTOR FRAME - MOTOR 8.SLDPRT
3D/Wolf/V1/MOTOR 8/SLIPRING - MOTOR 8.SLDPRT
3D/Wolf/V1/MOTOR 8/SUN GEAR M1 Z28 bore 23_GEAR TRAX - MOTOR 8.SLDPRT
3D/Wolf/V1/ROBOT DOG 10/PARTS/ANOTHER THIGN - ROBOT DOG.SLDPRT
3D/Wolf/V1/ROBOT DOG 10/PARTS/COVER OF THE BATTERY - ROBOT DOG.SLDPRT
3D/Wolf/V1/ROBOT DOG 10/PARTS/COVER OF THE CAMERA BOARD - ROBOT DOG.SLDPRT
3D/Wolf/V1/ROBOT DOG 10/PARTS/COVER OF THE COMPUTER BOARD - ROBOT DOG.SLDPRT
3D/Wolf/V1/ROBOT DOG 10/PARTS/COVER OF THE LEG - ROBOT DOG.SLDPRT
3D/Wolf/V1/ROBOT DOG 10/PARTS/COVER OF THE THIGN - ROBOT DOG.SLDPRT
3D/Wolf/V1/ROBOT DOG 10/PARTS/LEG - ROBOT DOG.SLDPRT
3D/Wolf/V1/ROBOT DOG 10/PARTS/MirrorANOTHER THIGN - ROBOT DOG.SLDPRT
3D/Wolf/V1/ROBOT DOG 10/PARTS/MirrorCOVER OF THE THIGN - ROBOT DOG.SLDPRT
3D/Wolf/V1/ROBOT DOG 10/PARTS/MirrorLEFT BACK TORSO - ROBOT DOG.SLDPRT
3D/Wolf/V1/ROBOT DOG 10/PARTS/MirrorLEFT FRONT TORSO - ROBOT DOG.SLDPRT
3D/Wolf/V1/ROBOT DOG 10/PARTS/MirrorSHOULDER.SLDPRT
3D/Wolf/V1/ROBOT DOG 10/PARTS/TORSO ROBOT DOG 10.SLDPRT
3D/Wolf/V2/ITEM/BIGGER CONTROLLER - ROBOT DOG.SLDPRT
3D/Wolf/V2/ITEM/CONTROLLER BEHIND OF THE BATTERY - ROBOT DOG 38MM WITDH.SLDPRT
3D/Wolf/V2/ITEM/SMALL CONTROLLER - ROBOT DOG.SLDPRT
3D/Wolf/V2/PARTS/ANOTHER THIGN - ROBOT DOG.SLDPRT
3D/Wolf/V2/PARTS/COVER OF THE LEG - ROBOT DOG.SLDPRT
3D/Wolf/V2/PARTS/LEG - ROBOT DOG.SLDPRT
Mold/Hip/Cavity 1.sldprt
Mold/Hip/Cavity 2.sldprt
Mold/Hip/Hip mold tools.SLDPRT
Mold/Hip/M6 front core.sldprt
Mold/Hip/PLastic mold for silicone motor cores part2.sldprt
