mkramar/dizzyrobot/3D/3D - Motor 6.1/Drawings/Motor 6 - Assembly and GD&T.PDF

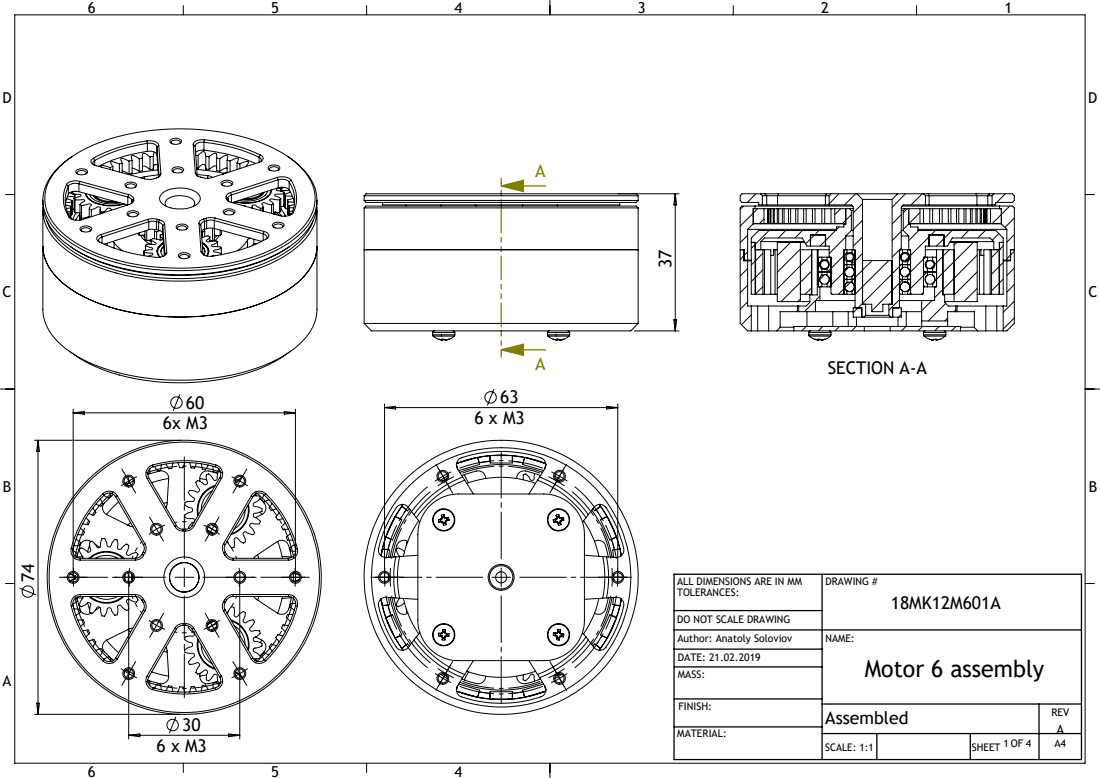
[picture p111: page 1]
SECTION A-A; Motor 6 assembly; SCALE: 1:1; SHEET; DRAWING #

ALL DIMENSIONS ARE IN MM
TOLERANCES:

DO NOT SCALE DRAWING
Author: Anatoly Soloviov
DATE: 21.02.2019
MASS:

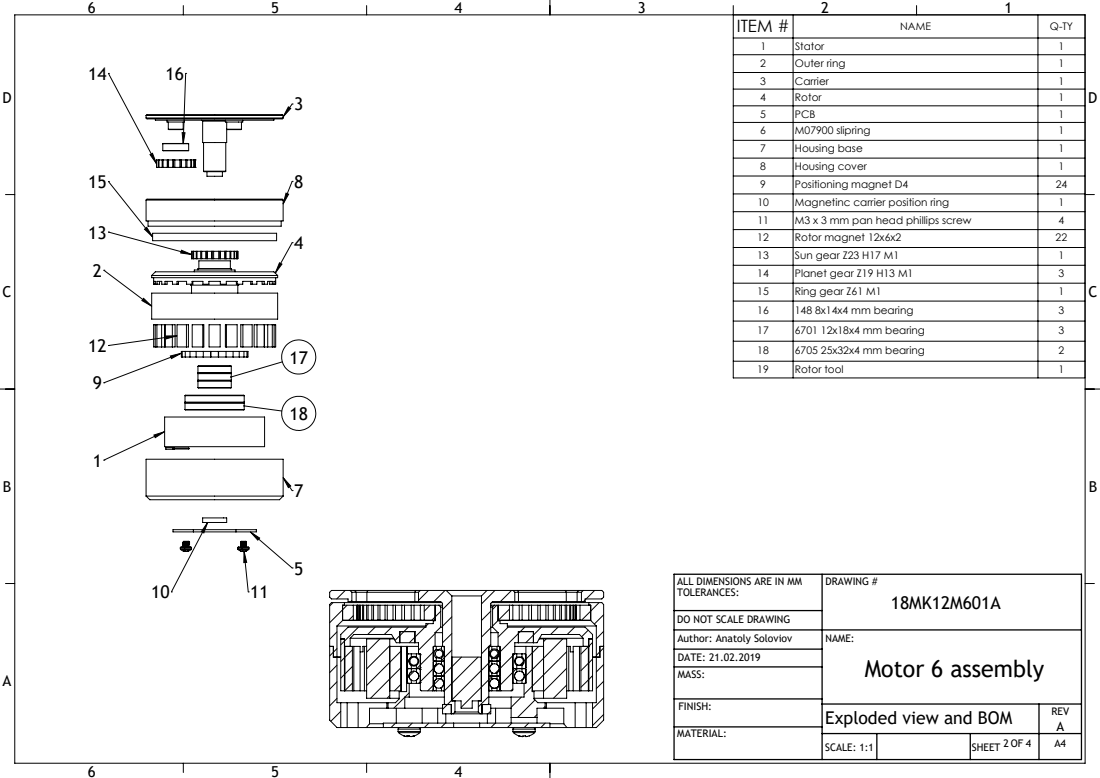
[picture p112: page 2]
ITEM #; NAME; Stator; Outer ring; Carrier; Rotor; PCB; M07900 slipring; Housing base; Housing cover; Positioning magnet D4; Motor 6 assembly; DRAWING #

10 | Magnetinc carrier position ring | 1
11 | M3 x 3 mm pan head phillips screw | 4
12 | Rotor magnet 12x6x2 | 22
13 | Sun gear Z23 H17 M1 | 1
14 | Planet gear Z19 H13 M1 | 3
15 | Ring gear Z61 M1 | 1
16 | 148 8x14x4 mm bearing | 3
17 | 6701 12x18x4 mm bearing | 3
18 | 6705 25x32x4 mm bearing | 2
19 | Rotor tool | 1

ALL DIMENSIONS ARE IN MM
TOLERANCES:

DO NOT SCALE DRAWING
Author: Anatoly Soloviov
DATE: 21.02.2019
MASS:

Exploded view and BOM | REVA MATERIAL:

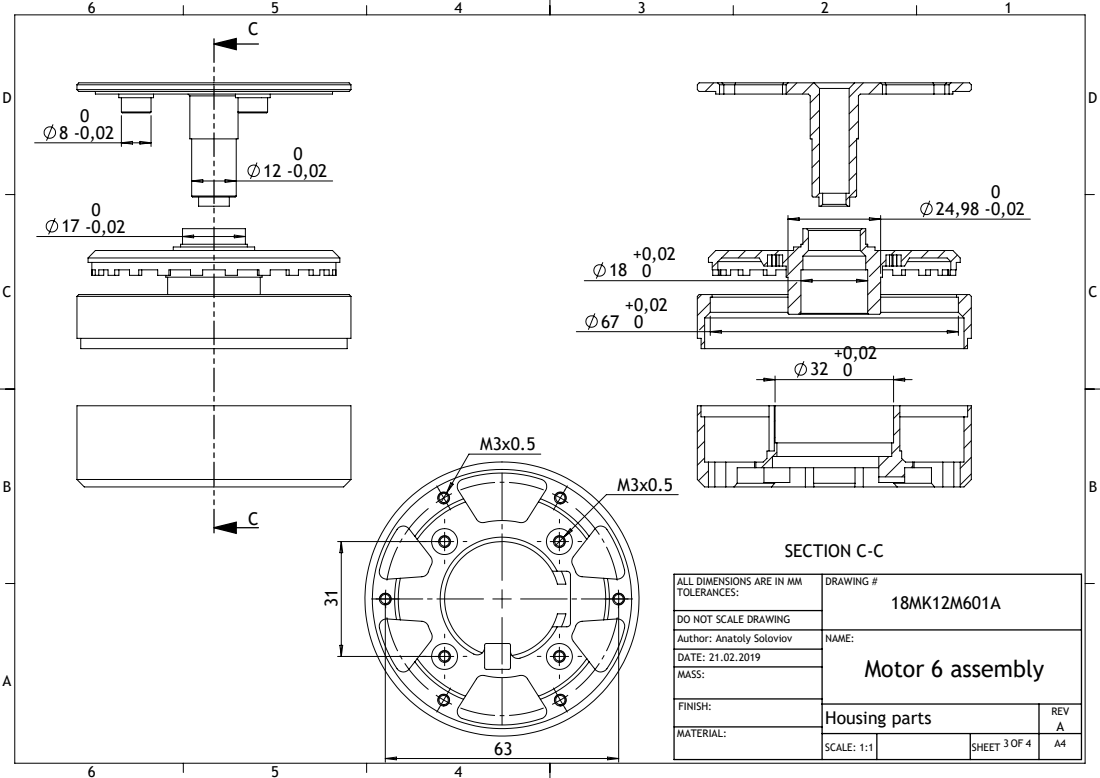
[picture p113: page 3]
SECTION C-C; Motor 6 assembly; DRAWING #; A MATERIAL:; Housing parts

ALL DIMENSIONS ARE IN MM
TOLERANCES:

DO NOT SCALE DRAWING
Author: Anatoly Soloviov
DATE: 21.02.2019
MASS:

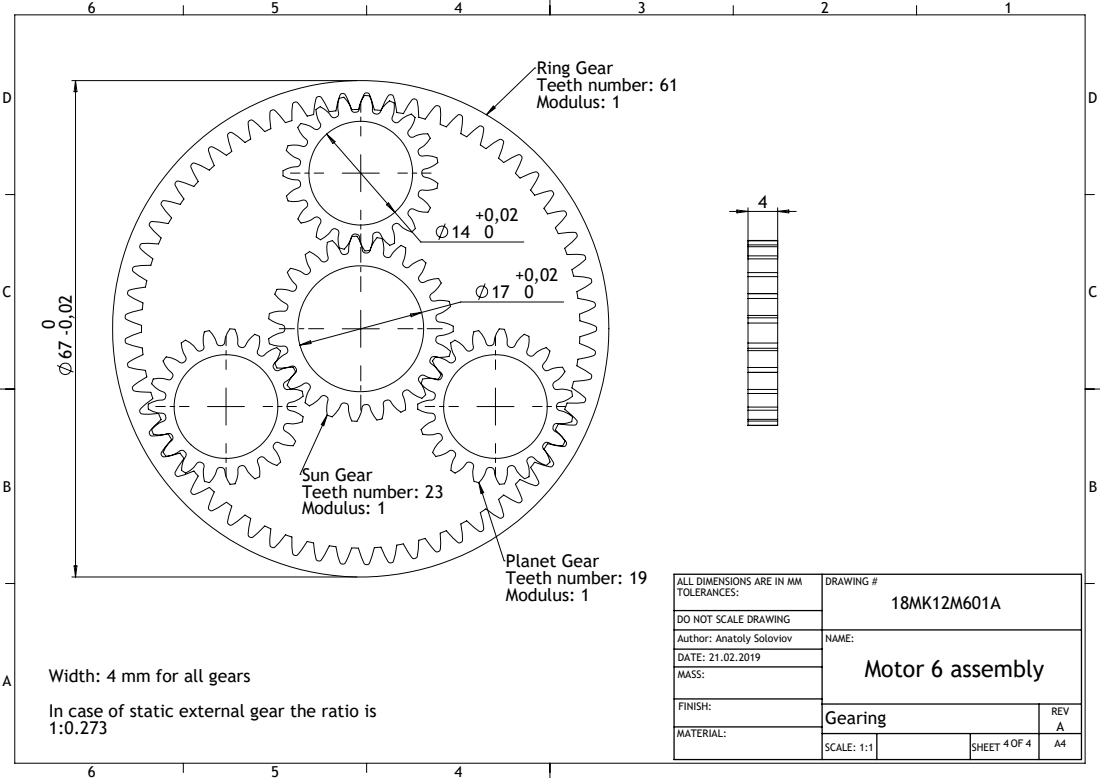
[picture p114: page 4]
Ring Gear Teeth number: 61 Modulus: 1; Planet Gear Teeth number: 19 Modulus: 1; Sun Gear Teeth number: 23 Modulus: 1; Width: 4 mm for all gears; Motor 6 assembly; DRAWING #; A MATERIAL:

ALL DIMENSIONS ARE IN MM
TOLERANCES:

DO NOT SCALE DRAWING
Author: Anatoly Soloviov
DATE: 21.02.2019
MASS:

In case of static external gear the ratio is
