mkramar/dizzyrobot/3D/3D - Motor 6/Drawings/Motor 6 - Assembly and GD&T.PDF

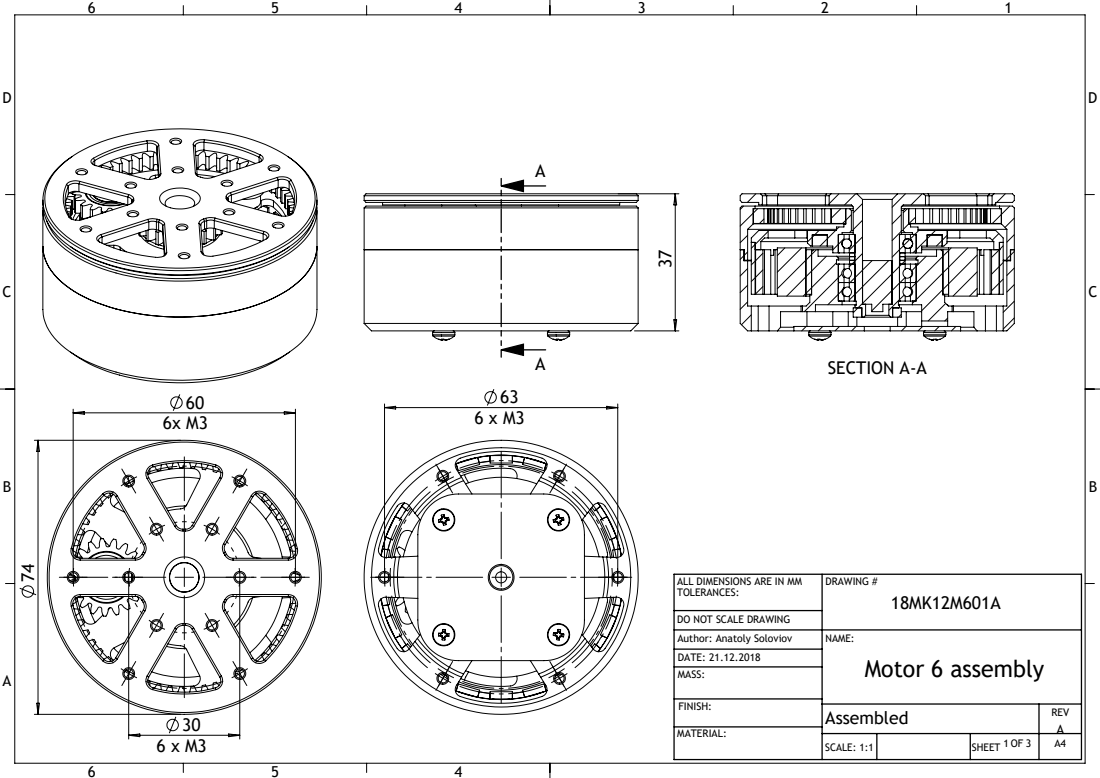
[picture p115: page 1]
SECTION A-A; Motor 6 assembly; SCALE: 1:1; SHEET; DRAWING #

ALL DIMENSIONS ARE IN MM
TOLERANCES:

DO NOT SCALE DRAWING
Author: Anatoly Soloviov
DATE: 21.12.2018
MASS:

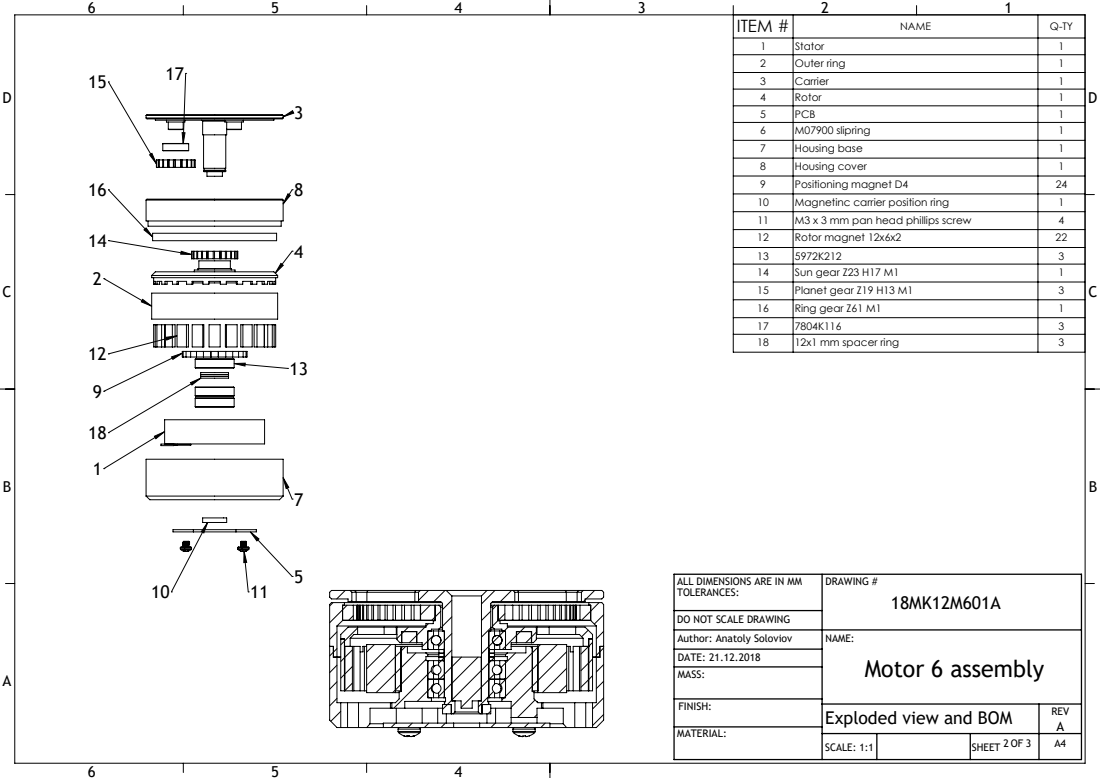
[picture p116: page 2]
ITEM #; NAME; Stator; Outer ring; Carrier; Rotor; PCB; M07900 slipring; Housing base; Housing cover; Positioning magnet D4; Motor 6 assembly; DRAWING #

10 | Magnetinc carrier position ring | 1
11 | M3 x 3 mm pan head phillips screw | 4
12 | Rotor magnet 12x6x2 | 22
13 | 5972K212 | 3
14 | Sun gear Z23 H17 M1 | 1
15 | Planet gear Z19 H13 M1 | 3
16 | Ring gear Z61 M1 | 1
17 | 7804K116 | 3
18 | 12x1 mm spacer ring | 3

ALL DIMENSIONS ARE IN MM
TOLERANCES:

DO NOT SCALE DRAWING
Author: Anatoly Soloviov
DATE: 21.12.2018
MASS:

Exploded view and BOM | REVA MATERIAL:

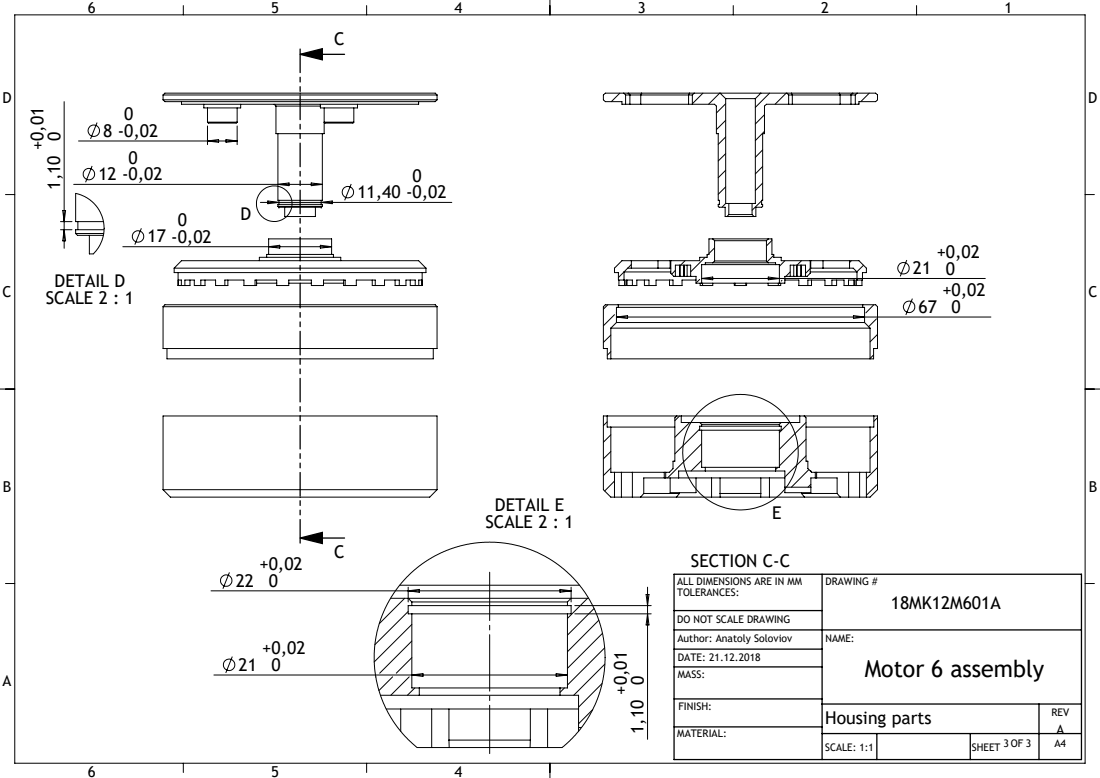
[picture p117: page 3]
SECTION C-C; DETAIL D SCALE 2 : 1; DETAIL E SCALE 2 : 1; Motor 6 assembly; DRAWING #; Housing parts

ALL DIMENSIONS ARE IN MM
TOLERANCES:

DO NOT SCALE DRAWING
Author: Anatoly Soloviov
DATE: 21.12.2018
MASS:
