mkramar/dizzyrobot/3D/3D - Motor 8/Drawings/Motor 8 - enclosure - 2018.12.21.PDF

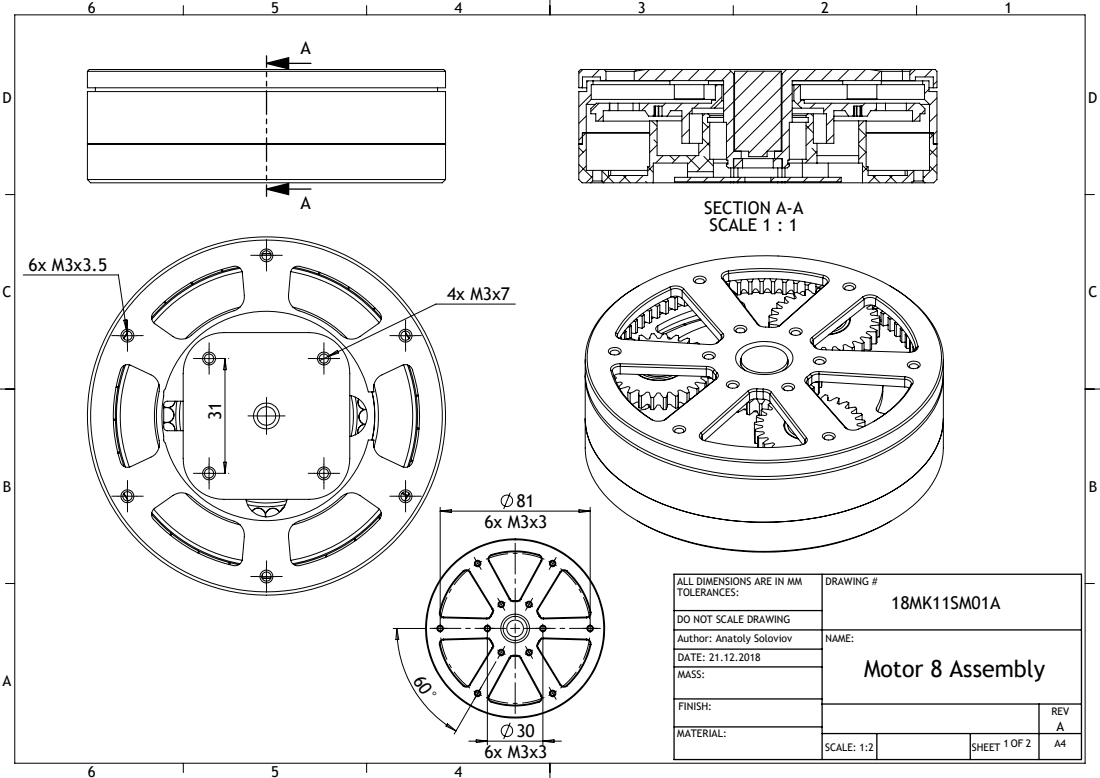
[picture p118: page 1]
SECTION A-A; SCALE 1 : 1; Motor 8 Assembly; DRAWING #

ALL DIMENSIONS ARE IN MM
TOLERANCES:

DO NOT SCALE DRAWING
Author: Anatoly Soloviov
DATE: 21.12.2018
MASS:

REV A MATERIAL:

SCALE: 1:2 | | 1 OF 2 SHEET | A4

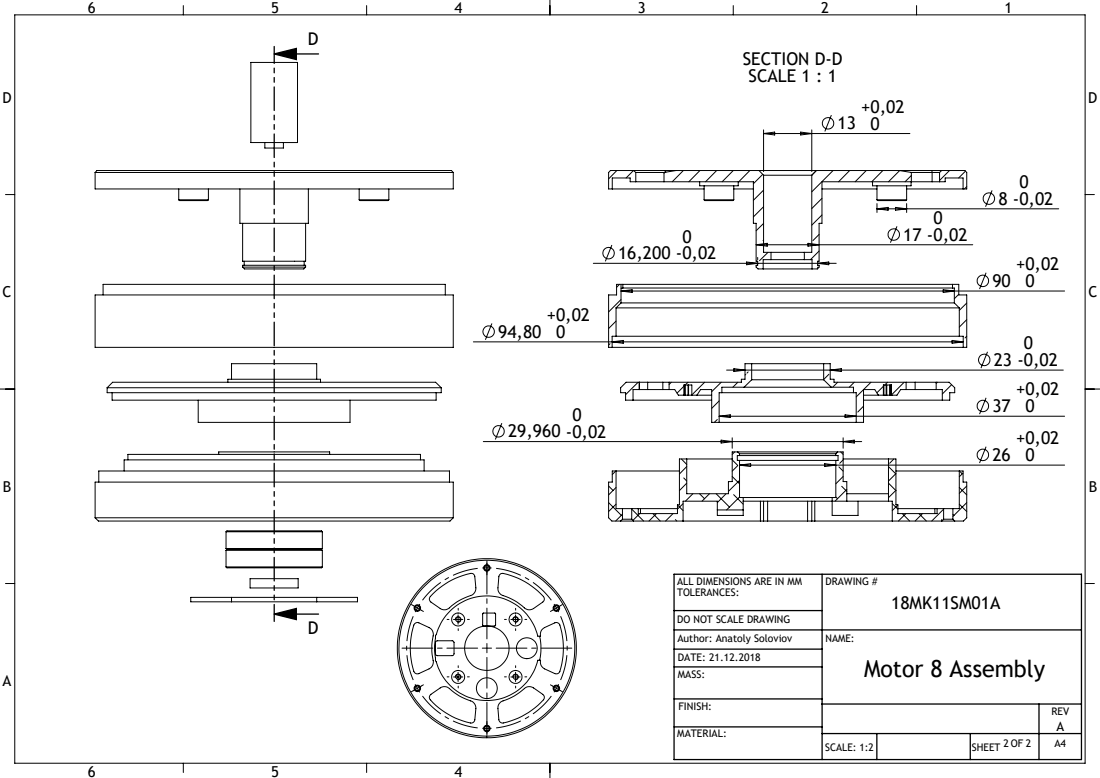
[picture p119: page 2]
SECTION D-D SCALE 1 : 1; Motor 8 Assembly; DRAWING #

ALL DIMENSIONS ARE IN MM
TOLERANCES:

DO NOT SCALE DRAWING
Author: Anatoly Soloviov
DATE: 21.12.2018
MASS:

REVA MATERIAL:

SCALE: 1:2 | | 2 OF 2 SHEET | A4
