mkramar/dizzyrobot/Electronics/Mainboard/Schematic/Mainboard.kicad_pcb

## KiCad design Electronics/Mainboard/Schematic/Mainboard.kicad_pcb (2019-10-25)

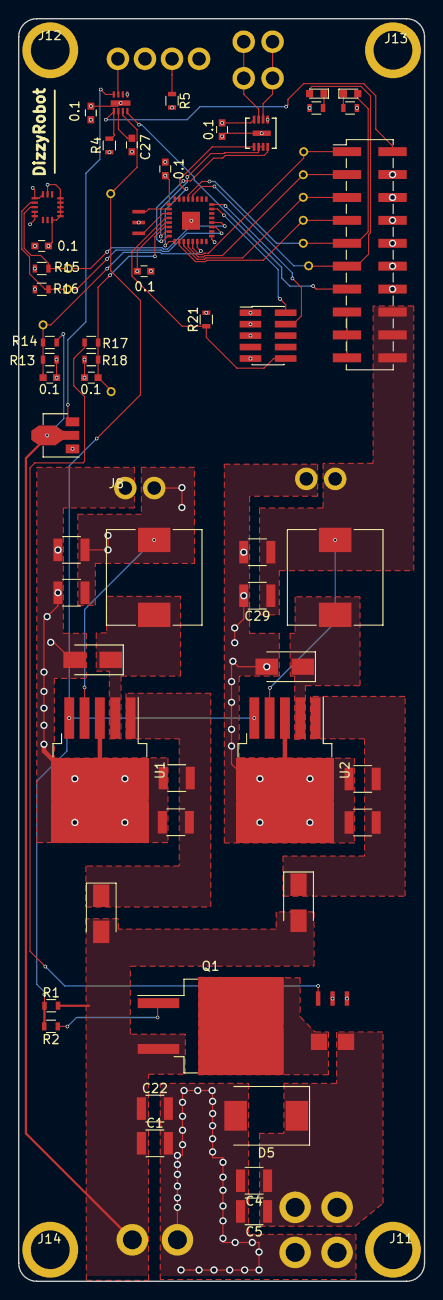
[picture p120: board Mainboard.kicad_pcb from above]

Board: 4 copper layers, 45.0 x 140.0 mm, 77 parts (0 on the bottom side), 42 nets.

Parts:
0.1, 0.1#2, 0.1#3, 0.1#4, 0.1#5, 0.1#6, 0.1#7: 0.1uF; C_0603
C1, C4, C5, C22: 20uF 50V; C_1210
C2, C3, C9, C10: 20uF; C_1210
C12, C13, C28, C29: 100uF; C_1210
C27: 0.33uF; C_0603
D1, D2, D3, D4: D_Small; D_SMA
D5: D_Small; D_SMC
D6, D7: LED_Small; LED_0603
J1, J2, J8, J9: CONN_01X02; 2x1.5-conn
J3, J4, J5: CONN_01X02; 2x2.1-conn
J6: CONN_02X05; Pin_Header_Straight_2x05_Pitch1.27mm_SMD
J7: CONN_02X10; Pin_Header_Straight_2x10_Pitch2.54mm_SMD
J10: CONN_01X04; 4x1.5-conn
J11: M1; Hole-m3
J12: M2; Hole-m3
J13: M3; Hole-m3
J14: M4; Hole-m3
J15, J16, J17, J18, J21, J22, J23, J24, J25, J26, J27: CONN_01X01; 0.6x1-conn
L1: 15uH; L_10.4x10.4_H4.8
L2: 33uH; L_10.4x10.4_H4.8
Q1: SQM120P04-04L; TO-263-2
R1, R2: 47K; R_0603
R4, R15, R16, R21: 10k; R_0603
R5, R19, R20: 390; R_0603
R13: 1k 1%; R_0603
R14: 30K 1%; R_0603
R17: 4k; R_0603
R18: 6k; R_0603
U1: AP1501A-3.3V; TO-263-5_TabPin3
U2: AP1501A-12V; TO-263-5_TabPin3
U3: ZXTR2012Z; SOT-89-3
U6: ACS781
U7: LSM6DS33; LGA16R50P3X5_300X300X100
U8: STM32F031K6U6; UFQFPN32-small-pad
U9: LTC2876
U10: LTC2954-2; 8-DFN-DDB
Y1: Resonator_Small; Oscillator

Connections:
3.3V: 0.1#2.2, 0.1#4.2, 0.1#5.2, 0.1#6.2, 0.1#7.1, C12.1, C28.1, J6.1, J7.10, J7.12, J7.14, J8.2, L1.2, R4.1, R5.2, R15.1, R16.1, R21.2, U1.4, U6.1, U7.1, U7.4, U7.5, U7.16, U8.1, U8.5, U8.17, U9.8
5V: J7.15, J7.17, J7.19
12V: C13.1, C29.1, J7.16, J7.18, J7.20, J9.2, L2.2, U2.4
+90V: C4.1, C5.1, D5.1, J4.2, J5.2, U6.6
+BATT: C1.1, C22.1, D3.2, D4.2, J3.2, Q1.3, R1.2, R14.2, U3.2
CS: J7.7, J27.1, U8.10
DE: U8.7, U9.2, U9.3
Earth: 0.1.1, 0.1#2.1, 0.1#3.2, 0.1#4.1, 0.1#5.1, 0.1#6.1, 0.1#7.2, C1.2, C2.2, C3.2, C4.2, C5.2, C9.2, C10.2, C12.2, C13.2, C22.2, C27.1, C28.2, C29.2, D1.2, D2.2, D5.2, J3.1, J4.1, J5.1, J6.3, J6.5, J6.9, J7.4, J7.6, J7.8, J8.1, J9.1, J10.1, J10.3, R13.1, R18.2, R19.1, R20.1, U1.3, U2.3, U3.1, U6.2, U7.8, U7.9, U7.10, U7.11, U7.12, U7.13, U7.15, U8.33, U9.5, U9.9, U10.1, U10.9, Y1.2
I_ADC: 0.1#3.1, J15.1, R17.2, R18.1, U8.6
MISO: J7.3, J25.1, U8.12
MOSI: J7.1, J26.1, U8.13
NRST: J6.10, R21.1, U8.4
unnamed: C3.1, C9.1, D3.1, U2.1
unnamed: C2.1, C10.1, D4.1, U1.1
unnamed: C27.2, U10.6
unnamed: D1.1, L1.1, U1.2
unnamed: D2.1, L2.1, U2.2
unnamed: D6.1, R19.2
unnamed: D7.1, R20.2
unnamed: J10.2, R5.1
unnamed: Q1.1, R2.1
unnamed: Q1.2, U6.5
unnamed: R17.1, U6.3
unnamed: U8.2, Y1.1
unnamed: U8.3, Y1.3
unnamed: U3.3, U10.4
PWR_BUTTON: J10.4, U10.3
PWR_EN: J23.1, R1.1, R2.2, U1.5, U2.5, U10.7
PWR_INT: J7.13, U10.8
RECVRDY: D7.2, J7.11, J18.1, U8.28
RESPRDY: D6.2, J7.9, J17.1, U8.29
RS-A: J1.2, J2.2, U9.7
RS-B: J1.1, J2.1, U9.6
RX: U8.9, U9.1
SCK: J7.5, J24.1, U8.11
SCL: J22.1, R16.2, U7.2, U8.19
SDA: J21.1, R15.2, U7.3, U8.20
SWDCLK: J6.4, U8.24
SWDIO: J6.2, U8.23
TX: U8.8, U9.4
V_ADC: 0.1.2, J16.1, R13.2, R14.1, U8.14
~PWR_KILL: J7.2, R4.2, U10.5
