mkramar/dizzyrobot/Electronics/Mainboard/Schematic/PiConn/PiConn.kicad_pcb

## KiCad design Electronics/Mainboard/Schematic/PiConn/PiConn.kicad_pcb (2019-06-24)

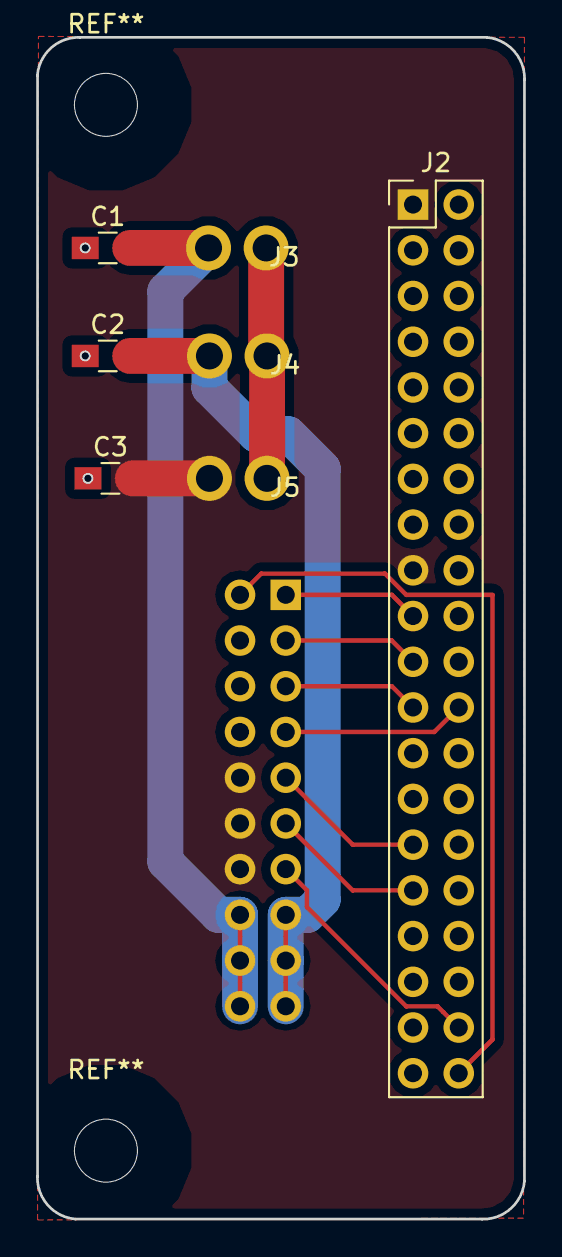
[picture p121: board PiConn.kicad_pcb from above]

Board: 2 copper layers, 27.1 x 65.7 mm, 8 parts (1 on the bottom side), 12 nets.

Parts:
C1, C2, C3: C_Small; C_0805_HandSoldering
J1: CONN_02X10; Pin_Header_Angled_2x10_Pitch2.54mm
J2: CONN_02X20; Pin_Header_Straight_2x20_Pitch2.54mm
J3, J4, J5: CONN_01X02; 2x1.5-conn

Connections:
3.3V: C3.2, J1.10, J1.12, J1.14, J2.1, J2.17, J5.2
5V: C2.2, J1.15, J1.17, J1.19, J4.2
12V: C1.2, J1.16, J1.18, J1.20, J3.2
CS: J1.7, J2.24
Earth: C1.1, C2.1, C3.1, J1.4, J1.6, J1.8, J2.6, J2.9, J2.14, J2.20, J2.25, J2.30, J2.34, J2.39, J3.1, J4.1, J5.1
MISO: J1.3, J2.21
MOSI: J1.1, J2.19
PWR_INT: J1.13, J2.38
RECVRDY: J1.11, J2.31
RESPRDY: J1.9, J2.29
SCK: J1.5, J2.23
~PWR_KILL: J1.2, J2.40
