mkramar/dizzyrobot/Electronics/Mainboard/Schematic/UpConn/UpConn.kicad_pcb

## KiCad design Electronics/Mainboard/Schematic/UpConn/UpConn.kicad_pcb (2019-06-24)

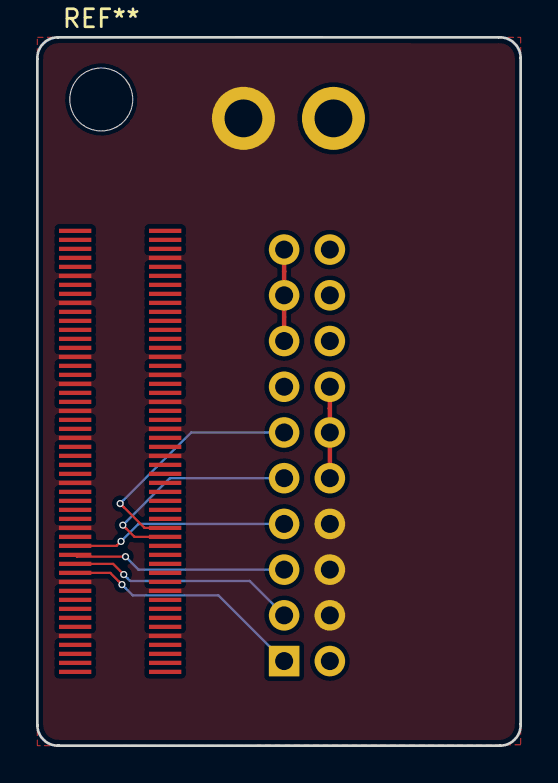
[picture p122: board UpConn.kicad_pcb from above]

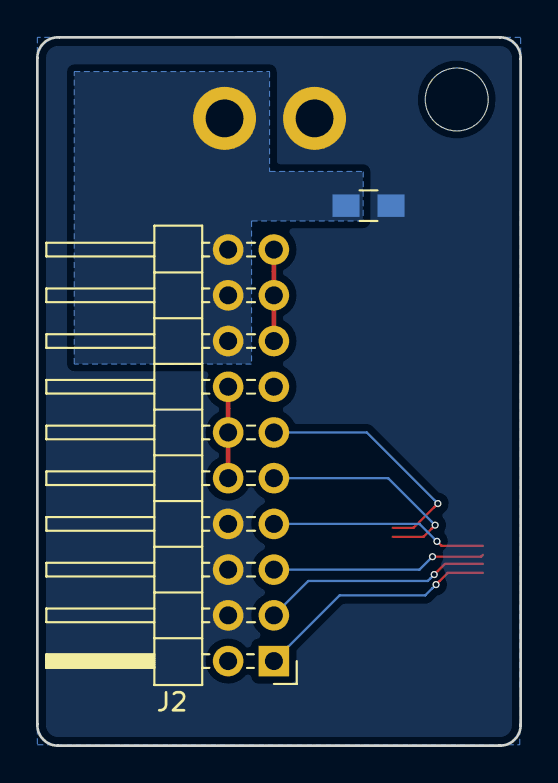
[picture p123: board UpConn.kicad_pcb from below]

Board: 2 copper layers, 26.9 x 39.4 mm, 4 parts (2 on the bottom side), 10 nets.

Parts:
C1: C_Small; C_0805_HandSoldering
J1: CONN_02X50; AXK6S-100
J2: CONN_02X10; Pin_Header_Angled_2x10_Pitch2.54mm
J3: CONN_01X02; 2x2.1-conn

Connections:
3.3V: J2.10, J2.12, J2.14
5V: J2.15, J2.17, J2.19
12V: C1.2, J2.16, J2.18, J2.20, J3.1
CS: J1.29, J2.7
Earth: C1.1, J1.9, J1.10, J1.20, J1.21, J1.33, J1.43, J1.50, J1.53, J1.56, J1.59, J1.62, J1.65, J1.68, J1.71, J1.72, J1.83, J1.89, J1.94, J2.4, J2.6, J2.8, J3.2
MISO: J1.25, J2.3
MOSI: J1.23, J2.1
RECVRDY: J1.34, J2.11
RESPRDY: J1.32, J2.9
SCK: J1.27, J2.5
