mkramar/dizzyrobot/Electronics/Motor/Schematic-Board/motor.kicad_pcb

## KiCad design Electronics/Motor/Schematic-Board/motor.kicad_pcb (2019-01-02)

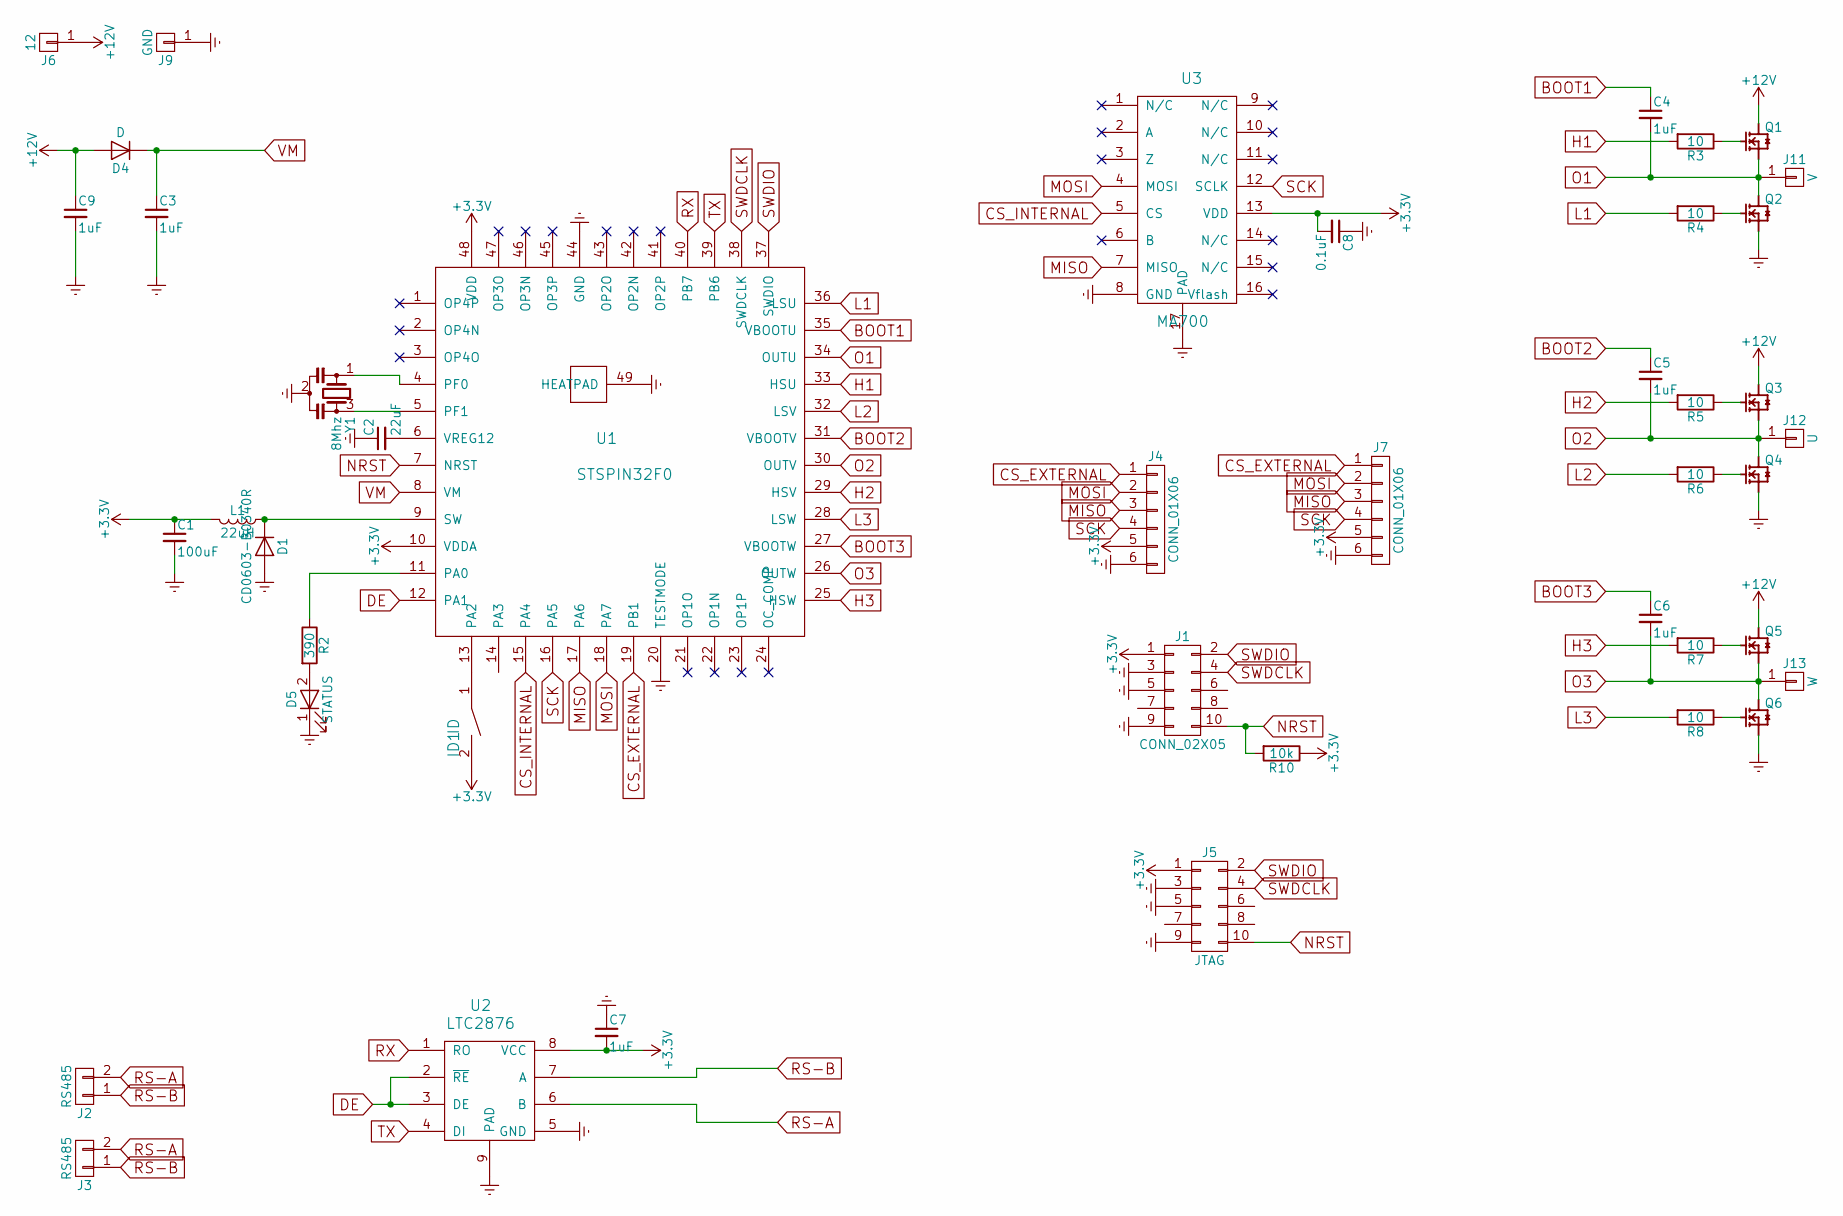
[picture p124: schematic motor.sch]

Parts:
C1: 100uF; C_0805
C2: 22uF; C_0805
C3, C9: 1uF; C_1206
C4, C5, C6, C7: 1uF; C_0603
C8: 0.1uF; C_0603
D1: CD0603-B0340R; D_SOD-323F
D4: D; D_SOD-323F
D5: STATUS; LED_0805_HandSoldering
ID1: ID; R_1206
J1: CONN_02X05; Pin_Header_Straight_2x05_Pitch1.27mm_SMD
J2, J3: RS485; Pin_Header_Straight_1x02_Pitch2.54mm
J4, J7: CONN_01X06; SPI_CONN
J5: JTAG; Tag-Connect_TC2050-IDC-NL
J6: 12; Pin_Header_Straight_1x01_Pitch2.54mm
J9: GND; Pin_Header_Straight_1x01_Pitch2.54mm
J11: V; Pin_Header_Straight_1x01_Pitch2.54mm
J12: U; Pin_Header_Straight_1x01_Pitch2.54mm
J13: W; Pin_Header_Straight_1x01_Pitch2.54mm
L1: 22uH; L_1210
Q1, Q2, Q3, Q4, Q5, Q6: PSMN3R3-40YS
R2: 390; R_0603
R3, R4, R5, R6, R7, R8: 10; R_0603
R10: 10k; R_0603
U1: STSPIN32F0; STSPIN32-nopad
U2: LTC2876
U3: MA700; QFN-16-1EP_3x3mm_Pitch0.5mm
Y1: 8Mhz; Oscillator

Connections:
+3V3: C1.1, C7.2, C8.2, ID1.2, J1.1, J4.5, J5.1, J7.5, L1.2, R10.1, U1.10 (VDDA), U1.48 (VDD), U2.8 (VCC), U3.13 (VDD)
+12V: C9.1, D4.2 (A), J6.1, Q1.5678 (D), Q3.5678 (D), Q5.5678 (D)
BOOT1: C4.1, U1.35 (VBOOTU)
BOOT2: C5.1, U1.31 (VBOOTV)
BOOT3: C6.1, U1.27 (VBOOTW)
CS_EXTERNAL: J4.1, J7.1, U1.19 (PB1)
CS_INTERNAL: U1.15 (PA4), U3.5 (CS)
DE: U1.12 (PA1), U2.2 (~RE), U2.3 (DE)
Earth: C1.2, C2.1, C3.2, C7.1, C8.1, C9.2, D1.2 (A), D5.1 (K), J1.3, J1.5, J1.9, J4.6, J5.3, J5.5, J5.9, J7.6, J9.1, Q2.1 (S), Q2.2 (S), Q2.3 (S), Q4.1 (S), Q4.2 (S), Q4.3 (S), Q6.1 (S), Q6.2 (S), Q6.3 (S), U1.20 (TESTMODE), U1.44 (GND), U1.49 (HEATPAD), U2.5 (GND), U2.9 (PAD), U3.8 (GND), U3.17 (PAD), Y1.2
H1: R3.2, U1.33 (HSU)
H2: R5.2, U1.29 (HSV)
H3: R7.2, U1.25 (HSW)
L1: R4.2, U1.36 (LSU)
L2: R6.2, U1.32 (LSV)
L3: R8.2, U1.28 (LSW)
MISO: J4.3, J7.3, U1.17 (PA6), U3.7 (MISO)
MOSI: J4.2, J7.2, U1.18 (PA7), U3.4 (MOSI)
NRST: J1.10, J5.10, R10.2, U1.7 (NRST)
unnamed: C2.2, U1.6 (VREG12)
unnamed: D1.1 (K), L1.1, U1.9 (SW)
unnamed: D5.2 (A), R2.2
unnamed: ID1.1, U1.13 (PA2)
unnamed: Q1.4 (G), R3.1
unnamed: Q2.4 (G), R4.1
unnamed: Q3.4 (G), R5.1
unnamed: Q4.4 (G), R6.1
unnamed: Q5.4 (G), R7.1
unnamed: Q6.4 (G), R8.1
unnamed: R2.1, U1.11 (PA0)
unnamed: U1.4 (PF0), Y1.1
unnamed: U1.5 (PF1), Y1.3
O1: C4.2, J11.1, Q1.1 (S), Q1.2 (S), Q1.3 (S), Q2.5678 (D), U1.34 (OUTU)
O2: C5.2, J12.1, Q3.1 (S), Q3.2 (S), Q3.3 (S), Q4.5678 (D), U1.30 (OUTV)
O3: C6.2, J13.1, Q5.1 (S), Q5.2 (S), Q5.3 (S), Q6.5678 (D), U1.26 (OUTW)
RS-A: J2.2, J3.2, U2.6 (B)
RS-B: J2.1, J3.1, U2.7 (A)
RX: U1.40 (PB7), U2.1 (RO)
SCK: J4.4, J7.4, U1.16 (PA5), U3.12 (SCLK)
SWDCLK: J1.4, J5.4, U1.38 (SWDCLK)
SWDIO: J1.2, J5.2, U1.37 (SWDIO)
TX: U1.39 (PB6), U2.4 (DI)
VM: C3.1, D4.1 (K), U1.8 (VM)

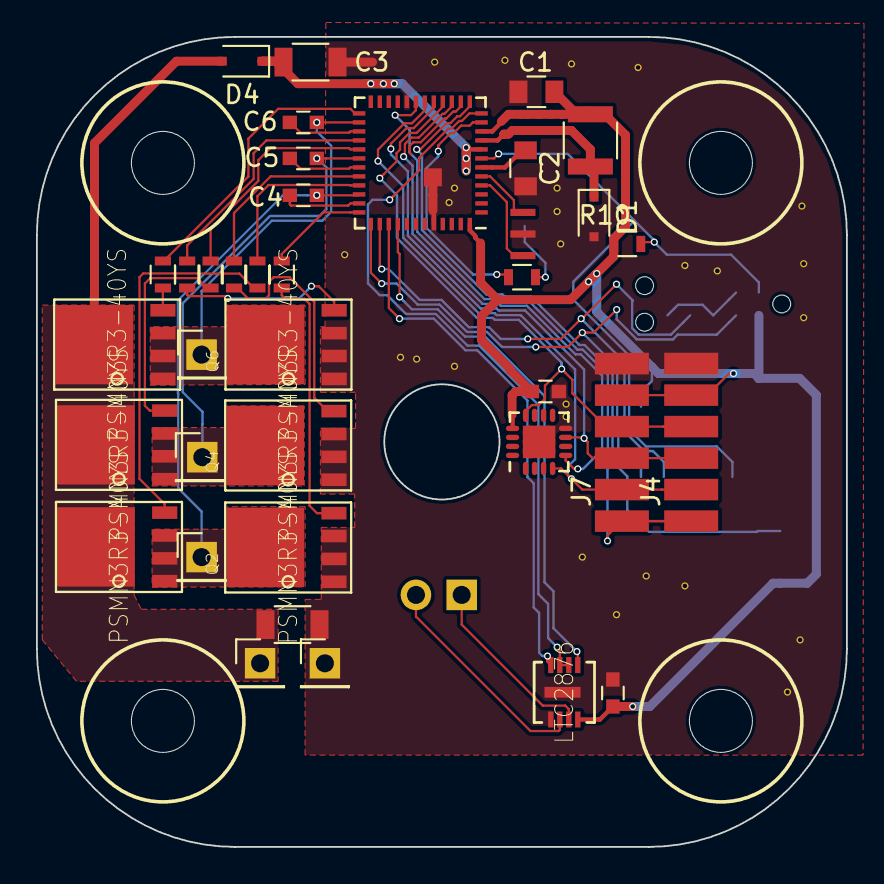
[picture p125: board Electronics/Motor/Schematic-Board/motor.kicad_pcb from above]

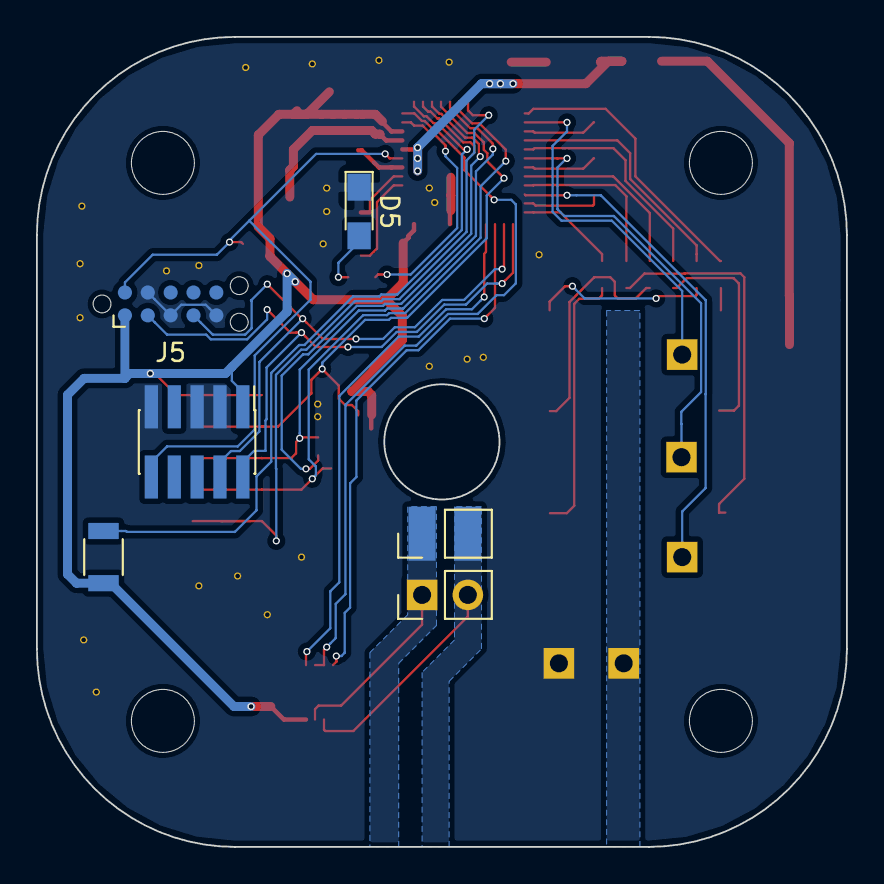
[picture p126: board Electronics/Motor/Schematic-Board/motor.kicad_pcb from below]

Board: 2 copper layers, 45.0 x 45.0 mm, 43 parts (6 on the bottom side), 42 nets.
