mkramar/dizzyrobot/Electronics/Motor/Schematic-Sensor B/sensor B.kicad_pcb

## KiCad design Electronics/Motor/Schematic-Sensor B/sensor B.kicad_pcb (2019-01-02)

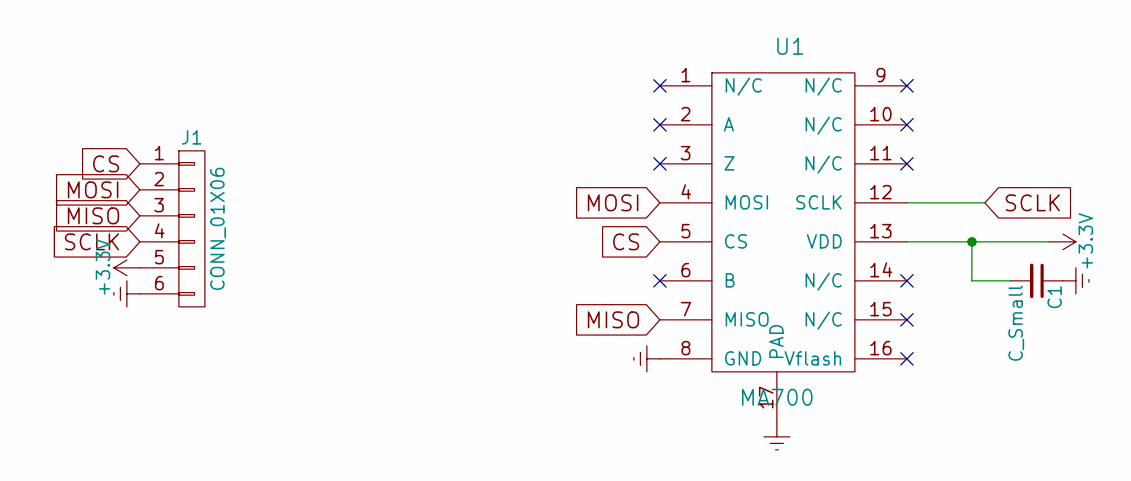
[picture p127: schematic sensor B.sch]

Parts:
C1: C_Small; C_0603
J1: CONN_01X06; SPI_CONN
U1: MA700; QFN-16-1EP_3x3mm_Pitch0.5mm

Connections:
+3V3: C1.2, J1.5, U1.13 (VDD)
CS: J1.1, U1.5 (CS)
Earth: C1.1, J1.6, U1.8 (GND), U1.17 (PAD)
MISO: J1.3, U1.7 (MISO)
MOSI: J1.2, U1.4 (MOSI)
SCLK: J1.4, U1.12 (SCLK)

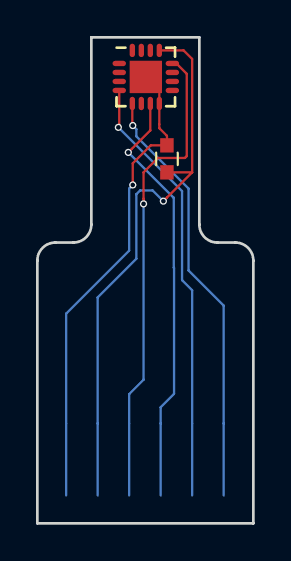
[picture p128: board sensor B.kicad_pcb from above]

Board: 2 copper layers, 12.0 x 27.0 mm, 3 parts (1 on the bottom side), 6 nets.
