mkramar/dizzyrobot/Schamatic/Motor - 2/motor.kicad_pcb

## KiCad design Schamatic/Motor - 2/motor.kicad_pcb (2018-08-18)

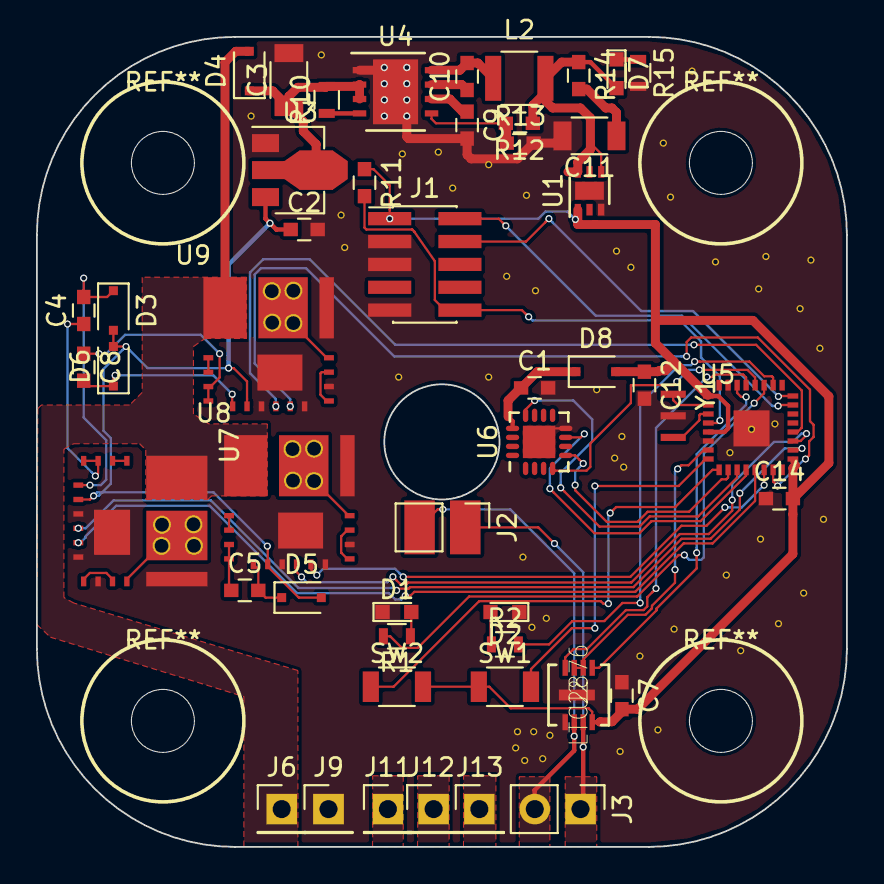
[picture p129: board Schamatic/Motor - 2/motor.kicad_pcb from above]

Board: 2 copper layers, 45.0 x 45.0 mm, 49 parts (0 on the bottom side), 55 nets.

Parts:
C1, C7, C12, C14: 0.1uF; C_0603
C2, C4, C5, C8, C9: 1uF; C_0603
C3: 2uF; C_1206
C10: 0.01uF; C_0603
C11: 4.7uF; C_1206
D1, D2, D7: LED_Small; LED_0603
D3, D5, D6, D8: D_Small; D_SOD-323F
D4: D; D_SOD-323F
J1: CONN_02X05; Pin_Header_Straight_2x05_Pitch1.27mm_SMD
J2, J3: RS485; Pin_Header_Straight_1x02_Pitch2.54mm
J6: +BAT; Pin_Header_Straight_1x01_Pitch2.54mm
J9: GND; Pin_Header_Straight_1x01_Pitch2.54mm
J11: V; Pin_Header_Straight_1x01_Pitch2.54mm
J12: U; Pin_Header_Straight_1x01_Pitch2.54mm
J13: W; Pin_Header_Straight_1x01_Pitch2.54mm
L2: 220uH; L_1210
R1, R2: 390; R_0603
R10: 237K; R_0603
R11: 10K; C_0603
R12: 30k 1%; C_0603
R13: 10K 1%; C_0603
R14: 1Ohm; C_0603
R15: 600; R_0603
SW1, SW2: B3U-1000P; R_1206
U1: TPS73433DRV; DFN-6-1EP_2x2mm_Pitch0.65mm
U2: LTC2876
U3: ZXTR2012Z; SOT-89-3
U4: LM5019; DFN-8-1EP_4x4mm_Pitch0.8mm
U5: STM32F031K6U6; UFQFPN32-small-pad
U6: MA700; QFN-16-1EP_3x3mm_Pitch0.5mm
U7, U8, U9: IRSM005
Y1: 8MhZ; Oscillator

Connections:
12V: C2.1, D3.2, D5.2, D6.2, U3.3, U7.2, U8.2, U9.2
+3V3: C7.2, C12.1, C14.2, D8.2, J1.1, R11.1, SW1.1, SW2.2, U1.1, U2.8, U5.1, U5.5, U5.17
+BATT: D4.2, J6.1, U7.13, U8.13, U9.13
CS: U5.10, U6.5
DE: U2.2, U2.3, U5.7
Earth: C1.2, C2.2, C3.2, C7.1, C9.2, C11.2, C12.2, C14.1, D1.1, D2.1, J1.3, J1.5, J1.9, J9.1, R13.2, R15.2, U1.3, U1.7, U2.5, U2.9, U3.1, U4.1, U4.9, U5.6, U5.31, U5.33, U6.8, U6.17, U7.3, U7.6, U7.8, U7.11, U7.28, U8.3, U8.6, U8.8, U8.11, U8.28, U9.3, U9.6, U9.8, U9.11, U9.28, Y1.2
HIN1: U5.18, U7.4
HIN2: U5.19, U8.4
HIN3: U5.20, U9.4
LIN1: U5.13, U7.5
LIN2: U5.14, U8.5
LIN3: U5.15, U9.5
MISO: U5.12, U6.7
MOSI: U5.28, U6.4
NRST: J1.10, R11.2, U5.4
unnamed: C1.1, D8.1, U6.13
unnamed: C3.1, D4.1, R10.2, U3.2, U4.2, U4.3
unnamed: C4.1, U7.26, U7.27
unnamed: C4.2, D3.1, U7.1
unnamed: C5.1, U8.26, U8.27
unnamed: C5.2, D5.1, U8.1
unnamed: C8.1, U9.26, U9.27
unnamed: C8.2, D6.1, U9.1
unnamed: C9.1, U4.6
unnamed: C10.1, U4.7
unnamed: C10.2, L2.1, U4.8
unnamed: C11.1, R14.2
unnamed: D1.2, R1.1
unnamed: D2.2, R2.1
unnamed: D7.1, R15.1
unnamed: D7.2, L2.2, R12.1, R14.1, U1.4, U1.6
unnamed: J11.1, U7.10, U7.12
unnamed: J12.1, U8.10, U8.12
unnamed: J13.1, U9.10, U9.12
unnamed: R1.2, U5.27
unnamed: R2.2, U5.26
unnamed: R10.1, U4.4
unnamed: R12.2, R13.1, U4.5
unnamed: SW1.2, U5.8
unnamed: SW2.1, U5.9
unnamed: U5.2, Y1.1
unnamed: U5.3, Y1.3
unnamed: U7.7, U7.9
unnamed: U7.24, U7.25
unnamed: U8.7, U8.9
unnamed: U8.24, U8.25
unnamed: U9.7, U9.9
unnamed: U9.24, U9.25
RS-A: J2.2, J3.2, U2.6
RS-B: J2.1, J3.1, U2.7
RX: U2.1, U5.30
SCK: U5.11, U6.12
SWDCLK: J1.4, U5.24
SWDIO: J1.2, U5.23
TX: U2.4, U5.29
