mkramar/dizzyrobot/Schamatic/PiHat/PiHat.kicad_pcb

## KiCad design Schamatic/PiHat/PiHat.kicad_pcb (2018-04-24)

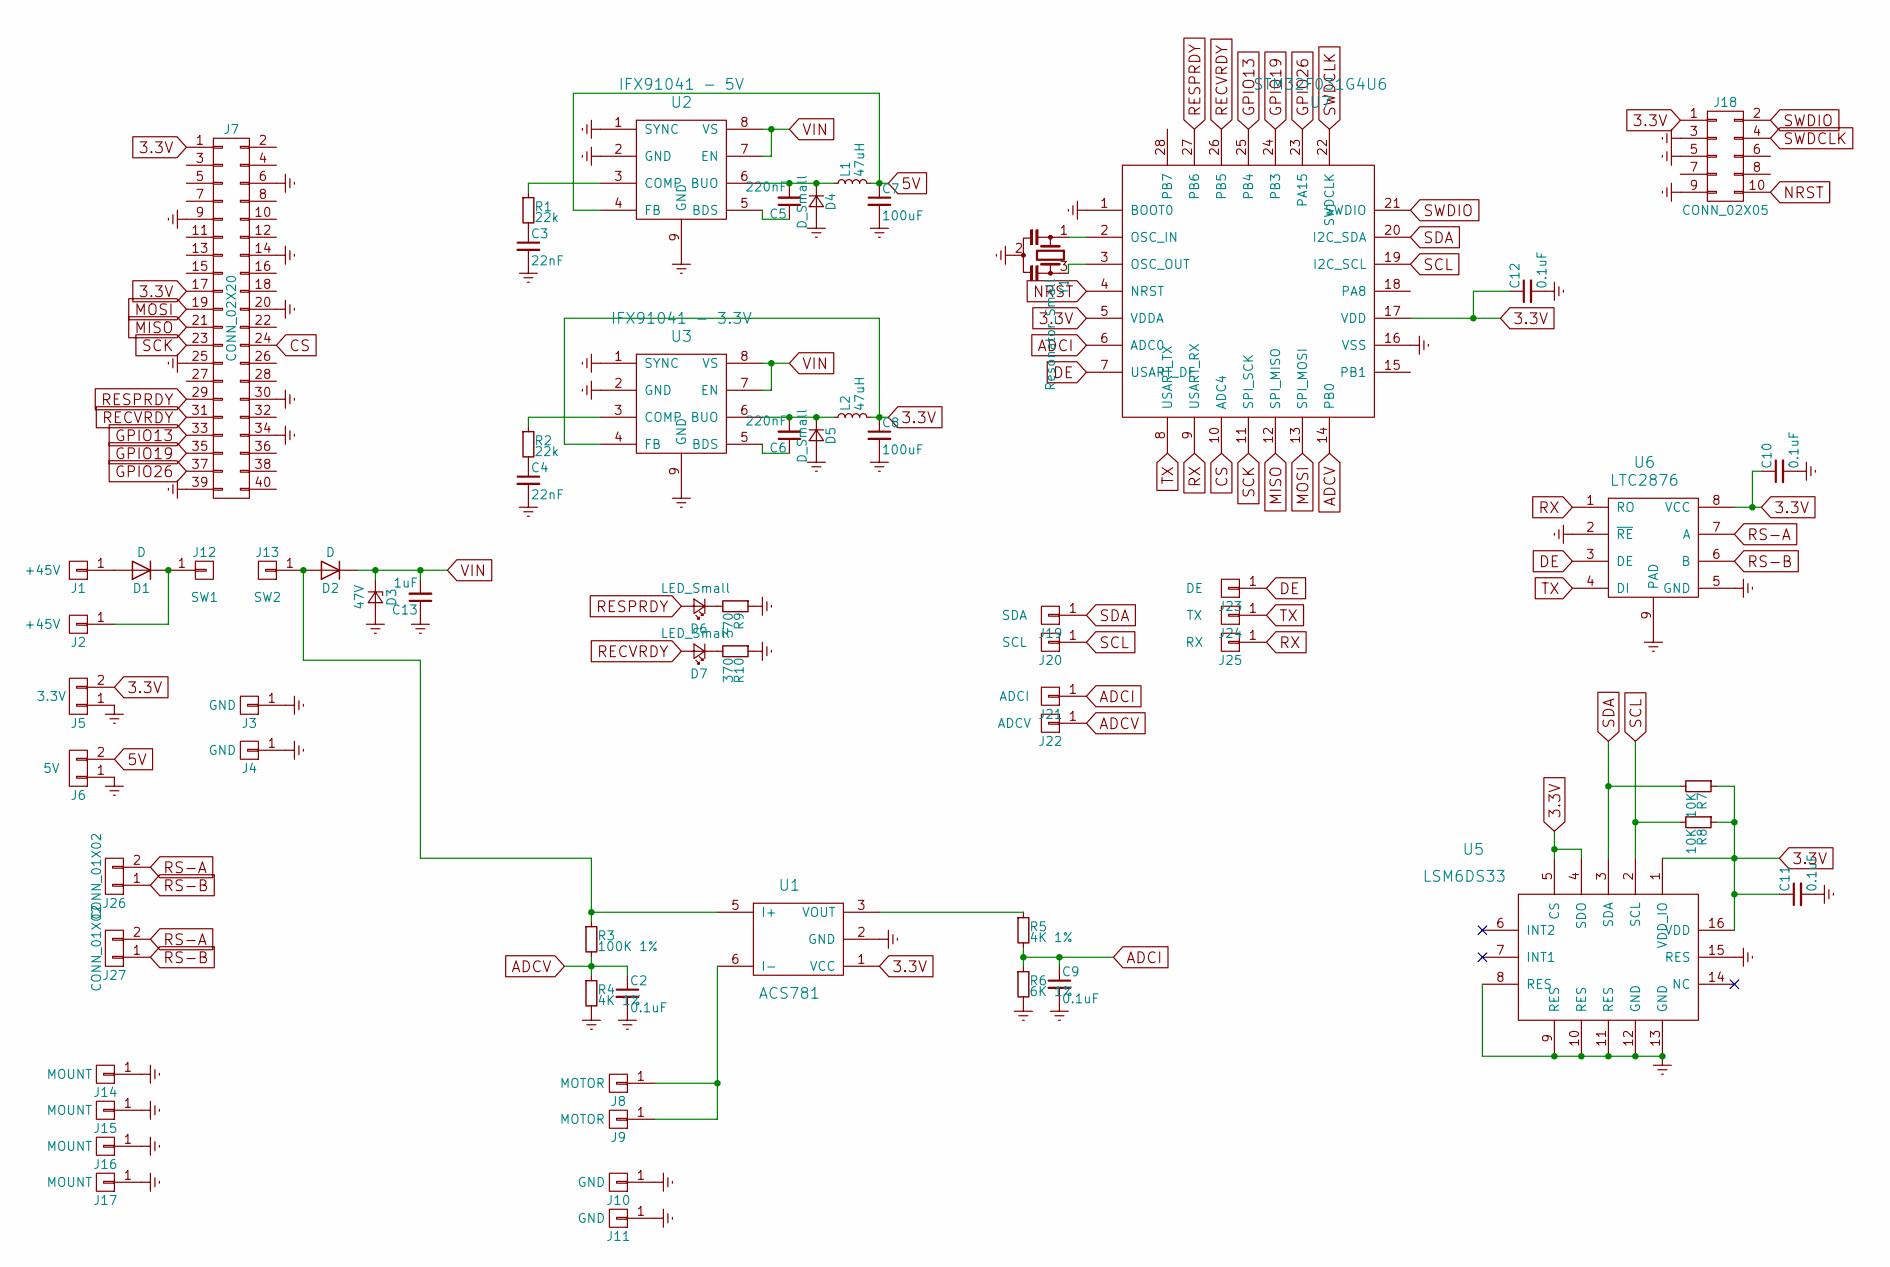
[picture p130: schematic PiHat.sch]

Parts:
C2, C9, C10, C11, C12: 0.1uF; C_0603
C3, C4: 22nF; C_0603
C5, C6: 220nF; C_0603
C7, C8: 100uF; C_1206
C13: 1uF; C_1206
D1: D; D_SMA
D2: D; D_SOD-323F
D3: 47V; D_SOD-123F
D4, D5: D_Small; D_SOD-323
D6, D7: LED_Small; LED_0603
J1, J2: +45V; 1pin
J3, J4, J10, J11: GND; 1pin
J5: 3.3V; Pin_Header_Straight_1x02_Pitch2.54mm
J6: 5V; Pin_Header_Straight_1x02_Pitch2.54mm
J7: CONN_02X20; Pin_Header_Straight_2x20_Pitch2.54mm
J8, J9: MOTOR; 1pin
J12: SW1; 1pin
J13: SW2; 1pin
J14, J15, J16, J17: MOUNT; 1pin
J18: CONN_02X05; Pin_Header_Straight_2x05_Pitch1.27mm
J19: SDA; 1pin
J20: SCL; 1pin
J21: ADCI; 1pin
J22: ADCV; 1pin
J23: DE; 1pin
J24: TX; 1pin
J25: RX; 1pin
J26, J27: CONN_01X02; Pin_Header_Straight_2x01_Pitch2.54mm
L1, L2: 47uH; Inductor-1812
R1, R2: 22k; R_0603
R3: 100K 1%; R_0603
R4, R5: 4K 1%; R_0603
R6: 6K 1%; R_0603
R7, R8: 10K; R_0603
R9, R10: 370; R_0603
U1: ACS781
U2: IFX91041 - 5V; HTSOP-8-1EP_3.9x4.9mm_Pitch1.27mm_ThermalVias
U3: IFX91041 - 3.3V; HTSOP-8-1EP_3.9x4.9mm_Pitch1.27mm_ThermalVias
U5: LSM6DS33; LGA16R50P3X5_300X300X100
U6: LTC2876
U7: STM32F031G4U6
Y1: Resonator_Small; Oscillator

Connections:
3.3V: C8.1, C10.1, C11.1, C12.1, J5.2, J7.1, J7.17, J18.1, L2.2, R7.1, R8.1, U1.1 (VCC), U3.4 (FB), U5.1 (VDD_IO), U5.4 (SDO), U5.5 (CS), U5.16 (VDD), U6.8 (VCC), U7.5 (VDDA), U7.17 (VDD)
5V: C7.1, J6.2, L1.2, U2.4 (FB)
ADCI: C9.1, J21.1, R5.2, R6.1, U7.6 (ADC0)
ADCV: C2.1, J22.1, R3.2, R4.1, U7.14 (PB0)
CS: J7.24, U7.10 (ADC4)
DE: J23.1, U6.3 (DE), U7.7 (USART_DE)
Earth: C2.2, C3.2, C4.2, C7.2, C8.2, C9.2, C10.2, C11.2, C12.2, C13.1, D3.2 (A), D4.2 (A), D5.2 (A), J3.1, J4.1, J5.1, J6.1, J7.6, J7.9, J7.14, J7.20, J7.25, J7.30, J7.34, J7.39, J10.1, J11.1, J14.1, J15.1, J16.1, J17.1, J18.3, J18.5, J18.9, R4.2, R6.2, R9.1, R10.1, U1.2 (GND), U2.1 (SYNC), U2.2 (GND), U2.9 (GND), U3.1 (SYNC), U3.2 (GND), U3.9 (GND), U5.8 (RES), U5.9 (RES), U5.10 (RES), U5.11 (RES), U5.12 (GND), U5.13 (GND), U5.15 (RES), U6.2 (~RE), U6.5 (GND), U6.9 (PAD), U7.1 (BOOT0), U7.16 (VSS), Y1.2
GPIO13: J7.33, U7.25 (PB4)
GPIO19: J7.35, U7.24 (PB3)
GPIO26: J7.37, U7.23 (PA15)
MISO: J7.21, U7.12 (SPI_MISO)
MOSI: J7.19, U7.13 (SPI_MOSI)
NRST: J18.10, U7.4 (NRST)
unnamed: C3.1, R1.2
unnamed: C4.1, R2.2
unnamed: C5.1, U2.5 (BDS)
unnamed: C5.2, D4.1 (K), L1.1, U2.6 (BUO)
unnamed: C6.1, U3.5 (BDS)
unnamed: C6.2, D5.1 (K), L2.1, U3.6 (BUO)
unnamed: D1.1 (K), J2.1, J12.1
unnamed: D1.2 (A), J1.1
unnamed: D2.2 (A), J13.1, R3.1, U1.5 (I+)
unnamed: D6.1 (K), R9.2
unnamed: D7.1 (K), R10.2
unnamed: J8.1, J9.1, U1.6 (I-)
unnamed: R1.1, U2.3 (COMP)
unnamed: R2.1, U3.3 (COMP)
unnamed: R5.1, U1.3 (VOUT)
unnamed: U7.2 (OSC_IN), Y1.1
unnamed: U7.3 (OSC_OUT), Y1.3
RECVRDY: D7.2 (A), J7.31, U7.26 (PB5)
RESPRDY: D6.2 (A), J7.29, U7.27 (PB6)
RS-A: J26.2, J27.2, U6.7 (A)
RS-B: J26.1, J27.1, U6.6 (B)
RX: J25.1, U6.1 (RO), U7.9 (USART_RX)
SCK: J7.23, U7.11 (SPI_SCK)
SCL: J20.1, R8.2, U5.2 (SCL), U7.19 (I2C_SCL)
SDA: J19.1, R7.2, U5.3 (SDA), U7.20 (I2C_SDA)
SWDCLK: J18.4, U7.22 (SWDCLK)
SWDIO: J18.2, U7.21 (SWDIO)
TX: J24.1, U6.4 (DI), U7.8 (USART_TX)
VIN: C13.2, D2.1 (K), D3.1 (K), U2.7 (EN), U2.8 (VS), U3.7 (EN), U3.8 (VS)

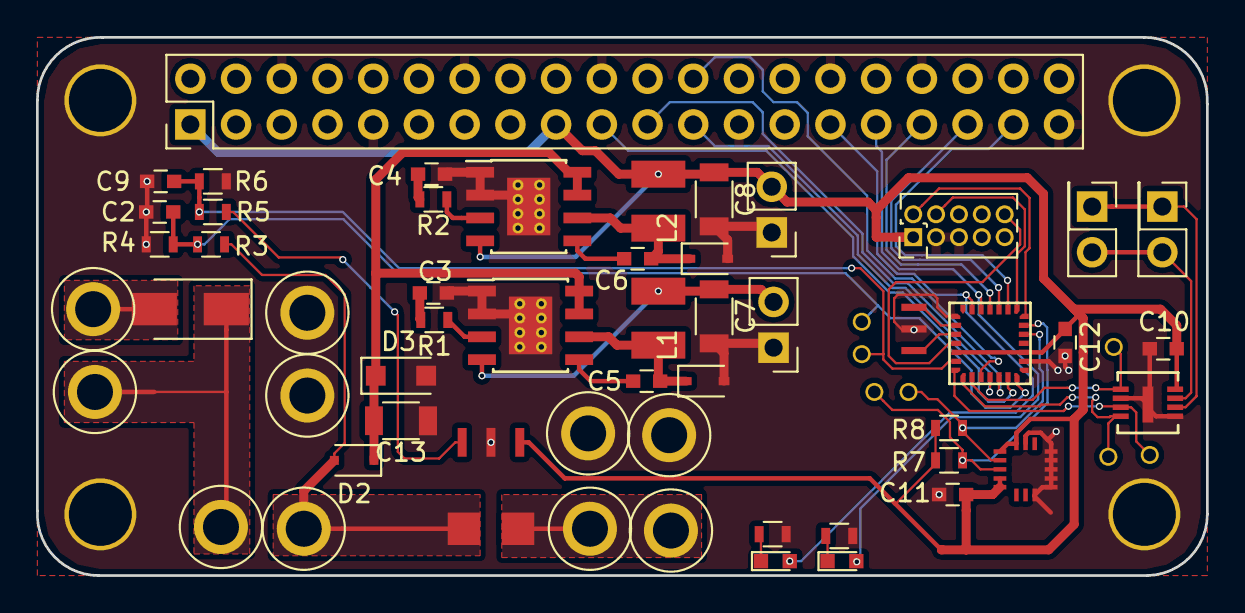
[picture p131: board PiHat.kicad_pcb from above]

Board: 2 copper layers, 65.0 x 29.9 mm, 65 parts (0 on the bottom side), 42 nets.
