mkramar/dizzyrobot/Schamatic/Sensor-Infineon/Sensor.kicad_pcb

## KiCad design Schamatic/Sensor-Infineon/Sensor.kicad_pcb (2017-11-12)

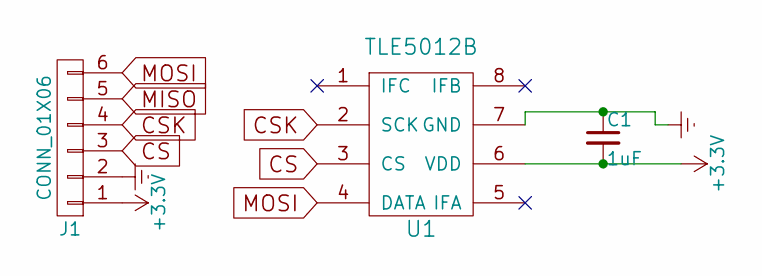
[picture p132: schematic Sensor.sch]

Parts:
C1: 1uF; C_0805
J1: CONN_01X06; SPI_CONN
U1: TLE5012B; SOIC-8_3.9x4.9mm_Pitch1.27mm

Connections:
+3V3: C1.2, J1.1, U1.6 (VDD)
CS: J1.3, U1.3 (CS)
CSK: J1.4, U1.2 (SCK)
Earth: C1.1, J1.2, U1.7 (GND)
MISO: J1.5
MOSI: J1.6, U1.4 (DATA)

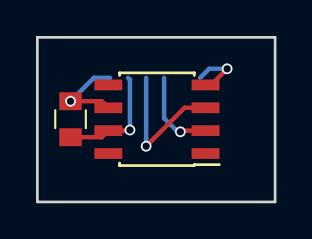
[picture p133: board Schamatic/Sensor-Infineon/Sensor.kicad_pcb from above]

Board: 2 copper layers, 13.2 x 9.1 mm, 3 parts (1 on the bottom side), 5 nets.
