mkramar/dizzyrobot/Schamatic/Sensor-MPS/Sensor.kicad_pcb

## KiCad design Schamatic/Sensor-MPS/Sensor.kicad_pcb (2017-10-01)

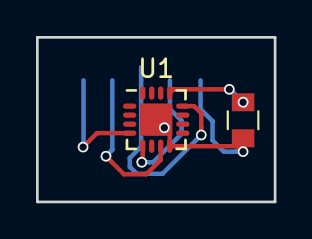
[picture p134: board Schamatic/Sensor-MPS/Sensor.kicad_pcb from above]

Board: 2 copper layers, 13.2 x 9.1 mm, 3 parts (1 on the bottom side), 6 nets.

Parts:
C1: 1uF; C_0805
J1: CONN_01X06; SPI_cable
U1: MA700; QFN-16-1EP_3x3mm_Pitch0.5mm

Connections:
+3V3: C1.1, J1.6, U1.13
CS: J1.4, U1.5
CSK: J1.3, U1.12
Earth: C1.2, J1.5, U1.8, U1.17
MISO: J1.2, U1.7
MOSI: J1.1, U1.4
