mkramar/dizzyrobot/Schamatic/Motor - 2/motor-2.kicad_pcb

## KiCad design Schamatic/Motor - 2/motor-2.kicad_pcb (2018-06-11)

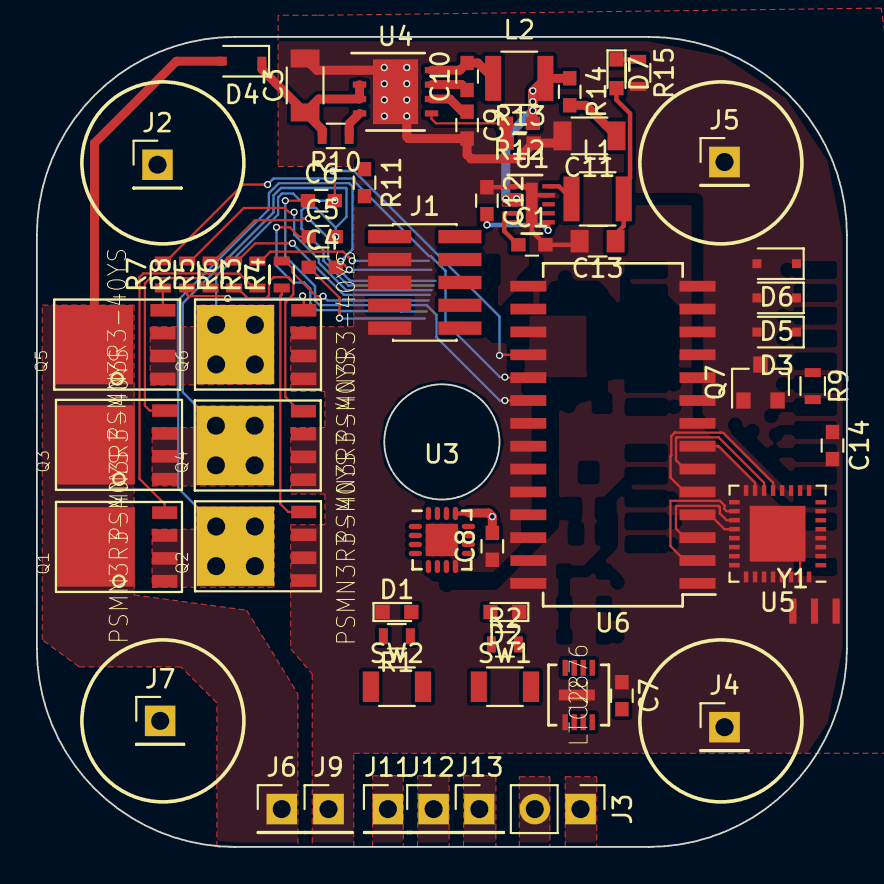
[picture p135: board motor-2.kicad_pcb from above]

Board: 2 copper layers, 45.0 x 45.0 mm, 64 parts (0 on the bottom side), 64 nets.

Parts:
C1, C4, C5, C6, C9: 1uF; C_0603
C3: 2uF; C_1206
C7, C8, C14: 0.1uF; C_0603
C10: 0.01uF; C_0603
C11: 4.7uF; C_1206
C12: 3300pF; C_0603
C13: 22uF; C_0805
D1, D2, D7: LED_Small; LED_0603
D3, D5, D6: D_Small; D_SOD-323F
D4: D; D_SOD-323F
J1: CONN_02X05; Pin_Header_Straight_2x05_Pitch1.27mm_SMD
J2, J4, J5, J7: MOUNT; Pin_Header_Straight_1x01_Pitch2.54mm
J3: RS485; Pin_Header_Straight_1x02_Pitch2.54mm
J6: +BAT; Pin_Header_Straight_1x01_Pitch2.54mm
J9: GND; Pin_Header_Straight_1x01_Pitch2.54mm
J11: V; Pin_Header_Straight_1x01_Pitch2.54mm
J12: U; Pin_Header_Straight_1x01_Pitch2.54mm
J13: W; Pin_Header_Straight_1x01_Pitch2.54mm
L1: 15uH; L_1210
L2: 220uH; L_1210
Q1, Q3, Q5: PSMN3R3-40YS
Q2, Q4, Q6: PSMN3R3-40YS; PSMN3R3-40YS-vias
Q7: NTR5103N; SOT-23
R1, R2, R15: 390; R_0603
R3, R4, R5, R6, R7, R8: 10; R_0603
R9: 100K; R_0603
R10: 237K; R_0603
R11, R13: 10K; C_0603
R12: 230K; C_0603
R14: 1Ohm; C_0603
SW1, SW2: B3U-1000P; R_1206
U1: MAX17502; DFN-10-1EP_2x3mm_Pitch0.5mm
U2: LTC2876
U3: MA700; QFN-16-1EP_3x3mm_Pitch0.5mm
U4: LM5019; DFN-8-1EP_4x4mm_Pitch0.8mm
U5: STM32F031G6U6; WQFN-32-1EP_5x5mm_Pitch0.5mm
U6: AUIRS20302; SOIC-28W_7.5x18.7mm_Pitch1.27mm
Y1: 8MhZ; Oscillator

Connections:
+3V3: C7.2, C8.2, C13.1, C14.2, D7.2, J1.1, L1.2, R11.1, SW1.1, SW2.2, U1.5, U2.8, U3.13, U5.1, U5.5, U5.17, U6.17
+24V: L2.2, Q7.3, R9.1, R12.1, R14.1, U1.2, U1.3
+BATT: D4.2, J6.1, Q1.5678, Q3.5678, Q5.5678
BOOT1: C4.1, D3.1, U6.26
BOOT2: C5.1, D5.1, U6.23
BOOT3: C6.1, D6.1, U6.20
CS: U3.5, U5.10
DE: U2.2, U2.3, U5.7
EN: U5.21, U6.1
Earth: C1.2, C3.2, C7.1, C8.1, C9.2, C11.2, C12.1, C13.2, C14.1, D1.1, D2.1, J1.3, J1.5, J1.9, J2.1, J4.1, J5.1, J7.1, J9.1, Q2.1, Q2.2, Q2.3, Q4.1, Q4.2, Q4.3, Q6.1, Q6.2, Q6.3, R13.2, R15.2, U1.1, U1.9, U1.11, U2.5, U2.9, U3.8, U3.17, U4.1, U4.9, U5.31, U5.33, U6.8, U6.14, U6.16, Y1.2
FLT: U5.25, U6.27
FRST: U5.22, U6.28
H1: R3.2, U6.25
H2: R5.2, U6.22
H3: R7.2, U6.19
HIN1: U5.18, U6.2
HIN2: U5.19, U6.3
HIN3: U5.20, U6.4
L1: R4.2, U6.11
L2: R6.2, U6.12
L3: R8.2, U6.13
LIN1: U5.13, U6.5
LIN2: U5.14, U6.6
LIN3: U5.15, U6.7
MISO: U3.7, U5.12
MOSI: U3.4, U5.28
NRST: J1.10, R11.2, U5.4
unnamed: C1.1, U1.4
unnamed: C3.1, D4.1, R10.2, U4.2, U4.3
unnamed: C9.1, U4.6
unnamed: C10.1, U4.7
unnamed: C10.2, L2.1, U4.8
unnamed: C11.1, R14.2
unnamed: C12.2, U1.6
unnamed: D1.2, R1.1
unnamed: D2.2, R2.1
unnamed: D3.2, D5.2, D6.2, Q7.2, U6.10
unnamed: D7.1, R15.1
unnamed: L1.1, U1.10
unnamed: Q1.4, R3.1
unnamed: Q2.4, R4.1
unnamed: Q3.4, R5.1
unnamed: Q4.4, R6.1
unnamed: Q5.4, R7.1
unnamed: Q6.4, R8.1
unnamed: R1.2, U5.27
unnamed: R2.2, U5.26
unnamed: R10.1, U4.4
unnamed: R12.2, R13.1, U4.5
unnamed: SW1.2, U5.8
unnamed: SW2.1, U5.9
unnamed: U5.2, Y1.1
unnamed: U5.3, Y1.3
O1: C4.2, J11.1, Q1.1, Q1.2, Q1.3, Q2.5678, U6.24
O2: C5.2, J12.1, Q3.1, Q3.2, Q3.3, Q4.5678, U6.21
O3: C6.2, J13.1, Q5.1, Q5.2, Q5.3, Q6.5678, U6.18
RS-A: J3.2, U2.6
RS-B: J3.1, U2.7
RX: U2.1, U5.30
SCK: U3.12, U5.11
SWDCLK: J1.4, U5.24
SWDIO: J1.2, U5.23
TX: U2.4, U5.29
VCP: Q7.1, R9.2, U6.9
