mkramar/dizzyrobot/Electronics/Mainboard/Firmware/Code/main.cpp

/* Includes ------------------------------------------------------------------*/
#include "main.h"
#include "stm32f0xx_hal.h"
#include "adc.h"
#include "dma.h"
#include "gyro.h"
#include "spi.h"
#include "usart.h"
#include "gpio.h"
#include "clock.h"

extern __IO uint32_t uwTick;

//#define PARSE_ERROR		0
//#define PARSE_OK		1
//#define PARSE_END		2

volatile char spiInBuffer[spiBufferSize] = { 0 };
volatile char spiOutBuffer[spiBufferSize] = { 0 };

volatile char usartInBuffer[usartBufferSize] = { 0 };
volatile char usartOutBuffer[usartBufferSize] = { 0 };

volatile char* inp;
volatile char* outp;

#define STATE_INITIAL	0
#define STATE_RECEIVING	1
#define STATE_RESPONDING	2

int state = STATE_INITIAL;
bool flagSpiFrameReceived = false;
void ProcessIncoming();
void ProcessGyro();
void ProcessAdc();

int main(void)
{
	HAL_Init();

	SystemClock_Config();

	MX_GPIO_Init();
	MX_DMA_Init();
	initGiro();
	MX_SPI1_Init();
	MX_USART1_UART_Init();
	initAdc();

//	GPIOB->BRR |= PIN_READY_TO_RESPOND;					// clear respond flag
//	GPIOB->BSRR |= PIN_READY_TO_RECEIVE;				// raize receive flag
	
	//BlockingSpiRead();
	//ScheduleSpiDmaRead();
	//state = STATE_RECEIVING;
	
	while (1)
	{
		GPIOB->BRR |= PIN_READY_TO_RESPOND;					// clear respond flag
		GPIOB->BSRR |= PIN_READY_TO_RECEIVE;				// raize receive flag
	
		SpiBlockingRead();									// read from master
		
		GPIOB->BRR |= PIN_READY_TO_RESPOND;					// off both LEDs
		GPIOB->BRR |= PIN_READY_TO_RECEIVE;
			
		ProcessIncoming();
		ProcessGyro();
		ProcessAdc();
		
		GPIOB->BRR |= PIN_READY_TO_RECEIVE;					// clear receive flag
		GPIOB->BSRR |= PIN_READY_TO_RESPOND;				// raize respond flag
		
		SpiBlockingWrite(outp - spiOutBuffer);				// write to master
		SpiFlushBuffers();
		
		// check status of ADC on each loop
		// if conversion is ready, save it in either current or voltage variable
		readAdc();
	}
}

void Output(const char *src){
	while (*src && (outp - spiOutBuffer) < spiBufferSize)
	{
		*outp++ = *src++;
	}
}
void OutputUsartLine() {
	const char *p = (const char*)usartInBuffer;
	char ch;
	do {
		*outp++ = ch = *p++;
	} while (ch && ch != '\n' && (p - usartInBuffer) < usartBufferSize && (outp - spiOutBuffer) < spiBufferSize);
}
void WriteByte(uint8_t value) {
	uint8_t b1 = (value >> 4) & 0x0F;
	uint8_t b2 = value & 0x0F;
	
	if (b1 <= 9) *outp++ = '0' + b1;
	else *outp++ = '7' + b1;
	
	if (b2 <= 9) *outp++ = '0' + b2;
	else *outp++ = '7' + b2;
}
void WriteShort(uint16_t value) {
	WriteByte((uint8_t)(value >> 8));
	WriteByte((uint8_t)(value & 0xFF));
}
bool ReadByte(uint8_t* output) {
	uint8_t b1;
	uint8_t b2;
	
	*output = 0;
	
	if (*inp >= '0' && *inp <= '9') b1 = *inp - '0';
	else if (*inp >= 'A' && *inp <= 'F') b1 = *inp - '7';
	else if (*inp >= 'a' && *inp <= 'f') b1 = *inp - 'a';
	else return false;
	
	inp++;
		
	if (*inp >= '0' && *inp <= '9') b2 = *inp - '0';
	else if (*inp >= 'A' && *inp <= 'F') b2 = *inp - '7';
	else if (*inp >= 'a' && *inp <= 'f') b2 = *inp - 'a';
	else return false;
	
	inp++;

	*output = (b1 << 4) | b2;
	return true;
}
void ToEndOfLine(){
	while (*inp && *inp != '\r' && *inp != '\n' && (inp - spiInBuffer < spiBufferSize)) inp++;
}

void UsartTransaction(uint32_t length) {
	for (int i = 0; i < usartBufferSize; i++) usartInBuffer[i] = 0;

	USART1->CR1 |= USART_CR1_TE;							// enable transmitter
	USART1->CR1 |= USART_CR1_RE;							// enable receiver
	USART1->CR1 |= USART_CR1_UE;							// enable usart	
	USART1->ICR |= USART_ICR_CMCF;							// clear CMF flag bit
	USART1->ICR |= USART_ICR_TCCF;							// clear transmission complete flag
	
	while ((USART1->ISR & USART_ISR_REACK) == 0) {}			// wait for receiver to enable
	while ((USART1->ISR & USART_ISR_TEACK) == 0) {}			// wait for transmitter to enable
	while ((USART1->ISR & USART_ISR_BUSY) != 0) {}			// wait for busy
	
	BlockingUsartWrite(length);
	bool success = BlockingUsartRead();
	
	if (success) OutputUsartLine();
	else Output("timeout\n");
	
	//USART1->CR1 &= ~USART_CR1_UE;							// disable usart
}

void ProcessIncoming() {
	inp = spiInBuffer;
	outp = spiOutBuffer;

	int col = 0;
	uint8_t b = 0;
	
	for (int i = 0; i < 10; i++)							// todo: why?! sometimes starts with zeros
	{
		if (*inp) break;
		inp++;
	}
	
	while (*inp && (inp - spiInBuffer < spiBufferSize) && (col < usartBufferSize - 1))
	{
		if (*inp == '\r') inp++;
		else usartOutBuffer[col++] = *inp++;
		
		if (*inp == '\n') 
		{
			usartOutBuffer[col++] = '\n';

			UsartTransaction(col);
			col = 0;
			
			continue;
		}		
	}
}
void ProcessGyro(){
	readGyro();
	
	for (int i = 0; i < 12; i++)
		WriteByte(gyroBuffer[i]);
	
	*outp++ = '\n';
}
void ProcessAdc(){
	WriteShort(adcCurrent);
	WriteShort(adcVoltage);
	
	*outp++ = '\n';
}

void _Error_Handler(const char * file, int line){
	while (1) 
	{
		asm("bkpt 255");
	}
}

#ifdef USE_FULL_ASSERT

/**
   * @brief Reports the name of the source file and the source line number
   * where the assert_param error has occurred.
   * @param file: pointer to the source file name
   * @param line: assert_param error line source number
   * @retval None
   */
void assert_failed(uint8_t* file, uint32_t line)
{
  /* USER CODE BEGIN 6 */
  /* User can add his own implementation to report the file name and line number,
    ex: printf("Wrong parameters value: file %s on line %d\r\n", file, line) */
  /* USER CODE END 6 */

}

#endif
