mkramar/dizzyrobot/Electronics/Mainboard/Firmware/Code/Inc/main.h

#ifndef __MAIN_H
#define __MAIN_H

#ifdef __cplusplus
 extern "C" {
#endif
	 
void _Error_Handler(const char *, int);

#define Error_Handler() _Error_Handler(__FILE__, __LINE__)

#ifdef __cplusplus
}
#endif

#endif /* __MAIN_H */
