mkramar/dizzyrobot/Electronics/Mainboard/Firmware/Code/Src/dma.cpp

#include "dma.h"

void MX_DMA_Init(void) 
{
  /* DMA controller clock enable */
  __HAL_RCC_DMA1_CLK_ENABLE();

  /* DMA interrupt init */
  /* DMA1_Channel2_3_IRQn interrupt configuration */
//  HAL_NVIC_SetPriority(DMA1_Channel2_3_IRQn, 0, 0);
//  HAL_NVIC_EnableIRQ(DMA1_Channel2_3_IRQn);
	
  /* DMA1_Channel4_5_IRQn interrupt configuration */
//  HAL_NVIC_SetPriority(DMA1_Channel4_5_IRQn, 0, 0);
//  HAL_NVIC_EnableIRQ(DMA1_Channel4_5_IRQn);
}
