mkramar/dizzyrobot/Electronics/Mainboard/Firmware/Code/Src/gpio.cpp

/* Includes ------------------------------------------------------------------*/
#include "gpio.h"

/** Pinout Configuration
*/
void MX_GPIO_Init(void)
{
	GPIO_InitTypeDef GPIO_InitStruct;

	  /* GPIO Ports Clock Enable */
	__HAL_RCC_GPIOF_CLK_ENABLE();
	__HAL_RCC_GPIOA_CLK_ENABLE();
	__HAL_RCC_GPIOB_CLK_ENABLE();

	  /*Configure GPIO pin Output Level */
	HAL_GPIO_WritePin(GPIOA, GPIO_PIN_15, GPIO_PIN_RESET);

	  /*Configure GPIO pin Output Level */
	HAL_GPIO_WritePin(GPIOB, GPIO_PIN_3 | GPIO_PIN_4 | GPIO_PIN_5 | GPIO_PIN_6, GPIO_PIN_RESET);

	  /*Configure GPIO pin : PA15 */
	GPIO_InitStruct.Pin = GPIO_PIN_15;
	GPIO_InitStruct.Mode = GPIO_MODE_OUTPUT_PP;
	GPIO_InitStruct.Pull = GPIO_NOPULL;
	GPIO_InitStruct.Speed = GPIO_SPEED_FREQ_LOW;
	HAL_GPIO_Init(GPIOA, &GPIO_InitStruct);

	  /*Configure GPIO pins : PB3 PB4 PB5 PB6 */
	GPIO_InitStruct.Pin = GPIO_PIN_3 | GPIO_PIN_4 | GPIO_PIN_5 | GPIO_PIN_6;
	GPIO_InitStruct.Mode = GPIO_MODE_OUTPUT_PP;
	GPIO_InitStruct.Pull = GPIO_NOPULL;
	GPIO_InitStruct.Speed = GPIO_SPEED_FREQ_LOW;
	HAL_GPIO_Init(GPIOB, &GPIO_InitStruct);
	
	//
	
  /*Configure GPIO pin : PA4 */
	GPIO_InitStruct.Pin = GPIO_PIN_4;
	GPIO_InitStruct.Mode = GPIO_MODE_IT_RISING;
	GPIO_InitStruct.Pull = GPIO_NOPULL;
	HAL_GPIO_Init(GPIOA, &GPIO_InitStruct);
	
	  /* EXTI interrupt init*/
	HAL_NVIC_SetPriority(EXTI4_15_IRQn, 0, 0);
	HAL_NVIC_EnableIRQ(EXTI4_15_IRQn);	
}
