mkramar/dizzyrobot/Electronics/Mainboard/Firmware/Code/Inc/clock.h

#ifndef __clock_H
#define __clock_H
#ifdef __cplusplus
 extern "C" {
#endif

/* Includes ------------------------------------------------------------------*/
#include "stm32f0xx_hal.h"
#include "main.h"

void SystemClock_Config(void);
	 
#ifdef __cplusplus
}
#endif
#endif /*__ clock_H */
