mkramar/dizzyrobot/(commit log)

2017-03-25 body/part0 joint
    [_sizes.scad, _view.scad, board-joint.scad, body.scad, main.scad, motorBlock.scad, part0.scad, part2.scad]
2017-03-27 part 2 and 3
    [_shared.scad, _sizes.scad, _view.scad, common12.scad, common23.scad, part1.scad, part2.scad, part3.print.scad]
2017-03-29 part 2 printing
    [_shared.scad, _sizes.scad, _view.scad, common12.scad, common23.scad, part1.scad, part2-1.stl, part2-2.stl]
2017-03-29 part 1 printing
    [_shared.scad, _sizes.scad, _view.scad, common01.scad, common12.scad, part1-print-1.scad, part1-print-2.scad, part1-print.scad]
2017-03-30 part0 printing
    [_shared.scad, _sizes.scad, _view.scad, body.scad, common01.scad, common12.scad, common23.scad, part0-print-1.scad]
2017-04-01 part 2 changes
    [_sizes.scad, _view.scad, assembly12.scad, assembly23.scad, common01.scad, common12.scad, common23.scad, part0-print.scad]
2017-04-07 body and part3 printing
    [_sizes.scad, _view.scad, assembly23.scad, assemblyB0.scad, body-print-1.scad, body-print-2.scad, body-print.scad, body.print-1.scad]
2017-04-08 part 3 added bearing
    [_view.scad, common23.scad, part2.scad, part3.print.scad, part3.scad]
2017-04-09 part 1 changes
    [_sizes.scad, _view.scad, assembly01.scad, common01.scad, common12.scad, part1-print-1.scad, part1-print-2.scad, part1-print.scad]
2017-04-17 starting brushless
    [_shared.scad, _sizes.scad, _view.scad, assembly01.scad, assembly12.scad, assembly23.scad, assemblyB0.scad, bearings.scad]
2017-04-20 printing heap
    [_shared.scad, _sizes.scad, bearingInner.scad, heap-1.scad, heap-2.scad, heap.scad, view.scad]
2017-04-20 bone 1
    [_shared.scad, _sizes.scad, bone1.scad, bone2.scad, heap.scad, view.scad]
2017-04-21 part1 printing
    [_shared.scad, _sizes.scad, bone1.scad, gimbal.scad, part1-print-1.scad, part1-print.scad, part1-print2.scad, part1.scad]
2017-04-25 motor pulley
    [_shared.scad, _sizes.scad, motorPulley1.scad, motorPulley2.scad, part1-print-1.scad, part1-print-2.scad, part1-print.scad, part1.scad]
2017-04-26 started part 2
    [_shared.scad, _sizes.scad, part1.scad, part2.scad, view.scad]
2017-04-26 attempting joint with aluminium rods
    [_sizes.scad, joint-test-print-1.scad, joint-test-print-2.scad, joint-test-print-3.scad, joint-test.scad, part1.scad, part2.scad, view.scad]
2017-04-29 knee joint
    [_shared.scad, _sizes.scad, joint-test.scad, knee-joint-print-1.scad, knee-joint-print-2.scad, knee-joint-print-3.scad, knee-joint-print-4.scad, knee-joint.scad]
2017-05-20 brushless and planetary tries
    [_shared.scad, _sizes.scad, bearing calibrate.scad, knee-joint-print.scad, knee-joint.scad, knee.scad, knee2.scad, motor.scad]
2017-05-20 started geared
    [_shared.scad, knee.scad, motor.scad, sizes.scad, view.scad]
2017-05-25 geared printing
    [knee.scad, print-knee-1.scad, print-knee-2.scad, print-knee-4.scad, print-knee-5.scad, print-knee.scad, view.scad]
2017-06-01 heap attempt
    [_shared.scad, _sizes.scad, axis.scad, heap.scad, knee-print-1.scad, knee-print-2.scad, knee-print-3.scad, knee-print.scad]
2017-06-05 started popa
    [_sizes.scad, axis-print-1.scad, axis-print-2.scad, axis-print-4.scad, axis-print-5.scad, axis-print.scad, axis.scad]
2017-06-14 organized axised
    [_shared.scad, axis-print-1.scad, axis.scad, bearing calibrate.scad, bearings.scad, body-print-1.scad, body-print-2.scad, body-print-3.scad]
2017-06-17 started enclosed
    [bearings.scad, body-print-2.scad, foot.scad, knee.scad, motor.scad, part1.scad, part2.scad, sizes.scad]
2017-06-18 print foot
    [foot-print-1.scad, foot-print-2.scad, foot-print.scad, foot.scad, part2.scad, sizes.scad, view.scad]
2017-07-14 heap joint holder
    [heap.scad, sizes.scad, thigh.scad, view.scad]
2017-07-31 board ordered
    [v3.kicad_pcb, v3.sch]
2017-07-31 started direct
    [_common.scad, body.scad, foot.scad, heap.scad, motor.scad, shin.scad, sizes.scad, thigh.scad]
2017-08-02 large plastic parts
    [body.scad, foot.scad, heap.scad, motor.scad, shin.scad, sizes.scad, thigh.scad]
2017-08-02 started thigh print
    [_common.scad, foot.scad, motor.scad, shin.scad, sizes.scad, thigh-print.scad, thigh.scad]
2017-08-06 shin printing
    [motor.scad, shin-print.scad, shin.scad, sizes.scad, thigh-print.scad, thigh.scad]
2017-08-23 started body and arms
    [_common.scad, arm.scad, body.scad, heap-print.scad, heap.scad, motor.scad, shoulder.scad, sizes.scad]
2017-09-02 first firmware for motor driver
    [Driver.sch, Power.sch, V2.kicad_pcb, V2.sch, _common.scad, _shared.scad, _sizes.scad, _view.scad]
2017-09-05 first spinning
    [Driver.sch, Power.sch, V2.kicad_pcb, V2.sch, elec.scad, heap-print.scad, motor.scad, shin-print.scad]
2017-09-18 started usart
    [motor-mold-1.scad, motor-mold-2.scad, motor-print.scad, motor.scad, thigh.scad]
2017-09-28 new version of controller
    [_v4.kicad_pcb, v3.sch, v4.1.kicad_pcb, v4.2.kicad_pcb, v4.kicad_pcb, v4.sch]
2017-10-01 ordered controller
    [Sensor.kicad_pcb, Sensor.sch, _v4.kicad_pcb, v4.1.kicad_pcb, v4.2.kicad_pcb, v4.kicad_pcb, v4.sch]
2017-10-03 body-heap joint
    [body-print.scad, body.scad, elec.scad, heap-print.scad, heap.scad, motor.scad, shoulder.scad, sizes.scad]
2017-10-08 foot printing
    [arm.scad, body-print-1.scad, body-print.scad, body.scad, foot-print-1.scad, foot-print-2.scad, foot-print.scad, foot.scad]
2017-10-13 thigh print in two parts
    [body-lower-print-1.scad, body-upper.scad, foot-print-1.scad, motor.scad, thigh-print-1.scad, thigh-print-2.scad, thigh-print.scad, thigh.scad]
2017-10-14 generalized cut
    [foot-print-1.scad, foot-print-2.scad, foot-print.scad, thigh-print-1.scad, thigh-print-2.scad, thigh-print.scad]
2017-10-17 button press and external clock
    [v4.kicad_pcb, v4.sch]
2017-10-23 spi comm
    [v4.sch]
2017-10-24 organized code into separate files
    [motor-print.scad, motor.scad]
2017-10-28 TYI-motor printing, started mainboard
    [Mainboard.kicad_pcb, Mainboard.sch, _saved_Mainboard.sch, motor-print-test-rotor.scad, motor-print-test-stator.scad, motor6-magnet-print.scad, motor6-tyi.scad, motor8-magnet-print.scad]
2017-10-31 constant torque turning
    [motor-print-test-stator.scad, motor6-assembly.scad, motor6-magnet-print.scad, motor6-tyi.scad, sizes.scad]
2017-11-03 shin print
    [foot-print-1.scad, foot-print-2.scad, foot-print.scad, foot.scad, motor.scad, motor6-tyi.scad, shin-print-1.scad, shin-print-2.scad]
2017-11-07 calibration saved in flash
2017-11-08 DE pin for USART
    [v4.sch]
2017-11-11 started layout
    [noname.kicad_pcb, v5.kicad_pcb, v5.sch]
2017-11-11 trying to improve calibration
2017-11-12 trace done
    [v5.kicad_pcb]
2017-11-12 new board version ready to order
    [Sensor.kicad_pcb, Sensor.sch, noname.kicad_pcb, v5.kicad_pcb, v5.sch]
2017-11-16 dont know what it is
    [body-lower.scad, body-upper.scad, elec.scad, heap-print.scad, motor6-tyi.scad, sizes.scad, thigh-print-1.scad, thigh-print-2.scad]
2017-11-22 saving before it goes too far...
    [assemblyTest.scad, framework.scad, moldMoldPrint.scad, moldMoldTest1.scad, part.scad, printTest.scad, thigh-mold-1.scad, thigh-mold-2.scad]
2017-11-22 started thigh mold
    [thigh-mold-1.scad, thigh-mold-2.scad, thigh-print-1.scad, thigh-print-2.scad, thigh-print.scad, thigh.scad]
2017-11-22 making progress on mold
    [thigh-mold-1.scad, thigh-mold-2.scad, thigh.scad]
2017-11-26 polishing mold framework
    [elec.scad, motor8.scad, shin-print.scad, thigh-mold-1.scad, thigh-mold-2.scad, thigh-print-1.scad, thigh.scad]
2017-11-27 mold framework cleanup
    [thigh-mold-1.scad, thigh-mold-2.scad, thigh-print-1.scad, thigh-print-2.scad, thigh.scad]
2017-11-28 cleanup shin printing
    [motor6-tyi.scad, shin-print-1.scad, shin-print-2.scad, shin-print.scad, shin.scad, thigh-print-1.scad, thigh.scad]
2017-12-03 interrupt-driver USART mold
    [assemblyTest.scad, body-lower.scad, body-upper.scad, moldMoldPrint-1.scad, moldMoldPrint-2.scad, moldMoldTest1.scad, part.scad, printTest.scad]
2017-12-06 DMA USART transmit
    [thigh-mold-1-box.scad]
2017-12-10 calibration looks good!
    [_saved_Mainboard.sch]
2017-12-12 new version of the board
    [v5.1.kicad_pcb, v5.sch]
2017-12-26 new calibration again!
    [v5.1.kicad_pcb]
2017-12-27 continue mainboard
    [Mainboard.sch]
2017-12-30 working on mainboard PCB
    [Mainboard.sch]
2017-12-31 started assigning footprints for motherboard
    [Mainboard.sch, test.scad]
2018-01-01 assigned all footprints for motherboard
    [Mainboard.kicad_pcb, Mainboard.sch]
2018-01-02 pushbutton switch
    [Mainboard.kicad_pcb, Mainboard.sch]
2018-01-03 continue motherboard
    [Mainboard.kicad_pcb, Mainboard.sch]
2018-01-05 Adding stripped version of simplelink sdk 1_50_00_06. Ignoring XDC package in this checkin.
    [build.cfg]
2018-01-05 mainboard pcb more or less complete
    [Mainboard.kicad_pcb]
2018-01-06 Switched TIRTOS with freertos with gcc project
    [build.cfg]
2018-01-07 motherboard minor changes
    [Mainboard.kicad_pcb, Mainboard.sch, test.scad]
2018-01-10 whatever motherboard changes
    [Mainboard.kicad_pcb, Mainboard.sch]
2018-01-10 added some PCB components
2018-01-11 Updated provisioning mode to AP. Also updated the latest uniflash project file. This update is after replacing FreeRTOS 10 with 9 which solves the problem of switching to AP mode through push button.
2018-01-11 Updated LED indications. In Rev A board,
    D10 - blinking means provisioning is in progress
    D10 - Solid OFF means some error
    D10 - Solid ON means provisioning is successful
    D9 - Solid ON means device is in Station mode
    D8 - Solid ON means device is in AP mode
2018-01-12 trying to make blinking indicators
    [Mainboard.kicad_pcb]
2018-01-12 both leds blink
2018-01-12 Renamed the core project folder to "host driver".
2018-01-15 button press and led blink
2018-01-17 Moved all files under motherboard.
    [build.cfg]
2018-01-19 motor PCB optimization
    [body-upper.scad, v5.1.kicad_pcb, v5.sch]
2018-01-24 minor corrections
    [Mainboard.sch, v5.1.kicad_pcb]
2018-01-27 SolidWorks 3D
    [Ass.SLDPRT, Assembly.SLDASM, CHCS M3x10 s.SLDPRT, Controller PCB.SLDPRT, Hip.SLDPRT, Magnet 3x3x3 mm.SLDPRT, Magnet plate M6.SLDPRT, Magnet plate M8.SLDPRT]
2018-01-27 motherboard corrections
    [Mainboard.kicad_pcb, Mainboard.sch]
2018-02-03 DMA + Interrupt working in blocking mode. Need to enable DMA in project config.
2018-02-04 Interrupt and DMA mode working after adding callback functions.
2018-02-08 removed old OpenScad 3D folder
    [_common.scad, arm.scad, assemblyTest.scad, body-lower-print-1.scad, body-lower-print.scad, body-lower.scad, body-upper.scad, elec.scad]
2018-02-08 cleanup motor schematic folder
    [motor.kicad_pcb, motor.sch, motor.xml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]
2018-02-08 logo in mask layer
    [Mainboard.kicad_pcb, motor.kicad_pcb]
2018-02-15 Both TX and TX working in DMA+Int mode. Enabled EOT interrupt and toggled RTS line based on that.
2018-02-15 Auto updated ccs files.
    [build.cfg]
2018-02-15 Added tirtos package to rebuild driver library in debug mode.
    [build.cfg]
2018-02-16 simple calibration
    [Ass cover lid.SLDPRT, Ass.SLDPRT, Assembly.SLDASM, Foot.SLDPRT, Hip.SLDPRT, Leg cables.SLDPRT, Magnet sensor subassembly M6.sldasm, Magnet sensor subassembly M8.sldasm]
2018-02-24 updated code to add call back for torque command. This is not tested on Target.
2018-02-24 Updated web pages to send torque command
2018-03-08 starting AS548 sensor
    [Box.sldprt, Cavity 1.sldprt, Cavity 2.sldprt, Hip mold tools.SLDPRT, Hip silicone mold assembly.SLDPRT, M6 front core.sldprt, M6 motor core.sldprt, Mold bottom.sldprt]
2018-03-11 Pi hat more or less ready
    [PiHat.kicad_pcb, PiHat.sch]
2018-03-22 accumulated changes
    [Ass M6xM6xM6.SLDPRT, Assembly.SLDASM, CHCS M3x10 s.SLDPRT, Controller PCB.SLDPRT, Foot.SLDPRT, Hip M9xM6.SLDPRT, Hip.SLDPRT, Motor 5.SLDPRT]
2018-03-27 fixes to the boards
    [Assembly.SLDASM, Foot.SLDPRT, Hip.SLDPRT, PiHat.kicad_pcb, PiHat.sch, Shin M9xM5.SLDPRT, motor.kicad_pcb, motor.sch]
2018-04-04 corrections on body lower part
    [Ass M6xM6xM6.SLDPRT, Assembly.SLDASM, Foot.SLDPRT, Hip M9xM6.SLDPRT, Hip.SLDPRT, Shin M9xM5.SLDPRT]
2018-04-06 removing old cc3220 mainboard
    [PiHat.kicad_pcb, build.cfg]
2018-04-07 starting PiHat firmware
    [PiHat.sch]
2018-04-07 DMA receive works
2018-04-17 latest version of 3D
    [ACRYLIC.SLDPRT, ASSEMBLY 1 . MODEL 19.SLDASM, Ass M6xM6xM6.SLDPRT, Assembly.SLDASM, BASE OF THE CONTROLLER.SLDPRT, BATTERY.SLDPRT, CONTROLLER PCB.SLDPRT, Controller PCB.SLDPRT]
2018-04-21 spi communication now works
2018-04-24 current changes
    [PiHat.kicad_pcb]
2018-04-28 external motor controller
    [external.kicad_pcb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]
2018-05-02 USART frequencies match
    [external.kicad_pcb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]
2018-05-03 working on USART issues
    [Usart.cpp, dma.cpp, main.cpp, main.h, usart.cpp, usart.h]
2018-05-08 threaded serial comms
2018-05-08 MA700 sensor
2018-05-11 side-shaft calibration more or less works
2018-05-12 working on calibration
    [Ass cover lid.SLDPRT, Ass.SLDPRT, Assembly.SLDASM, CHCS M3x10 s.SLDPRT, Controller PCB.SLDPRT, Foot.SLDPRT, Hip.SLDPRT, Leg cables.SLDPRT]
2018-05-12 calibration up and down
2018-05-14 fixed DMA so RasPI can get SPI response (again)
    [Usart.cpp, main.cpp, spi.cpp]
2018-05-15 USART comms also work with DMA
2018-05-21 starting new 3D
    [ARTICULATION.SLDPRT, ASS.SLDPRT, BATTERY.SLDPRT, BIGGER CONTROLLER.SLDPRT, COVER OD THE SHIN.SLDPRT, COVER OF THE ASS.SLDPRT, COVER OF THE BATTERY.SLDPRT, COVER OF THE THIGH.SLDPRT]
2018-05-23 new 3D
    [ACRYLIC.SLDPRT, ARM.SLDPRT, ARTICULATION OF THE SHOULDER.SLDPRT, ARTICULATION.SLDPRT, ASS.SLDPRT, CONTROLLER OF THE HEAD.SLDPRT, COVER OF THE ARM.SLDPRT, COVER OF THE ASS.SLDPRT]
2018-05-29 high voltage controller
    [external.kicad_pcb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]
2018-06-09 this was failed attempt to increase voltage
    [ACRYLIC.SLDPRT, ARM 1.SLDPRT, ASSEMBLY 1 . MODEL 19.SLDASM, Ass M6xM6xM6.SLDPRT, Assembly.SLDASM, BASE OF THE CONTROLLER.SLDPRT, BATTERY.SLDPRT, CHCS M3x10 s.SLDPRT]
2018-06-11 high voltage controller based on AUIRS20302
    [ARM.SLDPRT, COVER OF THE ARM.SLDPRT, COVER OF THE THIGH.SLDPRT, FOOT.SLDPRT, MirrorARM.SLDPRT, MirrorCOVER OF THE ARM.SLDPRT, MirrorFOOT.SLDPRT, SHIN.SLDPRT]
2018-06-17 3D updates
    [ARM 1.SLDPRT, BIGGER CONTROLLER.SLDPRT, COVER OF THE ARM 1.SLDPRT, LEFT SHOULDER.SLDPRT, Mainboard.kicad_pcb, Mainboard.sch, RIGHT SHOULDER.SLDPRT, TORSO.SLDPRT]
2018-06-18 buttons work with STM32F031K6U6
2018-06-22 components allocated
    [Mainboard.sch]
2018-06-22 started mainboard PCB
    [Mainboard.kicad_pcb, Mainboard.sch]
2018-06-23 3d updates for new controller
    [ACRYLIC.SLDPRT, ARM 1.SLDPRT, COVER OF THE ARM 1.SLDPRT, COVER OF THE SHIN 1.SLDPRT, HEAD.SLDPRT, LEFT SHOULDER.SLDPRT, Mainboard.kicad_pcb, Mainboard.sch]
2018-06-23 continue working on mainboard
    [Mainboard.kicad_pcb, Mainboard.sch]
2018-06-24 bigger current regulators
    [Mainboard.kicad_pcb, Mainboard.sch]
2018-06-25 more 3D
    [BIGGER CONTROLLER 1.SLDPRT, COVER OF THE FOREARM 1.SLDPRT, COVER OF THE SHIN.SLDPRT, COVER OF THE THIGH 1.SLDPRT, FOREARM 1.SLDPRT, THIGH 1.SLDPRT]
2018-06-29 5V with A1335
    [ARTICULATION 1.SLDPRT, ARTICULATION 2.SLDPRT, ARTICULATION 3.SLDPRT, ARTICULATION 4.SLDPRT, ASS 1.SLDPRT, ASS 2.SLDPRT, MirrorARTICULATION 1.SLDPRT, MirrorARTICULATION 2.SLDPRT]
2018-06-30 3.3V MA700
    [motor.kicad_pcb, motor.sch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]
2018-07-19 mainboard plain MOSFETS
    [COVER OF THE ARM.SLDPRT, Mainboard.kicad_pcb, Mainboard.sch]
2018-07-21 new drivers
    [motor.kicad_pcb, motor.sch]
2018-07-28 fixing schematic errors
    [Mainboard.kicad_pcb, Mainboard.sch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]
2018-08-12 started linearization for A1335
    [Mainboard.kicad_pcb, Mainboard.sch]
2018-08-18 problems with A1335 linearization, back to M700
    [motor.kicad_pcb, motor.sch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]
2018-08-22 working on arm rotation
    [ARM 1.SLDPRT, ARM.SLDPRT, ARTICULATION OF THE SHOULDER 1.SLDPRT, ARTICULATION OF THE SHOULDER 2.SLDPRT, ARTICULATION OF THE SHOULDER 3.SLDPRT, ARTICULATION OF THE SHOULDER 4.SLDPRT, BATTERY.SLDPRT, CONTROLLER BEHIND OF THE BATTERY.SLDPRT]
2018-09-03 3D - motor in the arm
    [ARM 1.SLDPRT, ARM 2.SLDPRT, ARM.SLDPRT, ARTICULATION OF THE ARM.SLDPRT, ARTICULATION OF THE SHOULDER 1.SLDPRT, ARTICULATION OF THE SHOULDER 2.SLDPRT, ARTICULATION OF THE SHOULDER 3.SLDPRT, ARTICULATION OF THE SHOULDER 4.SLDPRT]
2018-09-05 MA700 works (again). But USART doesn't :(
    [Calibrate.cpp, SpiMA700.cpp, Usart.cpp, main.cpp, main.h]
2018-10-10 added motors
    [148-2Z.SLDPRT, 6701 - 12x18x4 mm.SLDPRT, 6706 30x37x4 mm bearing.SLDPRT, 6803 17x26x5 mm bearing.SLDPRT, 7804K126_STAINLESS STEEL BALL BEARING.SLDPRT, 92000A076_18-8 SS METRIC PAN HEAD PHIL MACHINE SCREW.SLDPRT, Carrier.SLDPRT, ECG S assembly.SLDASM]
2018-10-13 FIR filtering
    [Carrier.SLDPRT, ECG S assembly.SLDASM, External rotor.SLDPRT, Housing base.SLDPRT, Housing cover.SLDPRT, Housing top cover.SLDPRT, Internal rotor.SLDPRT, Motor core S.SLDPRT]
2018-10-14 reorganized folders
    [Mainboard.kicad_pcb, Mainboard.sch, Mainboard_bom_.csv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]
2018-10-14 re-organizing folders more
    [motor.kicad_pcb, motor.sch, motor.xml]
2018-10-16 started motor with external sensors
    [6701 - 12x18x4 mm.SLDPRT, 6710 bearing 62x50x6 mm.SLDPRT, 7804K126_STAINLESS STEEL BALL BEARING.SLDPRT, 92000A076_18-8 SS METRIC PAN HEAD PHIL MACHINE SCREW.SLDPRT, External rotor.SLDPRT, Housing base.SLDPRT, Housing top.SLDPRT, Internal rotor.SLDPRT]
2018-11-06 Boost converter calculation
    [Mainboard-B.Cu.gbr, Mainboard-B.Mask.gbr, Mainboard-B.SilkS.gbr, Mainboard-Edge.Cuts.gbr, Mainboard-F.Cu.gbr, Mainboard-F.Mask.gbr, Mainboard-F.SilkS.gbr, Mainboard-NPTH.drl]
2018-11-17 starting new motor code
2018-11-17 renaming stuff
    [Schematic-Back.kicad_pcb, Schematic-Back.sch, motor.kicad_pcb, motor.sch, motor.xml, sensor A.kicad_pcb, sensor A.sch, sensor B.kicad_pcb]
2018-11-24 started external calibration
2018-11-26 calibration kindof works
2018-11-27 calibration good
2018-11-27 timer 3 ready for temperature reading
2018-12-09 motor 8 fixes; sensor flex PCB correction.
    [148-2Z.SLDPRT, 6706 30x37x4 mm bearing.SLDPRT, 6803 17x26x5 mm bearing.SLDPRT, Carrier.SLDPRT, Housing base.SLDPRT, Housing cover.SLDPRT, Magnet ring.SLDPRT, Magnetinc position ring.SLDPRT]
2018-12-15 current work
    [148 8x14x4 mm bearing.SLDPRT, 215317 21.5x31x7 mm.SLDPRT, 6700ZZ 10x15x4 mm.SLDPRT, 6701 - 12x18x4 mm.SLDPRT, 6705ZZ 25x32x4 mm.SLDPRT, 6801 bearing 12x21x5.SLDPRT, 6803 17x26x5 mm bearing.SLDPRT, 695 5x13x4 mm bearing.SLDPRT]
2018-12-22 finished Motor 8 and Motor 6 designs
    [215317 21.5x31x7 mm.SLDPRT, 6700ZZ 10x15x4 mm.SLDPRT, 6701 - 12x18x4 mm.SLDPRT, 6705ZZ 25x32x4 mm.SLDPRT, 6803 17x26x5 mm bearing.SLDPRT, 695 5x13x4 mm bearing.SLDPRT, 90119A104_LOW-CLEARANCE EXTERNAL RETAINING RING.SLDPRT, 92131A230_SINGLE-TURN SPIRAL INTERNAL RETAINING RING.SLDPRT]
2018-12-25 saving changes
    [12x1 mm spacer ring.SLDPRT, CLM-12 external retaining ring for sID 12 mm.SLDPRT, M3 x 3 mm pan head phillips screw.SLDPRT, Motor 6 - Assembly and GD&T.SLDDRW, motor.kicad_pcb, motor.sch]
2019-01-02 gyro is working
    [Bom.xlsx, motor.kicad_pcb, motor.xml, sensor A.kicad_pcb, sensor A.sch, sensor B.kicad_pcb]
2019-01-03 voltage and current ADC
2019-02-05 internal calibration
2019-02-15 up and down external calibration
2019-02-16 new version small motor
    [148 8x14x4 mm bearing.SLDPRT, 6701 bearing 12x18x4.SLDPRT, 6705 bearing 25x32x4.SLDPRT, CLM-12 external retaining ring for sID 12 mm.SLDPRT, Carrier.SLDPRT, Housing base.SLDPRT, Housing cover.SLDPRT, KLM-21 internal retaining ring for hID 21 mm.SLDPRT]
2019-02-25 rearrange 3D
    [12x1 mm SPACER RING - MOTOR 6.sldprt, 12x1 mm spacer ring.SLDPRT, 148 8x14x4 mm BEARING_7804K116 - MOTOR 6.SLDPRT, 148 8x14x4 mm bearing.SLDPRT, 148-2Z.SLDPRT, 148-2Z_7804K116 - MOTOR 8.SLDPRT, 6701 - 12x18x4 mm.SLDPRT, 6701 bearing 12x18x4.SLDPRT]
2019-03-31 new calibration
    [BIG PART - MOTOR 6.SLDASM, BIG PART MOTOR 8.SLDASM, Carrier.SLDPRT, Gearing assembly.SLDASM, Housing base.SLDPRT, Housing cover.SLDPRT, M3 x 3 mm pan head phillips screw.SLDPRT, MirrorPART 9 ROBOT DOG 8.SLDPRT]
2019-04-22 calibration confusion
2019-04-25 calibration and direction seems to be fine
2019-05-03 blocking SPI read/write. version before this one used DMA but had problems with it.
    [main.cpp, spi.cpp, spi.h]
2019-05-06 working on internal calibration
    [6701 bearing 12x18x4.SLDPRT, 6705 bearing 25x32x4.SLDPRT, Rotor tool.SLDPRT]
2019-05-31 started driver
    [ANOTHER THIGN - ROBOT DOG.SLDPRT, BATTERY - ROBOT DOG.SLDPRT, COMPUTER BOARD.SLDPRT, CONTROLLER BEHIND OF THE BATTERY - ROBOT DOG 38MM WITDH.SLDPRT, COVER OF THE BATTERY - ROBOT DOG.SLDPRT, COVER OF THE CAMERA BOARD - ROBOT DOG.SLDPRT, COVER OF THE COMPUTER BOARD - ROBOT DOG.SLDPRT, COVER OF THE LEFT LEG.SLDPRT]
2019-06-01 PID controller
2019-06-06 experimenting with PID
2019-06-08 playing with new servo control method
2019-06-15 started new mainboard
    [ANOTHER THIGN - ROBOT DOG.SLDPRT, COVER OF THE BATTERY - ROBOT DOG.SLDPRT, COVER OF THE CAMERA BOARD - ROBOT DOG.SLDPRT, COVER OF THE COMPUTER BOARD - ROBOT DOG.SLDPRT, COVER OF THE LEG - ROBOT DOG.SLDPRT, COVER OF THE THIGN - ROBOT DOG.SLDPRT, LEG - ROBOT DOG.SLDPRT, Mainboard.kicad_pcb]
2019-06-24 new mainboard
    [Mainboard-B.Cu.gbr, Mainboard-B.Mask.gbr, Mainboard-B.SilkS.gbr, Mainboard-Edge.Cuts.gbr, Mainboard-F.Cu.gbr, Mainboard-F.Mask.gbr, Mainboard-F.SilkS.gbr, Mainboard-In1.Cu.gbr]
2019-07-13 body V2
    [12x1 mm SPACER RING - MOTOR 6.sldprt, 148 8x14x4 mm BEARING_7804K116 - MOTOR 6.SLDPRT, 148-2Z_7804K116 - MOTOR 8.SLDPRT, 6706 30x37x4 mm BEARING_5972K213 - MOTOR 8.SLDPRT, 6801 BEARING 12x21x5_5972K212 - MOTOR 6.SLDPRT, 6803 17x26x5 mm BEARING_5972K213 - MOTOR 8.SLDPRT, 92000A076_18-8 SS METRIC PAN HEAD PHIL MACHINE SCREW_92000A076 - MOTOR 6.SLDPRT, ACRYLIC - ROBOT DOG.SLDPRT]
2019-07-20 changes changes
    [BATTERY - ROBOT DOG.SLDPRT, BIG PART - MOTOR 6.SLDASM, BIG PART MOTOR 8.SLDASM, BOM.xlsx, CONTROLLER BEHIND OF THE BATTERY - ROBOT DOG 38MM WITDH.SLDPRT, COVER OF THE BATTERY - ROBOT DOG.SLDPRT, Connector 1.SLDPRT, Connector 2.SLDPRT]
2019-10-25 donno what I'm committing
    [Mainboard-B.Cu.gbr, Mainboard-B.Mask.gbr, Mainboard-Edge.Cuts.gbr, Mainboard-F.Cu.gbr, Mainboard-F.Mask.gbr, Mainboard-F.SilkS.gbr, Mainboard-In1.Cu.gbr, Mainboard-In2.Cu.gbr]
2020-03-14 new model optimized for sub-assemblies and .URDF
    [12x1 mm SPACER RING - MOTOR 6.sldprt, 148 8x14x4 mm BEARING_7804K116 - MOTOR 6.SLDPRT, 148-2Z_7804K116 - MOTOR 8.SLDPRT, 6706 30x37x4 mm BEARING_5972K213 - MOTOR 8.SLDPRT, 6801 BEARING 12x21x5_5972K212 - MOTOR 6.SLDPRT, 6803 17x26x5 mm BEARING_5972K213 - MOTOR 8.SLDPRT, 92000A076_18-8 SS METRIC PAN HEAD PHIL MACHINE SCREW_92000A076 - MOTOR 6.SLDPRT, ACRYLIC.SLDPRT]
